WarpKVM/rk628-bridge-boards/rk628-2x22p/images/layer-bottom-copper.png

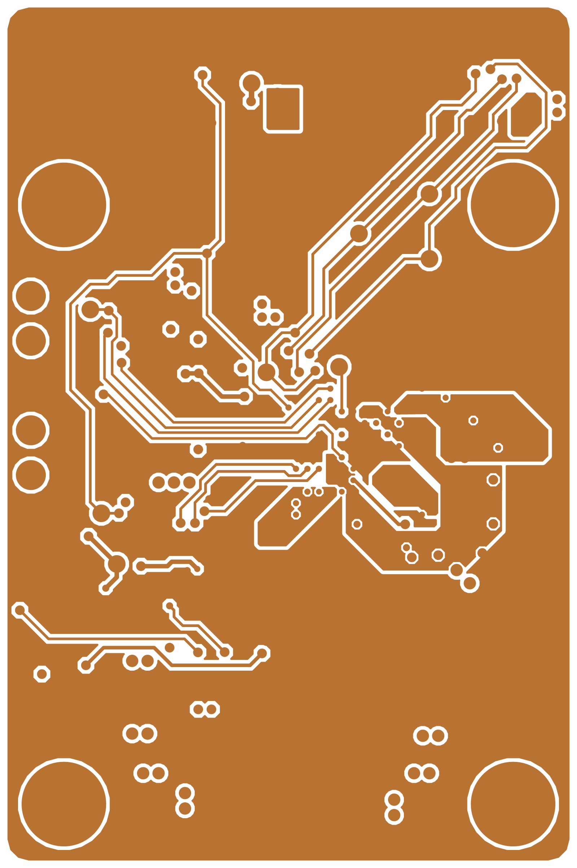
rk628-2x22p/images/layer-bottom-copper.png
