WarpKVM/rk628-bridge-boards/rk628-2x22p/images/layer-bottom-mask.png

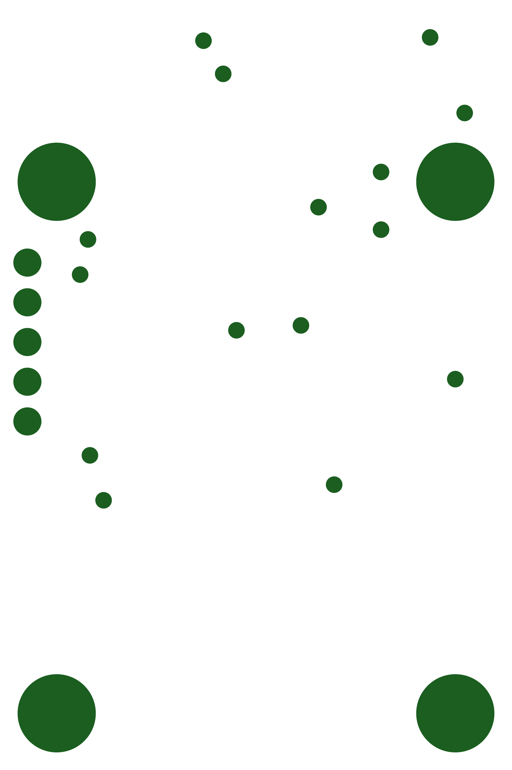
rk628-2x22p/images/layer-bottom-mask.png
