WarpKVM/rk628-bridge-boards/rk628-2x22p/images/layer-bottom-silk.png

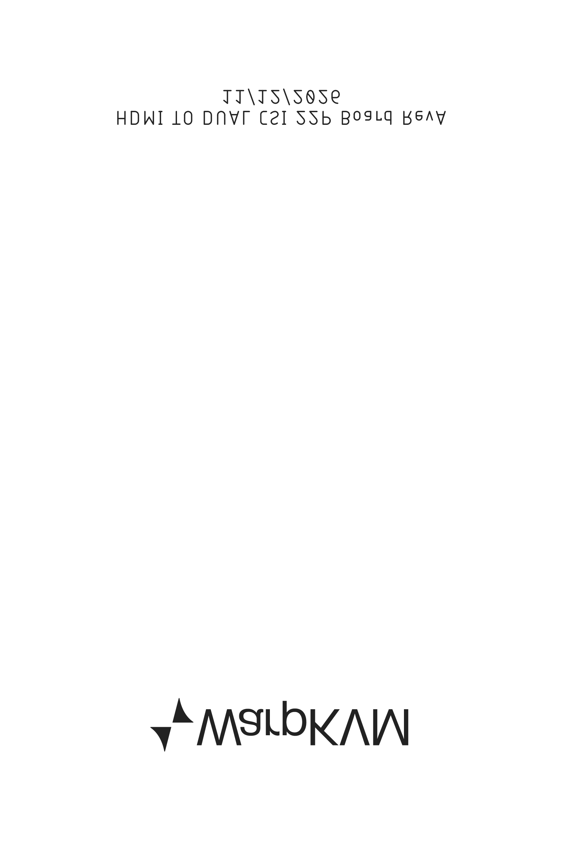
rk628-2x22p/images/layer-bottom-silk.png
