WarpKVM/rk628-bridge-boards/rk628-2x22p/images/layer-l2-inner-copper.png

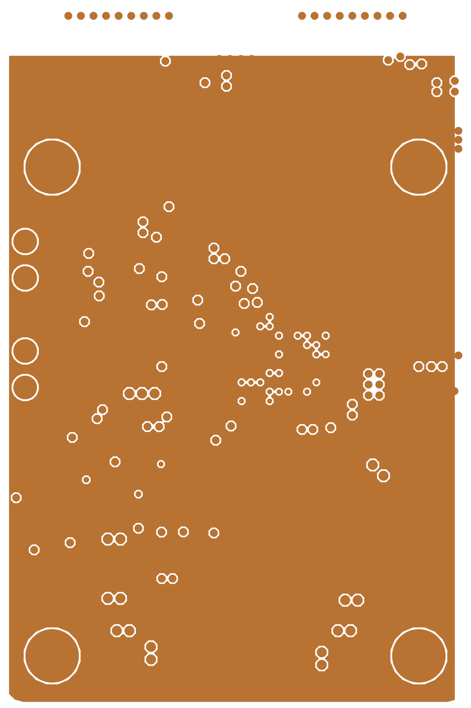
rk628-2x22p/images/layer-l2-inner-copper.png
