WarpKVM/rk628-bridge-boards/rk628-2x22p/images/layer-l3-inner-copper.png

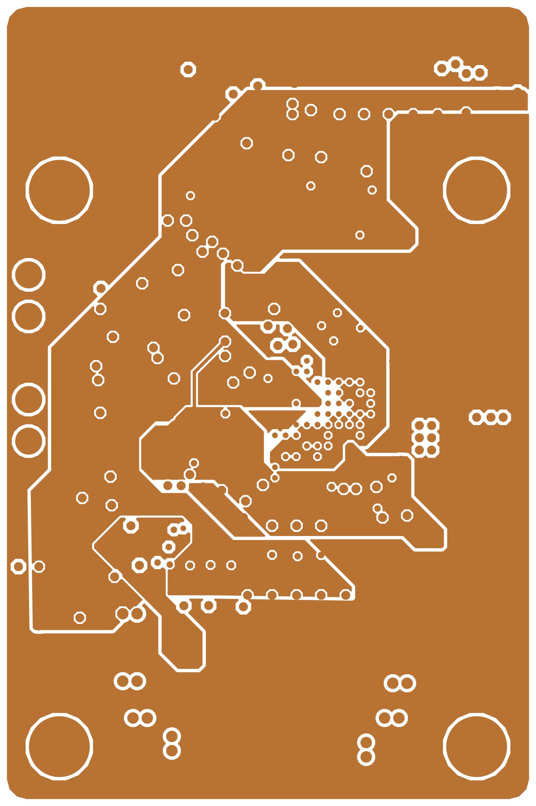
rk628-2x22p/images/layer-l3-inner-copper.png
