WarpKVM/rk628-bridge-boards/rk628-2x22p/images/layer-mechanical-outline.png

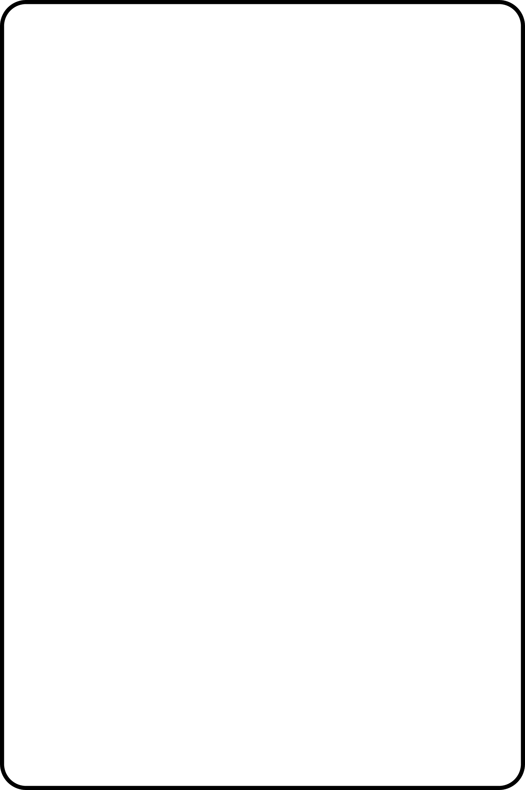
rk628-2x22p/images/layer-mechanical-outline.png
