WarpKVM/rk628-bridge-boards/rk628-2x22p/images/layer-top-copper.png

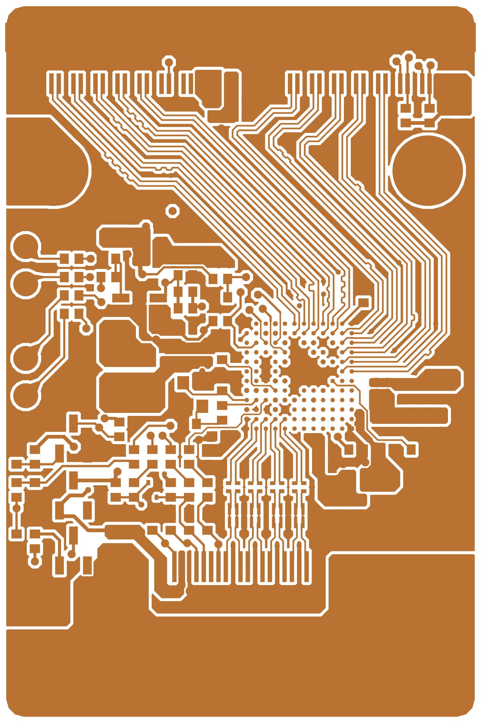
rk628-2x22p/images/layer-top-copper.png
