WarpKVM/rk628-bridge-boards/rk628-2x22p/images/layer-top-mask.png

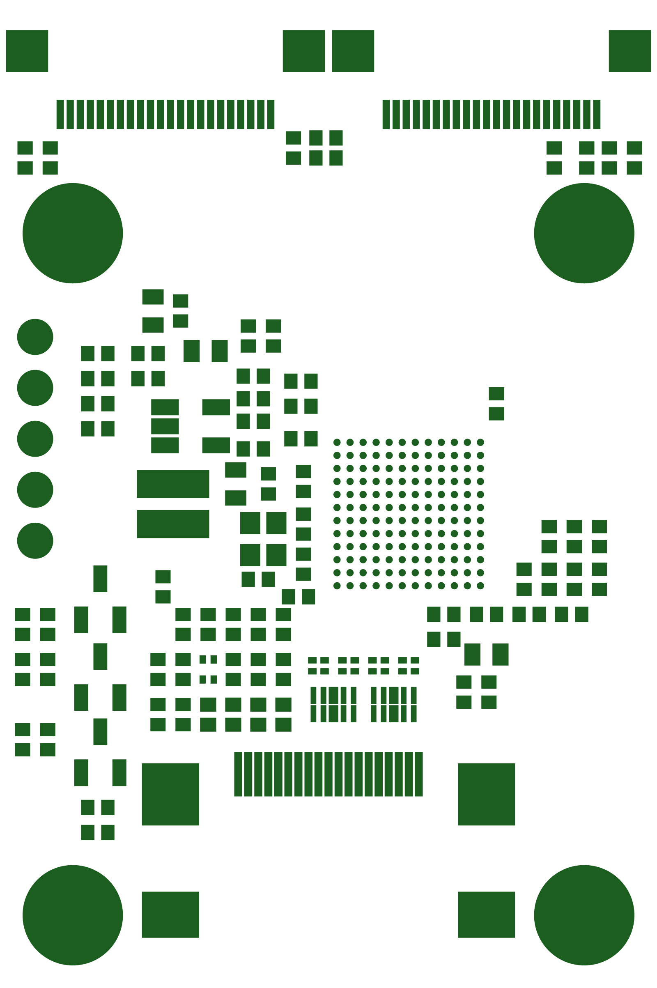
rk628-2x22p/images/layer-top-mask.png
