WarpKVM/rk628-bridge-boards/rk628-2x22p/images/layer-top-paste.png

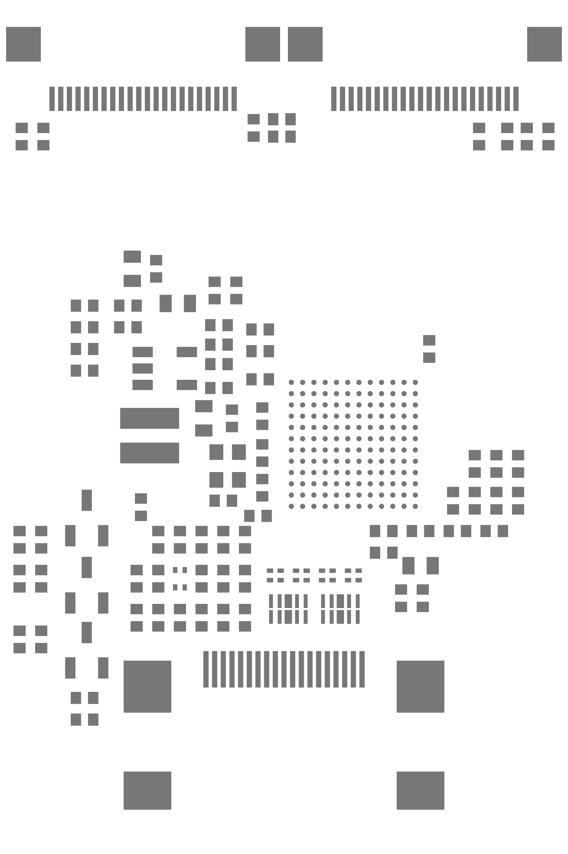
rk628-2x22p/images/layer-top-paste.png
