WarpKVM/rk628-bridge-boards/rk628-2x22p/images/layer-top-silk.png

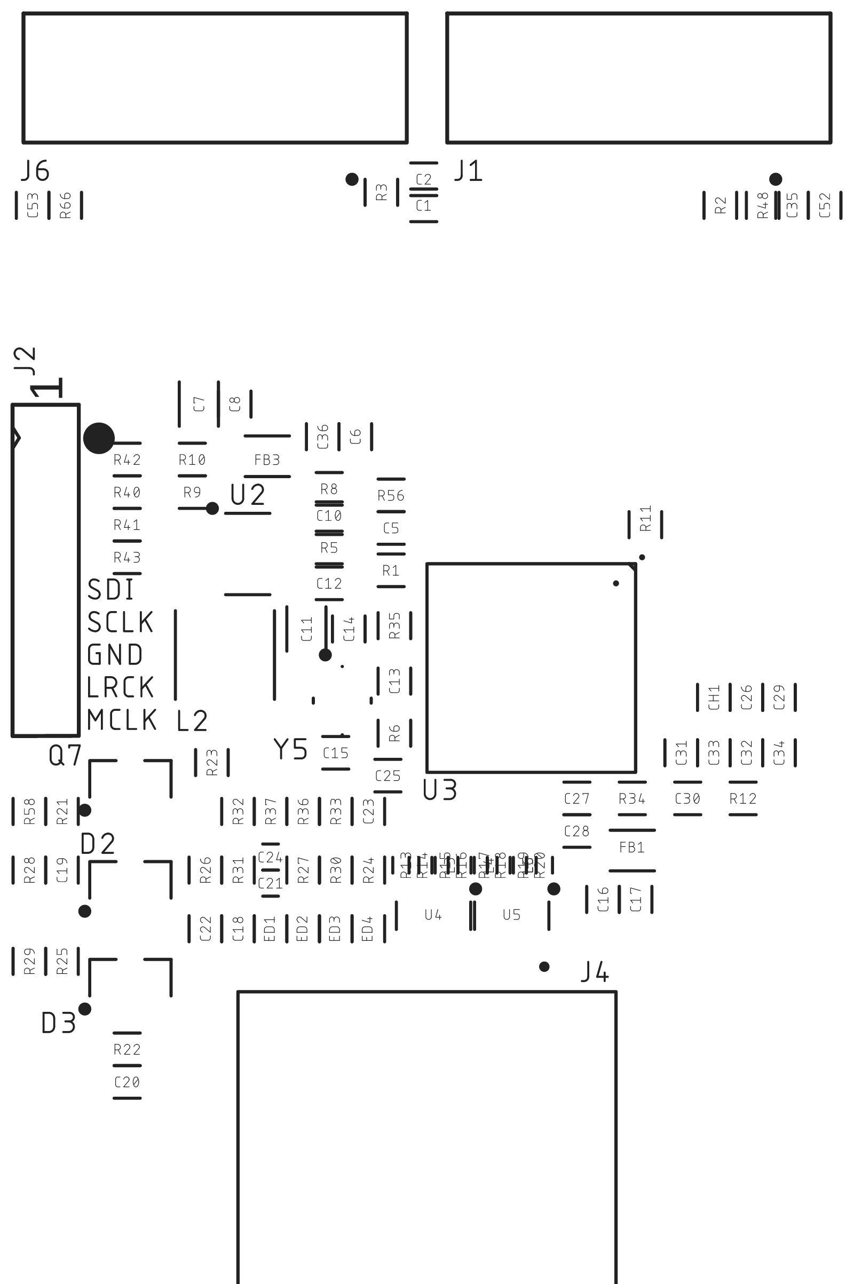
rk628-2x22p/images/layer-top-silk.png
