WarpKVM/rk628-bridge-boards/rk628-2x22p/images/render-bottom-store.png

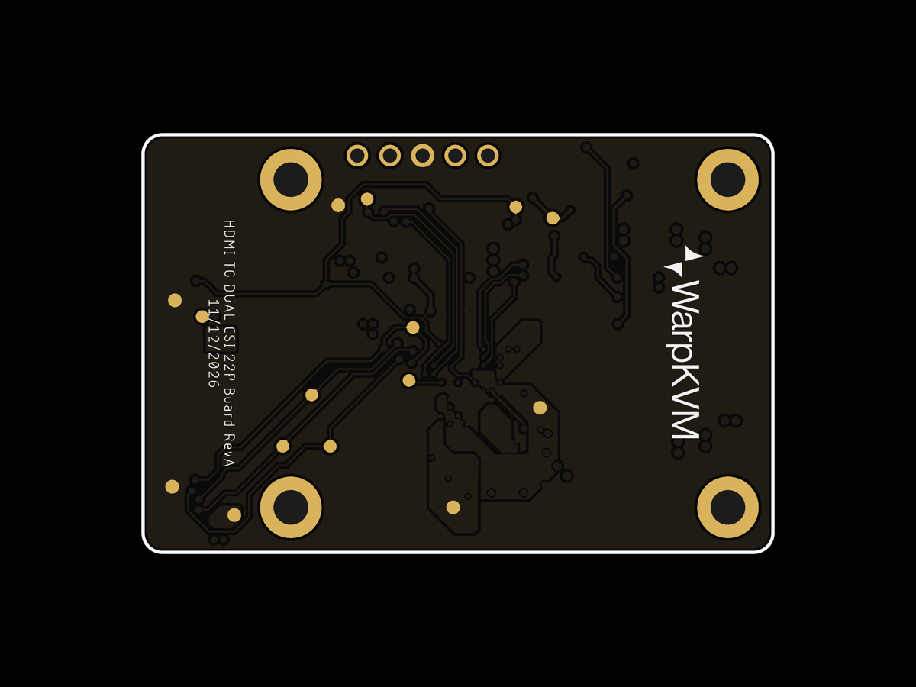
rk628-2x22p/images/render-bottom-store.png
