WarpKVM/rk628-bridge-boards/rk628-2x22p/images/render-bottom.png

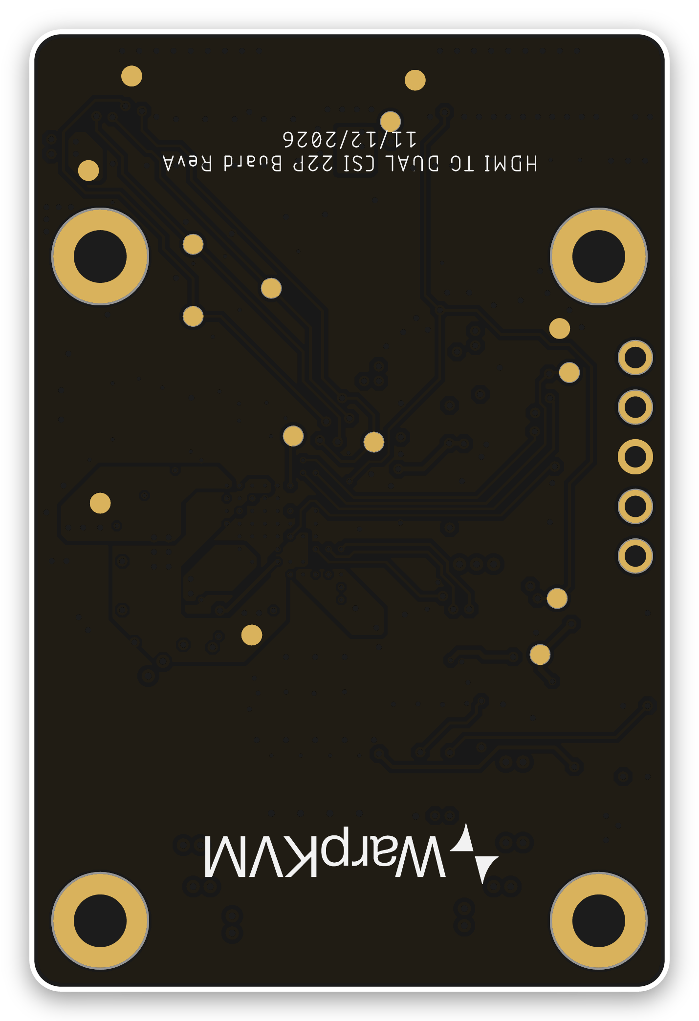
rk628-2x22p/images/render-bottom.png
