WarpKVM/rk628-bridge-boards/rk628-22p/images/layer-bottom-copper.png

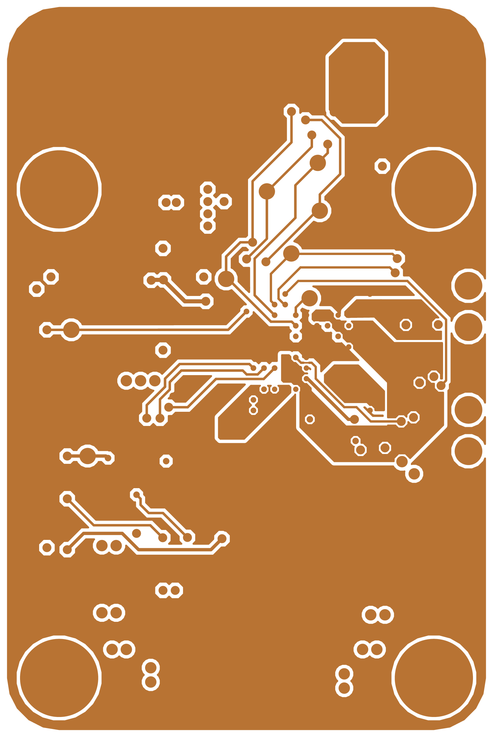
rk628-22p/images/layer-bottom-copper.png
