WarpKVM/rk628-bridge-boards/rk628-22p/images/layer-bottom-mask.png

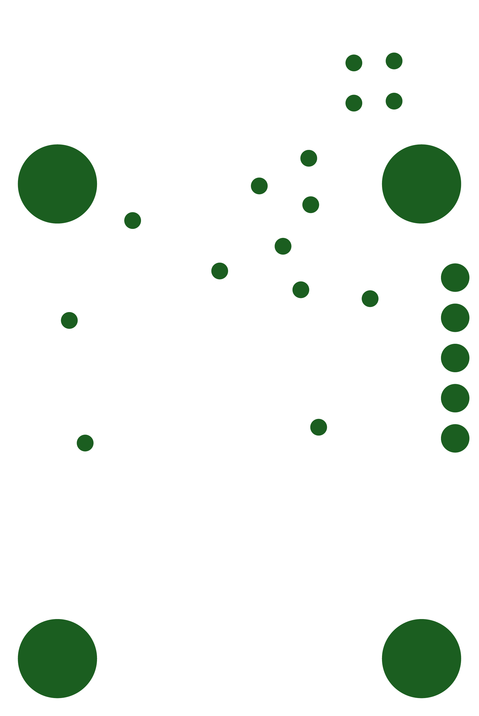
rk628-22p/images/layer-bottom-mask.png
