WarpKVM/rk628-bridge-boards/rk628-22p/images/layer-bottom-silk.png

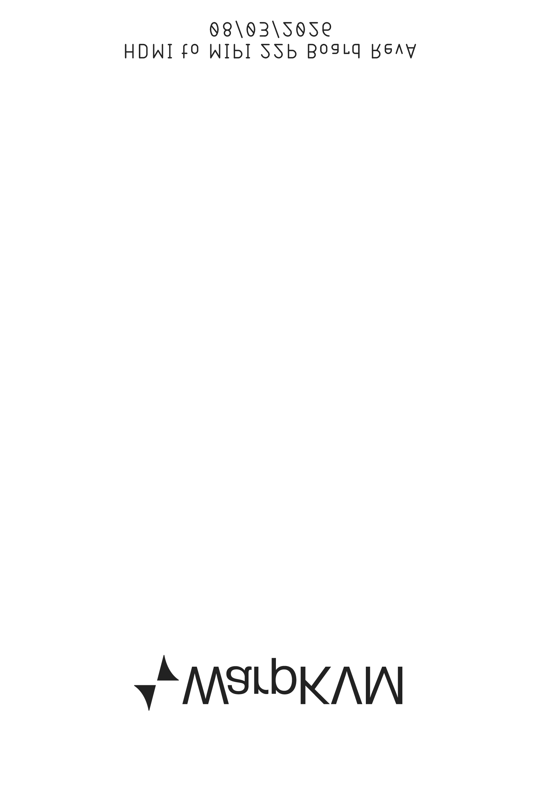
rk628-22p/images/layer-bottom-silk.png
