WarpKVM/rk628-bridge-boards/rk628-22p/images/layer-l2-inner-copper.png

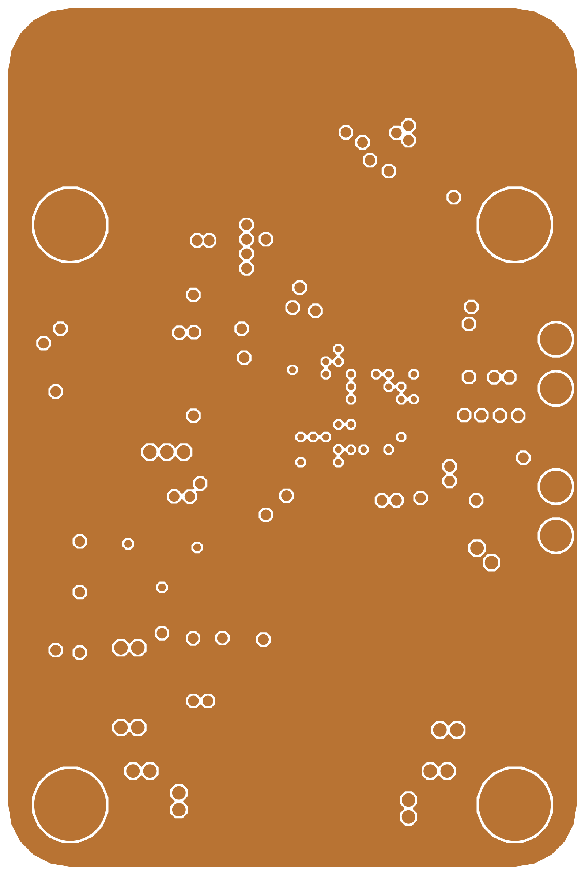
rk628-22p/images/layer-l2-inner-copper.png
