WarpKVM/rk628-bridge-boards/rk628-22p/images/layer-l3-inner-copper.png

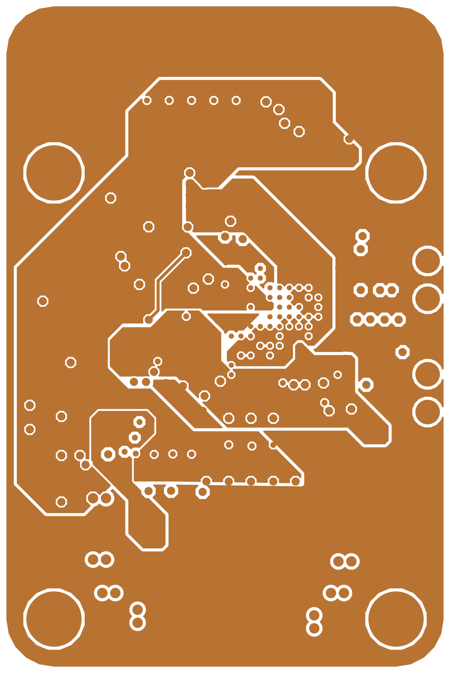
rk628-22p/images/layer-l3-inner-copper.png
