WarpKVM/rk628-bridge-boards/rk628-22p/images/layer-top-copper.png

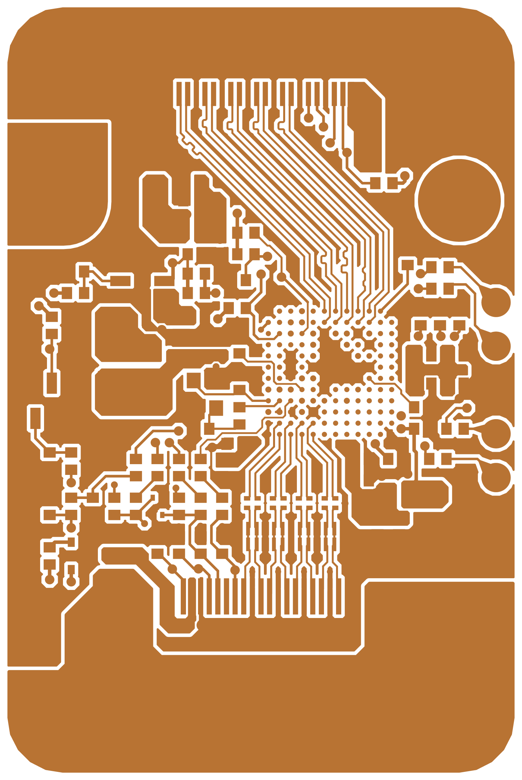
rk628-22p/images/layer-top-copper.png
