WarpKVM/rk628-bridge-boards/rk628-22p/images/layer-top-mask.png

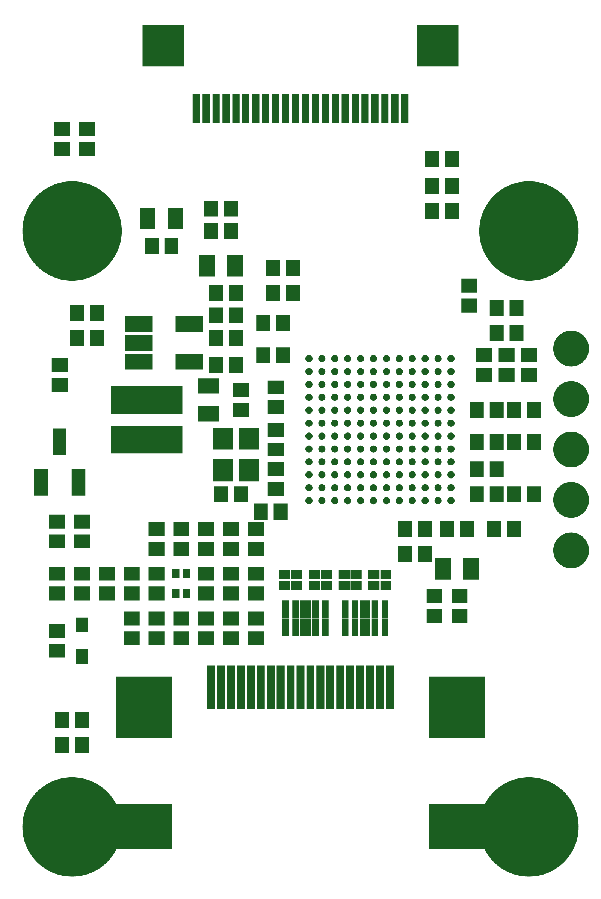
rk628-22p/images/layer-top-mask.png
