WarpKVM/rk628-bridge-boards/rk628-22p/images/layer-top-paste.png

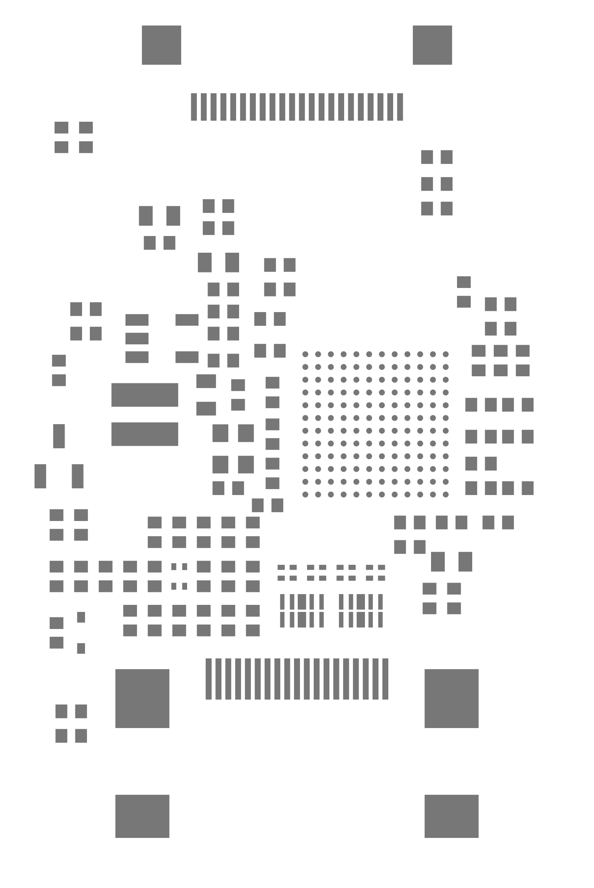
rk628-22p/images/layer-top-paste.png
