WarpKVM/rk628-bridge-boards/rk628-22p/images/layer-top-silk.png

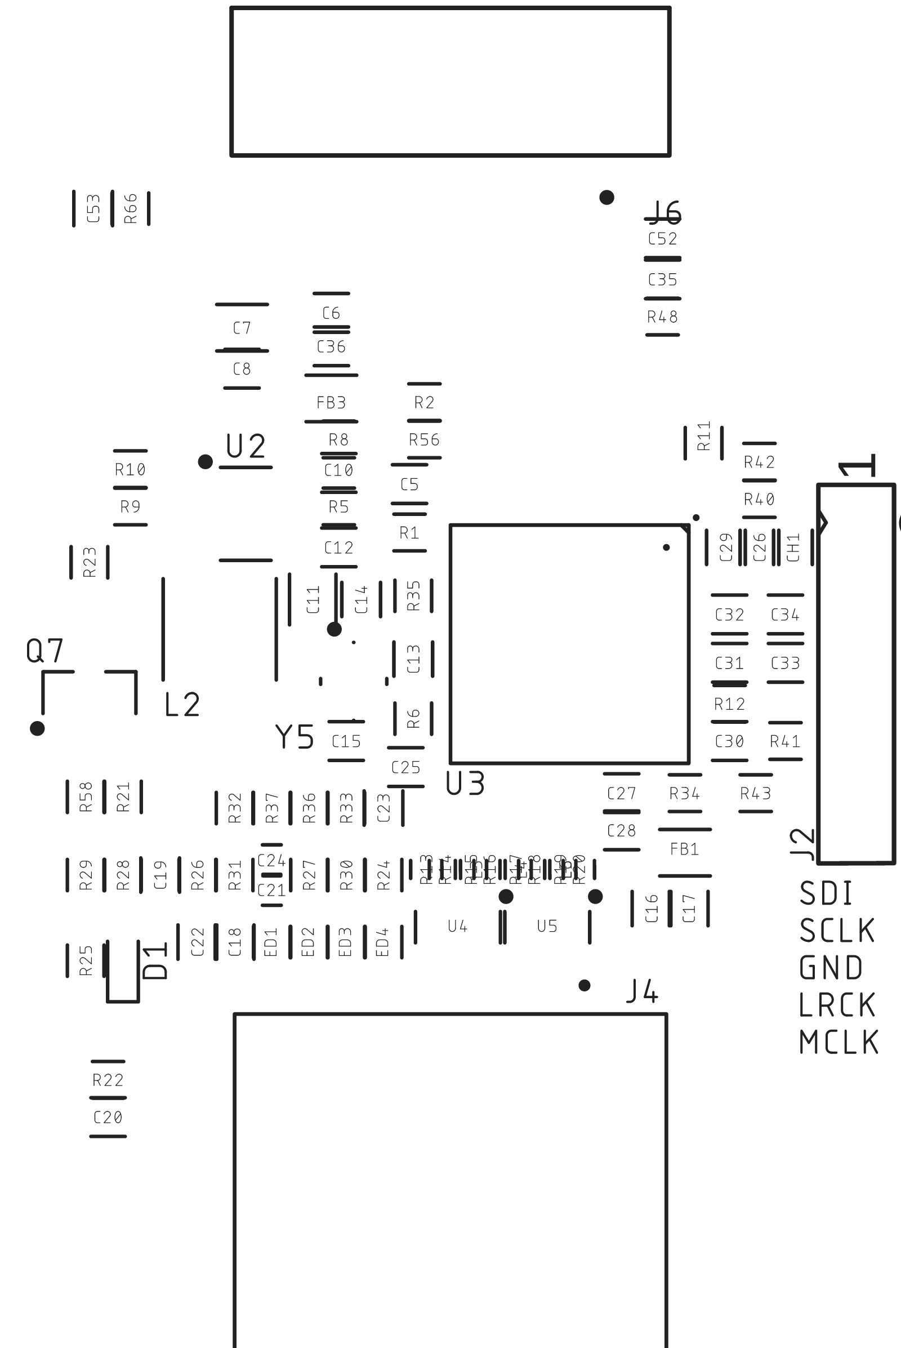
rk628-22p/images/layer-top-silk.png
