WarpKVM/rk628-bridge-boards/rk628-30p/images/layer-bottom-copper.png

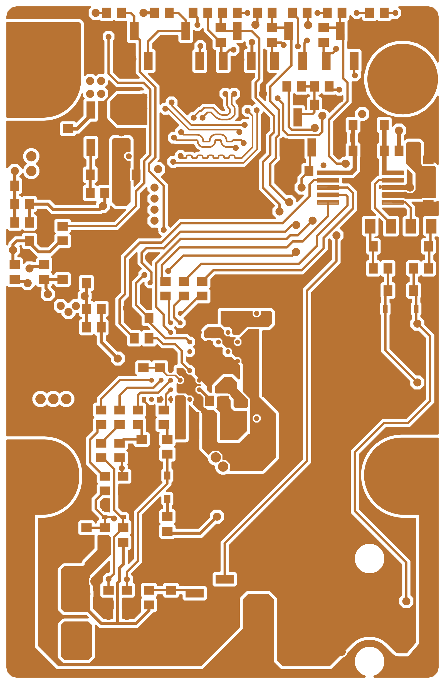
rk628-30p/images/layer-bottom-copper.png
