WarpKVM/rk628-bridge-boards/rk628-30p/images/layer-bottom-mask.png

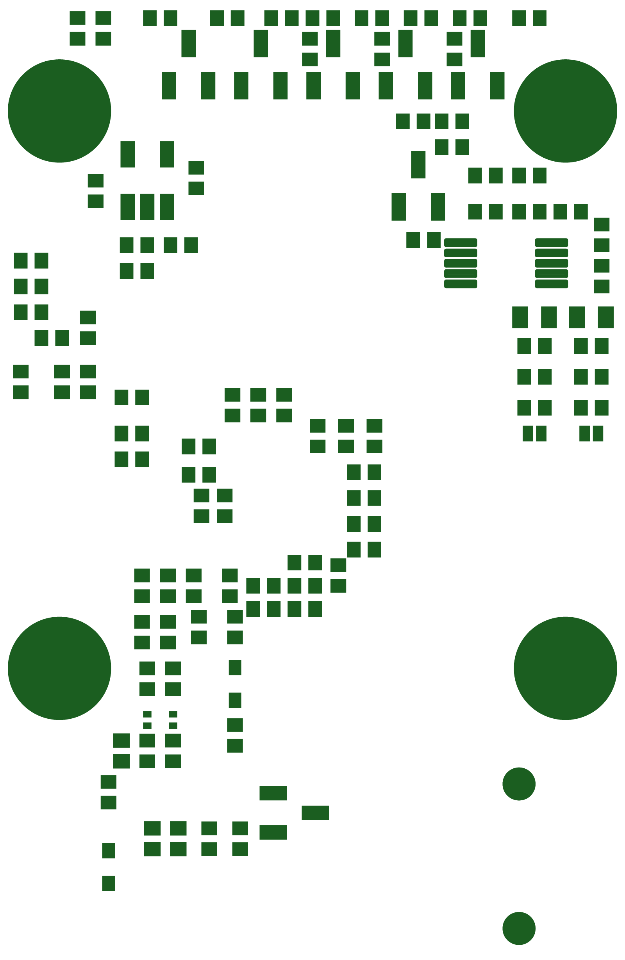
rk628-30p/images/layer-bottom-mask.png
