WarpKVM/rk628-bridge-boards/rk628-30p/images/layer-l2-inner-copper.png

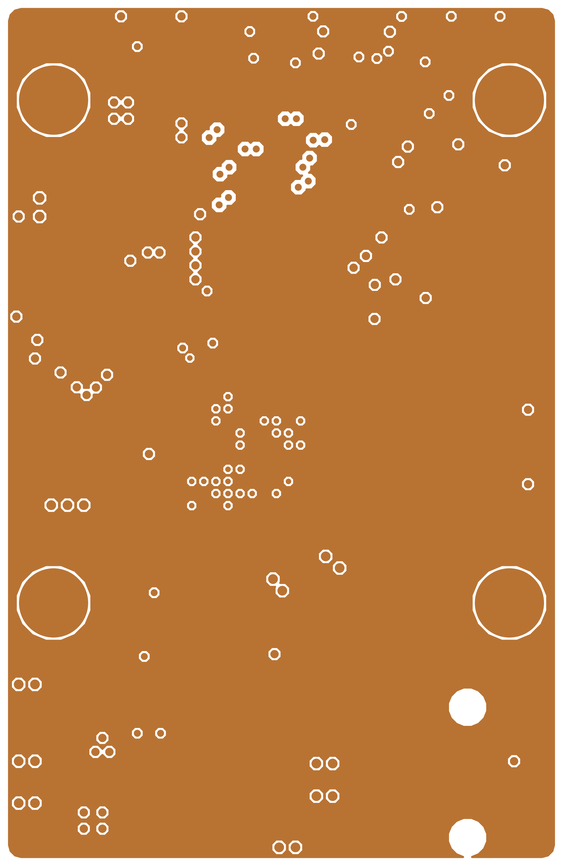
rk628-30p/images/layer-l2-inner-copper.png
