WarpKVM/rk628-bridge-boards/rk628-30p/images/layer-top-paste.png

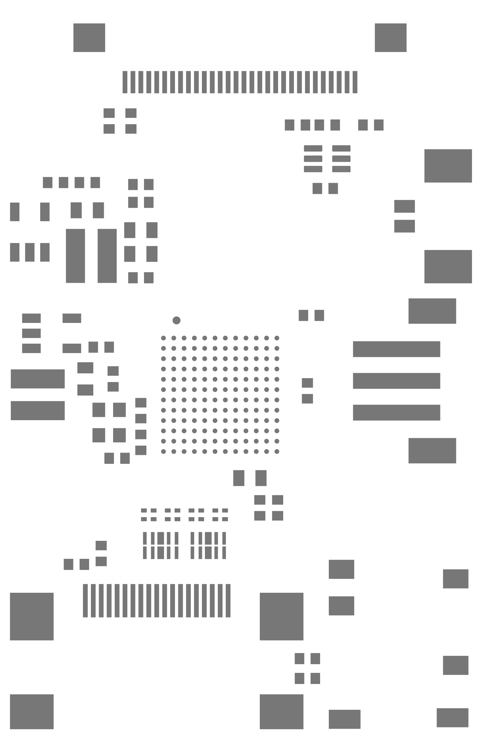
rk628-30p/images/layer-top-paste.png
