WarpKVM/rk628-bridge-boards/rk628-30p/images/layer-top-silk.png

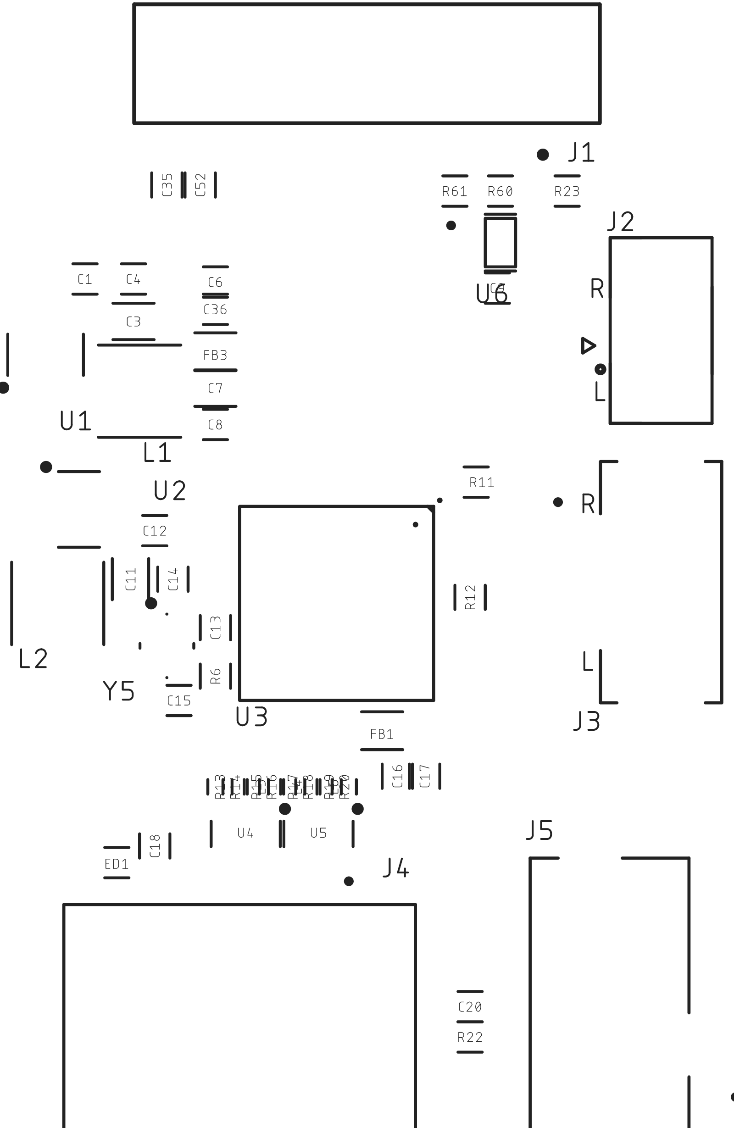
rk628-30p/images/layer-top-silk.png
