WarpKVM/rk628-bridge-boards/rk628-22p/fab/bom-not-fitted.csv

Designator | Value | Footprint | JLCPCB Part # | MF | MP | EQUIV_OK | Reason
C21 | NC/10pF 50V | CAP_0201 |  |  |  |  | NC/ in value
C24 | NC/10pF 50V | CAP_0201 |  |  |  |  | NC/ in value
J2 | NC/1x5 Pin Header | HDR_1X05_2.54MM_TH_ST | C2932699 |  |  |  | NC/ in value
L3 | NC/BCMF062P120T | BCMF062P120T |  |  |  |  | NC/ in value
L4 | NC/BCMF062P120T | BCMF062P120T |  |  |  |  | NC/ in value
L5 | NC/BCMF062P120T | BCMF062P120T |  |  |  |  | NC/ in value
L6 | NC/BCMF062P120T | BCMF062P120T |  |  |  |  | NC/ in value
MNT1 | MOUNTHOLE_M2.5_4.8MM_PAD | MOUNTHOLE_M2.5_4.8MM_PAD |  |  |  |  | MOUNTHOLE in value
MNT2 | MOUNTHOLE_M2.5_4.8MM_PAD | MOUNTHOLE_M2.5_4.8MM_PAD |  |  |  |  | MOUNTHOLE in value
MNT3 | MOUNTHOLE_M2.5_4.8MM_PAD | MOUNTHOLE_M2.5_4.8MM_PAD |  |  |  |  | MOUNTHOLE in value
MNT4 | MOUNTHOLE_M2.5_4.8MM_PAD | MOUNTHOLE_M2.5_4.8MM_PAD |  |  |  |  | MOUNTHOLE in value
R1 | NC/2.2kΩ 1% | RES_0402 | C25879 |  |  |  | NC/ in value
R48 | NC/2.2kΩ 1% | RES_0402 | C25879 |  |  |  | NC/ in value
TP1 | TESTPOINT_1MM | TEST_POINT_1MM |  |  |  |  | TEST_POINT in footprint
TP2 | TESTPOINT_1MM | TEST_POINT_1MM |  |  |  |  | TEST_POINT in footprint
TP3 | TESTPOINT_1MM | TEST_POINT_1MM |  |  |  |  | TEST_POINT in footprint
TP4 | TEST_POINT_1MM_0.5MM | TEST_POINT_1MM |  |  |  |  | TEST_POINT in footprint
TP5 | TESTPOINT_1MM | TEST_POINT_1MM |  |  |  |  | TEST_POINT in footprint
TP6 | TESTPOINT_1MM | TEST_POINT_1MM |  |  |  |  | TEST_POINT in footprint
TP7 | TESTPOINT_1MM | TEST_POINT_1MM |  |  |  |  | TEST_POINT in footprint
TP8 | TESTPOINT_1MM | TEST_POINT_1MM |  |  |  |  | TEST_POINT in footprint
TP9 | TESTPOINT_1MM | TEST_POINT_1MM |  |  |  |  | TEST_POINT in footprint
TP10 | TESTPOINT_1MM | TEST_POINT_1MM |  |  |  |  | TEST_POINT in footprint
TP11 | TESTPOINT_1MM | TEST_POINT_1MM |  |  |  |  | TEST_POINT in footprint
TP12 | TEST_POINT_1MM_0.5MM | TEST_POINT_1MM |  |  |  |  | TEST_POINT in footprint
TP13 | TEST_POINT_1MM_0.5MM | TEST_POINT_1MM |  |  |  |  | TEST_POINT in footprint
TP14 | TEST_POINT_1MM_0.5MM | TEST_POINT_1MM |  |  |  |  | TEST_POINT in footprint
TP15 | TEST_POINT_1MM_0.5MM | TEST_POINT_1MM |  |  |  |  | TEST_POINT in footprint
