WarpKVM/rk628-bridge-boards/rk628-30p/fab/bom-not-fitted.csv

Designator | Value | Footprint | JLCPCB Part # | MF | MP | EQUIV_OK | Reason
C21 | NC/10pF 50V | CAP_0201 |  |  |  |  | NC/ in value
C24 | NC/10pF 50V | CAP_0201 |  |  |  |  | NC/ in value
L3 | NC/BCMF062P120T | BCMF062P120T |  |  |  |  | NC/ in value
L4 | NC/BCMF062P120T | BCMF062P120T |  |  |  |  | NC/ in value
L5 | NC/BCMF062P120T | BCMF062P120T |  |  |  |  | NC/ in value
L6 | NC/BCMF062P120T | BCMF062P120T |  |  |  |  | NC/ in value
MNT1 | MOUNTHOLE_M2.5_4.8MM_PAD | MOUNTHOLE_M2.5_4.8MM_PAD |  |  |  |  | MOUNTHOLE in value
MNT2 | MOUNTHOLE_M2.5_4.8MM_PAD | MOUNTHOLE_M2.5_4.8MM_PAD |  |  |  |  | MOUNTHOLE in value
MNT3 | MOUNTHOLE_M2.5_4.8MM_PAD | MOUNTHOLE_M2.5_4.8MM_PAD |  |  |  |  | MOUNTHOLE in value
MNT4 | MOUNTHOLE_M2.5_4.8MM_PAD | MOUNTHOLE_M2.5_4.8MM_PAD |  |  |  |  | MOUNTHOLE in value
R7 | NC/2.2kΩ 1% | RES_0402 | C25879 |  |  |  | NC/ in value
R49 | NC/0Ω 1% | RES_0402 | C17168 |  |  |  | NC/ in value
R50 | NC/2.2kΩ 1% | RES_0402 | C25879 |  |  |  | NC/ in value
R52 | NC/0Ω 1% | RES_0402 | C17168 |  |  |  | NC/ in value
R53 | NC/2.2kΩ 1% | RES_0402 | C25879 |  |  |  | NC/ in value
R55 | NC/0Ω 1% | RES_0402 | C17168 |  |  |  | NC/ in value
R59 | NC/1kΩ 1% | RES_0402 |  |  |  |  | NC/ in value
R60 | NC/0Ω 1% | RES_0402 | C17168 |  |  |  | NC/ in value
R61 | NC/1MΩ 1% | RES_0402 | C26083 |  |  |  | NC/ in value
R63 | NC/100kΩ 1% | RES_0402 | C25741 |  |  |  | NC/ in value
TP1 | TEST_POINT_1MM | TEST_POINT_0.5MM |  |  |  |  | TEST_POINT in footprint
TP2 | TEST_POINT_1MM | TEST_POINT_0.5MM |  |  |  |  | TEST_POINT in footprint
TP3 | TEST_POINT_1MM | TEST_POINT_0.5MM |  |  |  |  | TEST_POINT in footprint
TP4 | TEST_POINT_1MM_0.5MM | TEST_POINT_0.5MM |  |  |  |  | TEST_POINT in footprint
U9 | NC/ME2808A33XG | SOT-23-3 | C2925762 | MICRONE(Nanjing Micro One Elec) | ME2808A33XG |  | NC/ in value
