WarpKVM/rk628-bridge-boards/rk628-22p/fab/assembly/partlist.txt

Partlist: RK628H 22P Board RevA

Qty Value                    Device                                             Package                                   Parts                                                                                  Description                         JLC-ROTATION JLC-X-OFFSET JLC-Y-OFFSET JLCPCB    JLC_FOOTPRINT JLC_PARTS_TYPE MF                                   MP                   VALUE            

18  0.1uF 16V                CAP_0402_0.1UF_16V_X7R                             CAP_0402                                  C5, C8, C14, C16, C18, C19, C20, C25, C27, C29, C30, C31, C32, C34, C35, C36, C53, CH1                                                                            C1525                   BASIC          Samsung Electro-Mechanics            CL05B104KO5NNNC      0.1uF 16V        

1   0.5K-GX-22PWB-R          CONN_FFC_1X22_SH_0.5MM_SM_RA_0.5K-GX-22PWB-R       CONN_FFC_1X22_0.5MM_SM_RA_0.5K-GX-22PWB-R J6                                                                                                                                                                C53223210                              GUOCONN                              0.5K-GX-22PWB-R      0.5K-GX-22PWB-R  

2   1.8kO 1%                 RES_0402_1K8_1%                                    RES_0402                                  R26, R27                                                                                                                                                          C2909310                               FOJAN                                FRC0402F1801TS       1.8kO 1%         

2   100kO 1%                 RES_0402_100K_1%_1/16W                             RES_0402                                  R10, R29                                                                                                                                                          C25741                  Basic          UNI-ROYAL(Uniroyal Elec)             0402WGF1003TCE       100kO 1%         

1   100pF 50V                CAP_0402_100PF_50V_NP0                             CAP_0402                                  C10                                                                                                                                                               C106200                                YAGEO                                CC0402JRNPO9BN101    100pF 50V        

4   100O 1%                  RES_0402_100R_1%                                   RES_0402                                  R24, R30, R31, R35                                                                                                                                                C25076                  Basic          UNI-ROYAL(Uniroyal Elec)             0402WGF1000TCE       100O 1%          

4   10kO 1%                  RES_0402_10K_1%_1/16W                              RES_0402                                  R9, R12, R21, R56                                                                                                                                                 C2906861                               FOJAN                                FRC0402F1002TS       10kO 1%          

8   10uF 10V                 CAP_0402_10UF_10V_X5R                              CAP_0402                                  C6, C12, C17, C23, C26, C28, C33, C52                                                                                                                             C315248                                Samsung Electro-Mechanics            CL05A106MP5NUNC      10uF 10V         

1   110kO 1%                 RES_0402_110K_1%                                   RES_0402                                  R5                                                                                                                                                                C2909311                               FOJAN                                FRC0402F1103TS       110kO 1%         

1   120kO 1%                 RES_0402_120K_1%                                   RES_0402                                  R8                                                                                                                                                                C2909314                               FOJAN                                FRC0402F1203TS       120kO 1%         

2   120O 2A                  FERRITE_0603_120R_2A                               IND_0603                                  FB1, FB3                                                                                                                                                          C14709    TRUE          Basic          Murata Electronics                   BLM18PG121SN1D       120O 2A          

2   1MO 1%                   RES_0402_1M_1%                                     RES_0402                                  R22, R66                                                                                                                                                          C26083                  Basic          UNI-ROYAL(Uniroyal Elec)             0402WGF1004TCE       1MO 1%           

1   1kO 1%                   RES_0402_1K_1%                                     RES_0402                                  R28                                                                                                                                                               C106235                                YAGEO                                RC0402FR-071KL       1kO 1%           

1   1uF 25V                  CAP_0402_1UF_25V_X5R                               CAP_0402                                  C22                                                                                                                                                               C52923                  Basic          Samsung Electro-Mechanics            CL05A105KA5NQNC      1uF 25V          

1   2.2kO 1%                 RES_0402_2K2_1%                                    RES_0402                                  R2                                                                                                                                                                C25879                  Basic          UNI-ROYAL(Uniroyal Elec)             0402WGF2201TCE       2.2kO 1%         

1   2.2uH 2.84A              IND_3MM_SQ_2.2UH_2.84A_1.2MM_HEIGHT                IND_3MM_SQ_1.2MM_HEIGHT                   L2                                                                                                                                                                C404494                                TDK                                  VLS3012HBX-2R2M      2.2uH 2.84A      

8   2.2O 5%                  RES_0201_2R2_5%                                    RES_0201                                  R13, R14, R15, R16, R17, R18, R19, R20                                                                                                                            C102714                                UNI-ROYAL(Uniroyal Elec)             0201WMJ022JTEE       2.2O 5%          

2   22uF 10V                 CAP_0603_22UF_10V_X5R                              CAP_0603                                  C7, C11                                                                                                                                                           C7432770                               Chinocera                            HGC0603R5226M100NTHJ 22uF 10V         

5   22O 1%                   RES_0402_22R_1%                                    RES_0402                                  R6, R32, R33, R36, R37                                                                                                                                            C25092                  Basic          UNI-ROYAL(Uniroyal Elec)             0402WGF220JTCE       22O 1%           

1   24MHz 20pF               CRYSTAL_SMD2016-4P_24MHZ_20PF_10PPM_T201624MLBDE2X CRYSTAL_SMD2016-4P                        Y5                                                                                                                                                                C20885025                              Yajingxin                            T201624MLBDE2X       24MHz 20pF       

1   27kO 1%                  RES_0402_27K_1%                                    RES_0402                                  R25                                                                                                                                                               C138022                                YAGEO                                RC0402FR-0727KL      27kO 1%          

1   2kO 1%                   RES_0402_2K_1%_1/16W                               RES_0402                                  R34                                                                                                                                                               C4109                   Basic          UNI-ROYAL(Uniroyal Elec)             0402WGF2001TCE       2kO 1%           

2   33pF 50V                 CAP_0402_33PF_50V                                  CAP_0402                                  C13, C15                                                                                                                                                          C1562                                  FH (Guangdong Fenghua Advanced Tech) 0402CG330J500NT      33pF 50V         

4   33O 1%                   RES_0402_33R_1%                                    RES_0402                                  R40, R41, R42, R43                                                                                                                                                C25105                  Basic          UNI-ROYAL(Uniroyal Elec)             0402WGF330JTCE       33O 1%           

1   4.02kO 1%                RES_0402_4K02_1%                                   RES_0402                                  R11                                                                                                                                                               C324800                                FH (Guangdong Fenghua Advanced Tech) RC-02K4021FT         4.02kO 1%        

1   4.7kO 1%                 RES_0402_4K7_1%                                    RES_0402                                  R23                                                                                                                                                               C105871                                YAGEO                                RC0402FR-074K7L      4.7kO 1%         

1   51kO 1%                  RES_0402_51K_1%                                    RES_0402                                  R58                                                                                                                                                               C25794                  Basic          UNI-ROYAL(Uniroyal Elec)             0402WGF5102TCE       51kO 1%          

2   BTRD10A03                TVS_ESD_4CH_10P_PASS_THRU_BTRD10A03                DFN2510-10                                U4, U5                                                                                 ESD and Surge protection diodes TVS                                        C42375217 TRUE                         KUU                                  BTRD10A03            BTRD10A03        

1   HC-HDMI0019T-4           CONN_HDMI_A_HC-HDMI0019T-4                         CONN_HDMI_A_SMT_RA_HC-HDMI0019T-4         J4                                                                                                                                                   2.75         C7501811                               Hong Cheng                           HC-HDMI0019T-4       HC-HDMI0019T-4   

4   KLXES15AAA1              TVS_ESD_1CH_BI_KLXES15AAA1                         TVS_0402                                  ED1, ED2, ED3, ED4                                                                                                                                                C2892490                               KUU                                  KLXES15AAA1          KLXES15AAA1      

4   MOUNTHOLE_M2.5_4.8MM_PAD MOUNTHOLE_M2.5_4.8MM_PAD                           MOUNTHOLE_M2.5_4.8MM_PAD                  MNT1, MNT2, MNT3, MNT4                                                                                                                                                                                                                                                              

2   NC/10pF 50V              CAP_0201_DNP_10PF_50V                              CAP_0201                                  C21, C24                                                                                                                                                                                                                                                           NC/10pF 50V      

1   NC/1x5 Pin Header        HDR_1X05_DNP_2.54MM_TH_ST                          HDR_1X05_2.54MM_TH_ST                     J2                                                                                                                         0            5.08         0            C2932699                                                                                         NC/1x5 Pin Header

2   NC/2.2kO 1%              RES_0402_DNP_2K2_1%                                RES_0402                                  R1, R48                                                                                                                                                           C25879                  Basic                                                                    NC/2.2kO 1%      

4   NC/BCMF062P120T          BCMF062P120T_BCMF062P120T_NC                       BCMF062P120T                              L3, L4, L5, L6                                                                                                                                                                                                                                                     NC/BCMF062P120T  

1   RK628H                   IF_VIDEO_BRIDGE_RK628F/H_RK628H                    WBBGA144_8X8MM                            U3                                                                                                                                                                C45369093                              Rockchip                             RK628H               RK628H           

1   S8050                    NPN_S8050                                          SOT-23-3                                  Q7                                                                                                                                                                C2146                                                                                            S8050            

1   SD103AX                  SD103AX                                            SD103AX                                   D1                                                                                                                                                                C20416650                              BORN                                 SD103AX              SD103AX          

1   SY8089A1AAC              SY8089A1AAC_SY8089A1AAC                            SOT95P285X110-5N                          U2                                                                                                                         180          0            0            C479074                                Silergy Corp                         SY8089A1AAC          SY8089A1AAC      

10  TESTPOINT_1MM            TESTPOINT_1MM                                      TEST_POINT_1MM                            TP1, TP2, TP3, TP5, TP6, TP7, TP8, TP9, TP10, TP11                                                                                                                                                                                                                                  

5   TEST_POINT_1MM_0.5MM     TESTPOINT_1MM                                      TEST_POINT_1MM                            TP4, TP12, TP13, TP14, TP15
