WarpKVM/rk628-bridge-boards/rk628-22p/fab/bom-jlcpcb.csv

QTY | Comment | Designator | Footprint | JLCPCB Part #(optional) | MF | MP | EQUIV_OK
18 | 0.1uF 16V | C5, C8, C14, C16, C18, C19, C20, C25, C27, C29, C30, C31, C32, C34, C35, C36, C53, CH1 | CAP_0402 | C1525 | Samsung Electro-Mechanics | CL05B104KO5NNNC
8 | 10uF 10V | C6, C12, C17, C23, C26, C28, C33, C52 | CAP_0402 | C315248 | Samsung Electro-Mechanics | CL05A106MP5NUNC
2 | 22uF 10V | C7, C11 | CAP_0603 | C7432770 | Chinocera | HGC0603R5226M100NTHJ
1 | 100pF 50V | C10 | CAP_0402 | C106200 | YAGEO | CC0402JRNPO9BN101
2 | 33pF 50V | C13, C15 | CAP_0402 | C1562 | FH (Guangdong Fenghua Advanced Tech) | 0402CG330J500NT
1 | 1uF 25V | C22 | CAP_0402 | C52923 | Samsung Electro-Mechanics | CL05A105KA5NQNC
1 | SD103AX | D1 | SD103AX | C20416650 | BORN | SD103AX
4 | KLXES15AAA1 | ED1, ED2, ED3, ED4 | TVS_0402 | C2892490 | KUU | KLXES15AAA1
2 | 120Ω 2A | FB1, FB3 | IND_0603 | C14709 | Murata Electronics | BLM18PG121SN1D
1 | HC-HDMI0019T-4 | J4 | CONN_HDMI_A_SMT_RA_HC-HDMI0019T-4 | C7501811 | Hong Cheng | HC-HDMI0019T-4
1 | 0.5K-GX-22PWB-R | J6 | CONN_FFC_1X22_0.5MM_SM_RA_0.5K-GX-22PWB-R | C53223210 | GUOCONN | 0.5K-GX-22PWB-R
1 | 2.2uH 2.84A | L2 | IND_3MM_SQ_1.2MM_HEIGHT | C404494 | TDK | VLS3012HBX-2R2M
1 | S8050 | Q7 | SOT-23-3 | C2146
1 | 2.2kΩ 1% | R2 | RES_0402 | C25879 | UNI-ROYAL(Uniroyal Elec) | 0402WGF2201TCE
1 | 110kΩ 1% | R5 | RES_0402 | C2909311 | FOJAN | FRC0402F1103TS
5 | 22Ω 1% | R6, R32, R33, R36, R37 | RES_0402 | C25092 | UNI-ROYAL(Uniroyal Elec) | 0402WGF220JTCE
1 | 120kΩ 1% | R8 | RES_0402 | C2909314 | FOJAN | FRC0402F1203TS
4 | 10kΩ 1% | R9, R12, R21, R56 | RES_0402 | C2906861 | FOJAN | FRC0402F1002TS
2 | 100kΩ 1% | R10, R29 | RES_0402 | C25741 | UNI-ROYAL(Uniroyal Elec) | 0402WGF1003TCE
1 | 4.02kΩ 1% | R11 | RES_0402 | C324800 | FH (Guangdong Fenghua Advanced Tech) | RC-02K4021FT
8 | 2.2Ω 5% | R13, R14, R15, R16, R17, R18, R19, R20 | RES_0201 | C102714 | UNI-ROYAL(Uniroyal Elec) | 0201WMJ022JTEE
2 | 1MΩ 1% | R22, R66 | RES_0402 | C26083 | UNI-ROYAL(Uniroyal Elec) | 0402WGF1004TCE
1 | 4.7kΩ 1% | R23 | RES_0402 | C105871 | YAGEO | RC0402FR-074K7L
4 | 100Ω 1% | R24, R30, R31, R35 | RES_0402 | C25076 | UNI-ROYAL(Uniroyal Elec) | 0402WGF1000TCE
1 | 27kΩ 1% | R25 | RES_0402 | C138022 | YAGEO | RC0402FR-0727KL
2 | 1.8kΩ 1% | R26, R27 | RES_0402 | C2909310 | FOJAN | FRC0402F1801TS
1 | 1kΩ 1% | R28 | RES_0402 | C106235 | YAGEO | RC0402FR-071KL
1 | 2kΩ 1% | R34 | RES_0402 | C4109 | UNI-ROYAL(Uniroyal Elec) | 0402WGF2001TCE
4 | 33Ω 1% | R40, R41, R42, R43 | RES_0402 | C25105 | UNI-ROYAL(Uniroyal Elec) | 0402WGF330JTCE
1 | 51kΩ 1% | R58 | RES_0402 | C25794 | UNI-ROYAL(Uniroyal Elec) | 0402WGF5102TCE
1 | SY8089A1AAC | U2 | SOT95P285X110-5N | C479074 | Silergy Corp | SY8089A1AAC
1 | RK628H | U3 | WBBGA144_8X8MM | C45369093 | Rockchip | RK628H
2 | BTRD10A03 | U4, U5 | DFN2510-10 | C42375217 | KUU | BTRD10A03
1 | 24MHz 20pF | Y5 | CRYSTAL_SMD2016-4P | C20885025 | Yajingxin | T201624MLBDE2X
