WarpKVM/rk628-bridge-boards/rk628-30p/fab/bom-jlcpcb.csv

QTY | Comment | Designator | Footprint | JLCPCB Part #(optional) | MF | MP | EQUIV_OK
12 | 10uF 10V | C1, C6, C12, C17, C23, C26, C28, C33, C42, C43, C45, C52 | CAP_0402 | C315248 | Samsung Electro-Mechanics | CL05A106MP5NUNC
2 | 100pF 50V | C2, C10 | CAP_0402 | C106200 | YAGEO | CC0402JRNPO9BN101
3 | 22uF 10V | C3, C7, C11 | CAP_0603 | C7432770 | Chinocera | HGC0603R5226M100NTHJ
26 | 0.1uF 16V | C4, C5, C8, C9, C14, C16, C18, C19, C20, C25, C27, C29, C30, C31, C32, C34, C35, C36, C41, C44, C46, C47, C49, C51, C53, CH1 | CAP_0402 | C1525 | Samsung Electro-Mechanics | CL05B104KO5NNNC
2 | 33pF 50V | C13, C15 | CAP_0402 | C1562 | FH (Guangdong Fenghua Advanced Tech) | 0402CG330J500NT
1 | 1uF 25V | C22 | CAP_0402 | C52923 | Samsung Electro-Mechanics | CL05A105KA5NQNC
2 | 4.3nF 10V | C37, C40 | CAP_0402 | C710861
2 | 3.3uF 10V | C38, C39 | CAP_0603 | C51412
2 | 4.7uF 10V | C48, C50 | CAP_0402 | C23733 | Samsung Electro-Mechanics | CL05A475MP5NRNC
2 | SD103AX | D1, D2 | SD103AX | C20416650 | BORN | SD103AX
2 | ESD5451N | D3, D4 | DFN100X60X60-2N | C2934885 | KUU | ESD5451N
4 | KLXES15AAA1 | ED1, ED2, ED3, ED4 | TVS_0402 | C2892490 | KUU | KLXES15AAA1
2 | 120Ω 2A | FB1, FB3 | IND_0603 | C14709 | Murata Electronics | BLM18PG121SN1D
1 | FPC30-T1T1-2021-A | J1 | CONN_FFC_1X30_0.5MM_SM_RA_FPC30-T1T1-2021-A | C52740867 | SHETIME | FPC30-T1T1-2021-A
1 | 53398-0271 | J2 | CONN_1X02_1.25MM_SM_ST_MX_53398-0271 | C122410 | Molex | 53398-0271
1 | B3B-PH-SM4-TB | J3 | CONN_1X03_2.0MM_SM_ST_JST_B3B-PH-SM4-TB(LF)(SN) | C160353
1 | HC-HDMI0019T-4 | J4 | CONN_HDMI_A_SMT_RA_HC-HDMI0019T-4 | C7501811 | Hong Cheng | HC-HDMI0019T-4
1 | PJ-332-6A | J5 | CONN_JACK_STEREO_SW_3.5MM_SM_RA_PJ-332-6A | C962626 | Korean Hroparts Elec | PJ-332-6A
2 | 2.2uH 2.84A | L1, L2 | IND_3MM_SQ_1.2MM_HEIGHT | C404494 | TDK | VLS3012HBX-2R2M
5 | 2SK3018 | Q2, Q3, Q4, Q5, Q6 | SOT-23-3 | C2681369 | Slkor(SLKORMICRO Elec.) | 2SK3018
1 | S8050 | Q7 | SOT-23-3 | C2146 | Jiangsu Changjing Electronics Technology Co., Ltd. | S8050 J3Y(RANGE:200-350)
2 | 51kΩ 1% | R1, R58 | RES_0402 | C25794 | UNI-ROYAL(Uniroyal Elec) | 0402WGF5102TCE
1 | 232kΩ 1% | R2 | RES_0402 | C3013159 | FOJAN | FRC0402F2323TS
2 | 47kΩ 1% | R3, R4 | RES_0402 | C25792 | UNI-ROYAL(Uniroyal Elec) | 0402WGF4702TCE
1 | 110kΩ 1% | R5 | RES_0402 | C2909311 | FOJAN | FRC0402F1103TS
5 | 22Ω 1% | R6, R32, R33, R36, R37 | RES_0402 | C25092 | UNI-ROYAL(Uniroyal Elec) | 0402WGF220JTCE
1 | 120kΩ 1% | R8 | RES_0402 | C2909314 | FOJAN | FRC0402F1203TS
9 | 10kΩ 1% | R9, R12, R21, R38, R45, R47, R56, R57, R64 | RES_0402 | C2906861 | FOJAN | FRC0402F1002TS
2 | 100kΩ 1% | R10, R29 | RES_0402 | C25741 | UNI-ROYAL(Uniroyal Elec) | 0402WGF1003TCE
1 | 4.02kΩ 1% | R11 | RES_0402 | C324800 | FH (Guangdong Fenghua Advanced Tech) | RC-02K4021FT
8 | 2.2Ω 5% | R13, R14, R15, R16, R17, R18, R19, R20 | RES_0201 | C270323 | UNI-ROYAL(Uniroyal Elec) | 0201WMJ022JTEE
2 | 1MΩ 1% | R22, R66 | RES_0402 | C26083 | UNI-ROYAL(Uniroyal Elec) | 0402WGF1004TCE
1 | 4.7kΩ 1% | R23 | RES_0402 | C105871 | YAGEO | RC0402FR-074K7L
4 | 100Ω 1% | R24, R30, R31, R35 | RES_0402 | C25076 | UNI-ROYAL(Uniroyal Elec) | 0402WGF1000TCE
1 | 27kΩ 1% | R25 | RES_0402 | C138022 | YAGEO | RC0402FR-0727KL
2 | 1.8kΩ 1% | R26, R27 | RES_0402 | C2909310 | FOJAN | FRC0402F1801TS
1 | 1kΩ 1% | R28 | RES_0402 | C106235 | YAGEO | RC0402FR-071KL
1 | 2kΩ 1% | R34 | RES_0402 | C4109 | UNI-ROYAL(Uniroyal Elec) | 0402WGF2001TCE
2 | 470Ω 1% | R39, R44 | RES_0402 | C25117
4 | 33Ω 1% | R40, R41, R42, R43 | RES_0402 | C25105 | UNI-ROYAL(Uniroyal Elec) | 0402WGF330JTCE
1 | 10Ω 1% | R46 | RES_0402 | C25077
3 | 2.2kΩ 1% | R48, R51, R54 | RES_0402 | C25879 | UNI-ROYAL(Uniroyal Elec) | 0402WGF2201TCE
1 | 0Ω 1% | R62 | RES_0402 | C17168 | UNI-ROYAL(Uniroyal Elec) | 0402WGF0000TCE
1 | 30kΩ 1% | R65 | RES_0402 | C2909347 |  | FRC0402F3002TS
2 | SY8089A1AAC | U1, U2 | SOT95P285X110-5N | C479074 | Silergy Corp | SY8089A1AAC
1 | RK628H | U3 | WBBGA144_8X8MM | C45369093 | Rockchip | RK628H
2 | BTRD10A03 | U4, U5 | DFN2510-10 | C42375217 | KUU | BTRD10A03
1 | SGM3157YC6 | U6 | SOT65P210X110-6N | C46744 | SGMICRO | SGM3157YC6/TR
1 | GC4344 | U7 | SOP50P490X110-10N | C16197182 | SX-globalchip | GC4344
1 | RT9193-33GB | U8 | SOT95P285X110-5N_ROTATED90 | C15651 | Richtek Tech | RT9193-33GB
1 | 24MHz 20pF | Y5 | CRYSTAL_SMD2016-4P | C20885025 | Yajingxin | T201624MLBDE2X
