WarpKVM/rk628-bridge-boards/(list of files, cad)

Other CAD files:
rk628-22p/cad/RK628H-22P-RevA.f3z
rk628-2x22p/cad/RK628H-2x22P-RevA.f3z
rk628-30p/cad/RK628H-30P-RevA.f3z
