WarpKVM/rk628-bridge-boards/rk628-22p/schematic/RK628H-22P-RevA-schematic.pdf

# HDMI to MIPI CSI (RK628H) Board

11/12/2026 9:34 AM

# RK628H 22P Board RevA.1

groundplane | G

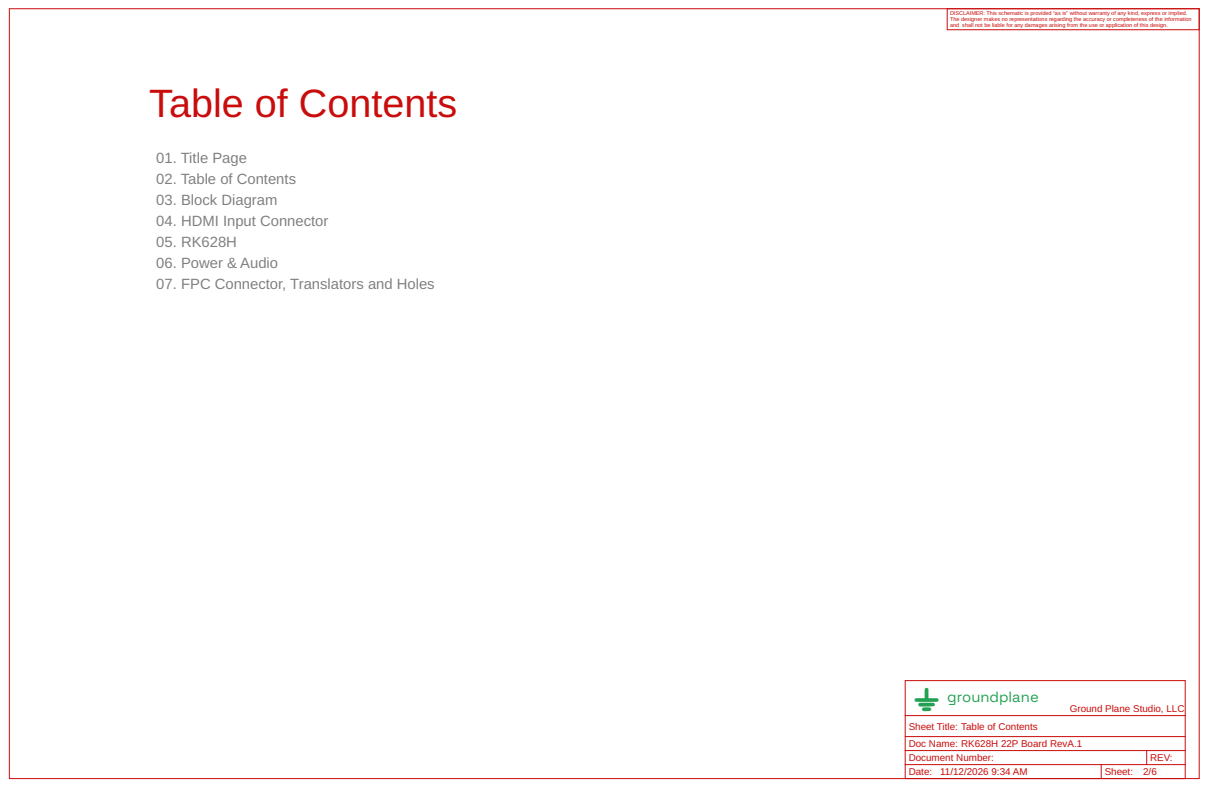
[picture p42: page 2]

DISCLAIMER: This schematic is provided “as is” without warranty of any kind, express or implied. The designer makes no representations regarding the accuracy or completeness of the information

and shall not be liable for any damages arising from the use or application of this design.

01. Title Page
02. Table of Contents
03. Block Diagram
04. HDMI Input Connector
06. Power & Audio
07. FPC Connector, Translators and Holes

Ground Plane Studio, LLC

Document Number: | REV:
Date: 11/12/2026 9:34 AM | Sheet: 2/6

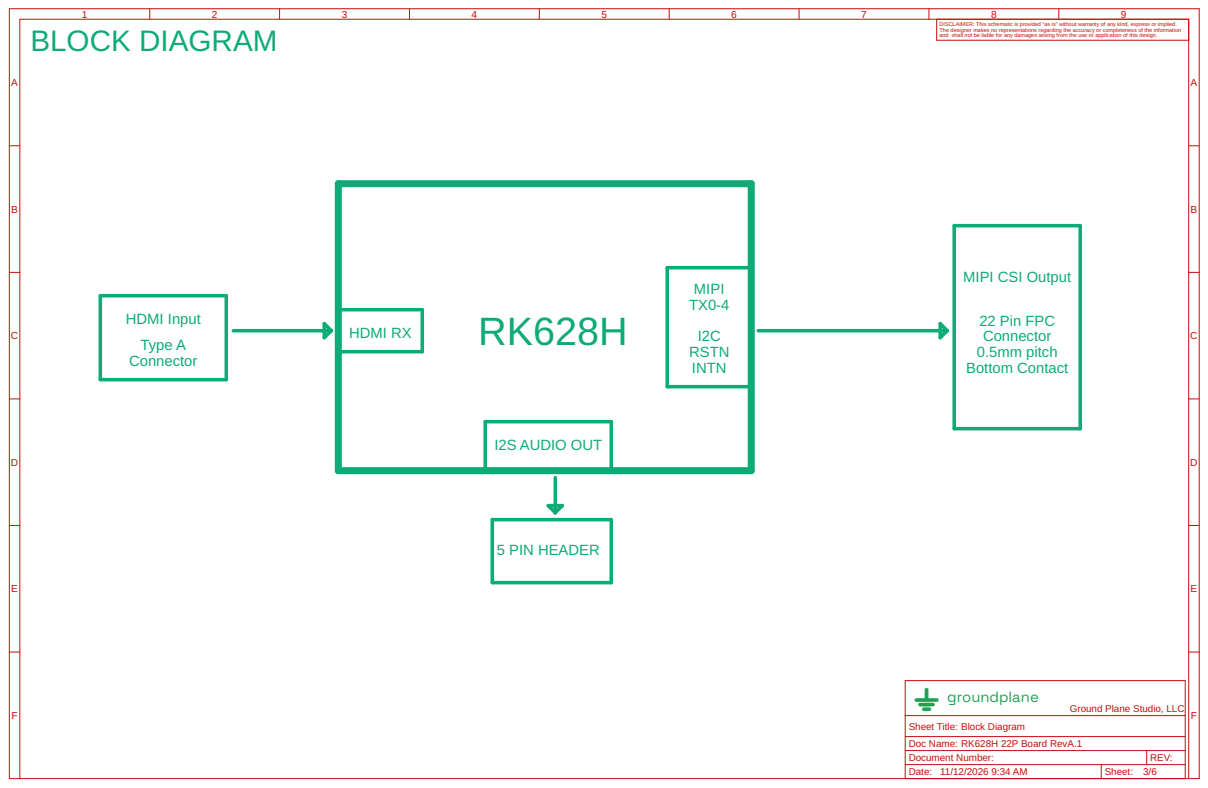
[picture p43: page 3]

and shall not be liable for any damages arising from the use or application of this design. A

Ground Plane Studio, LLC

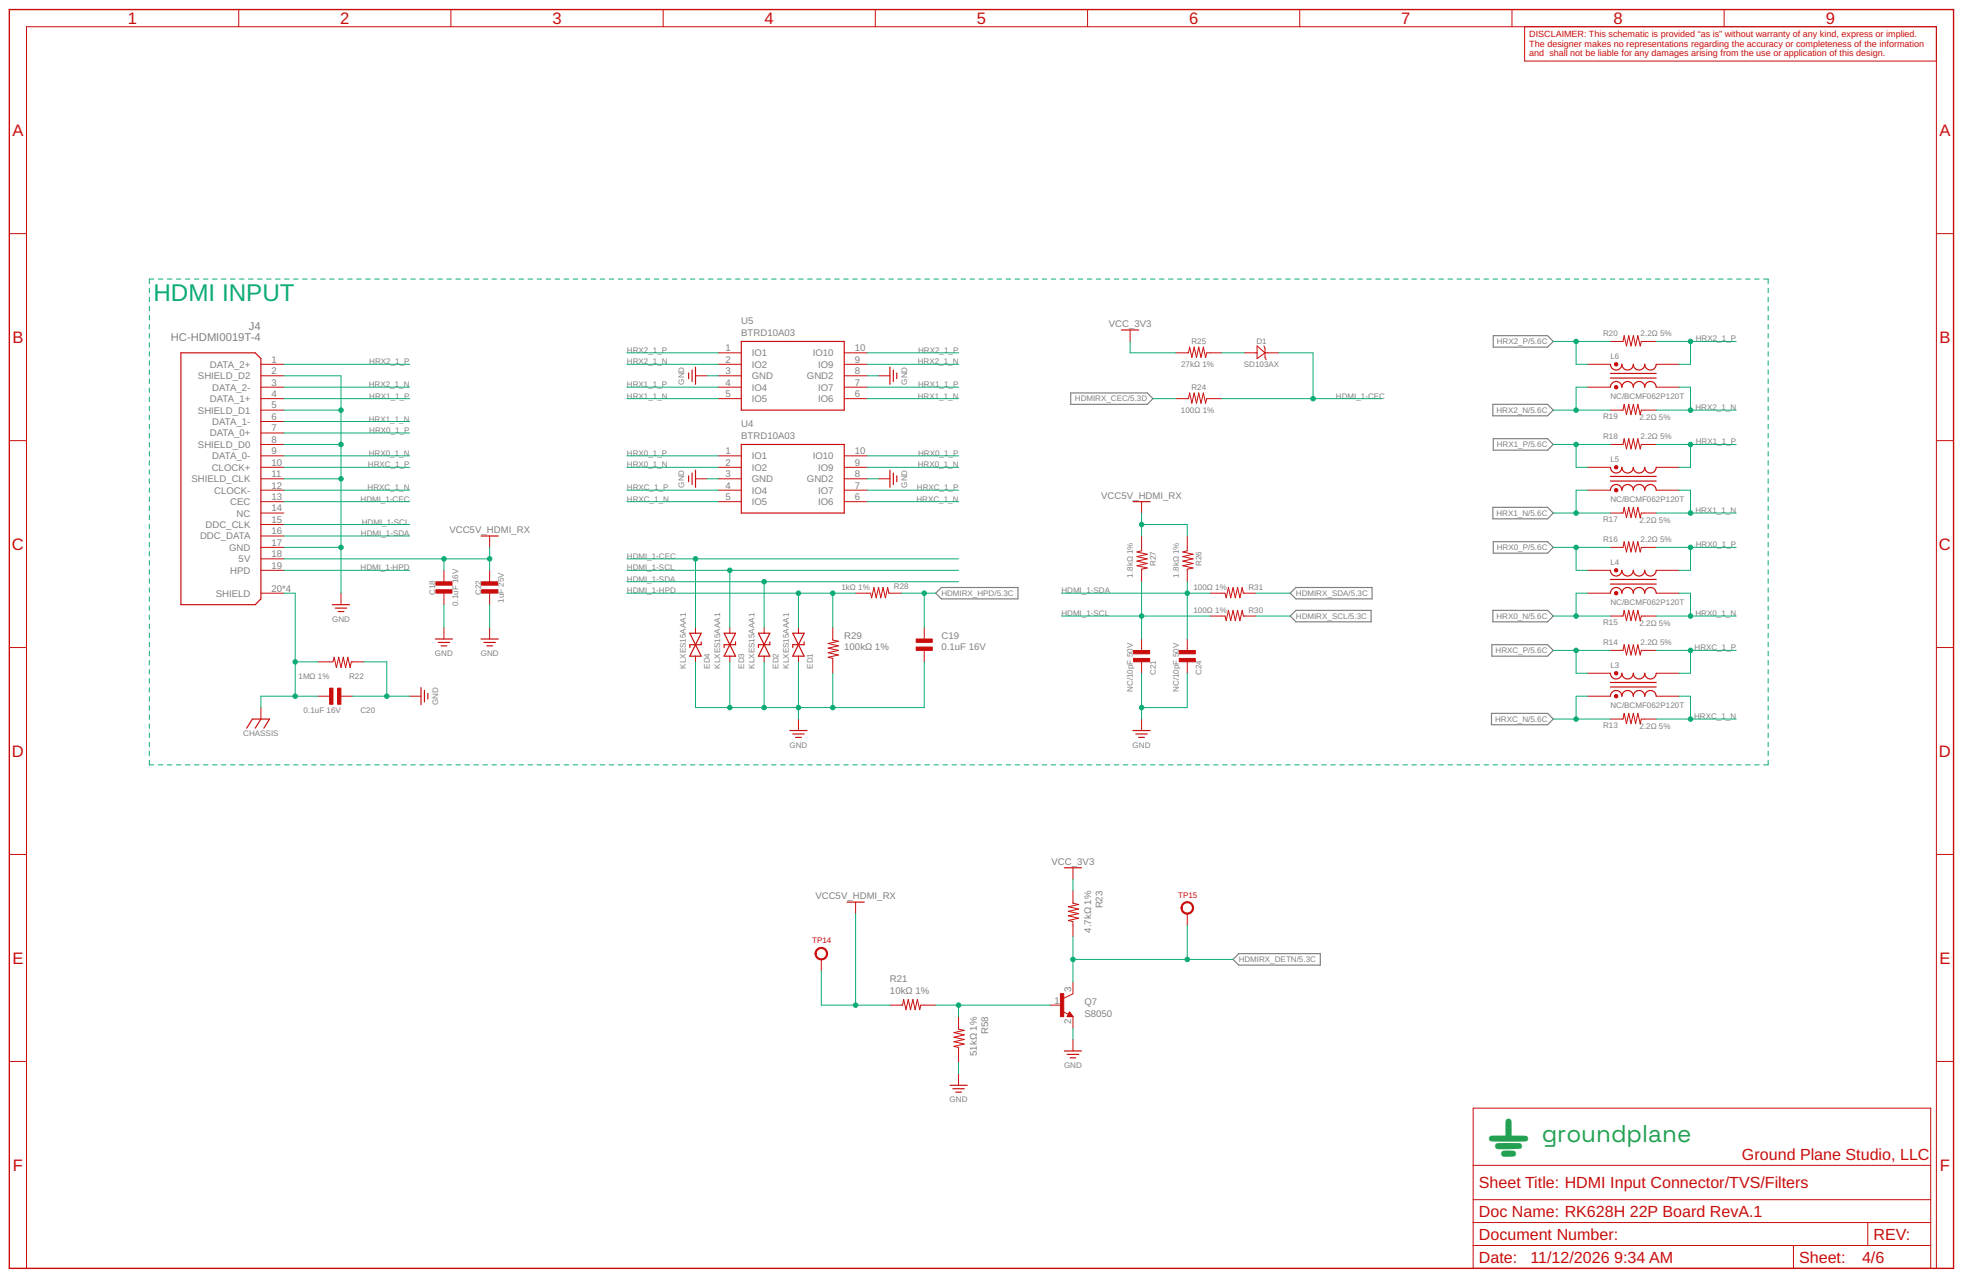
[picture p44: page 4]
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

Ground Plane Studio, LLC

HDMI Input Connector/TVS/Filters

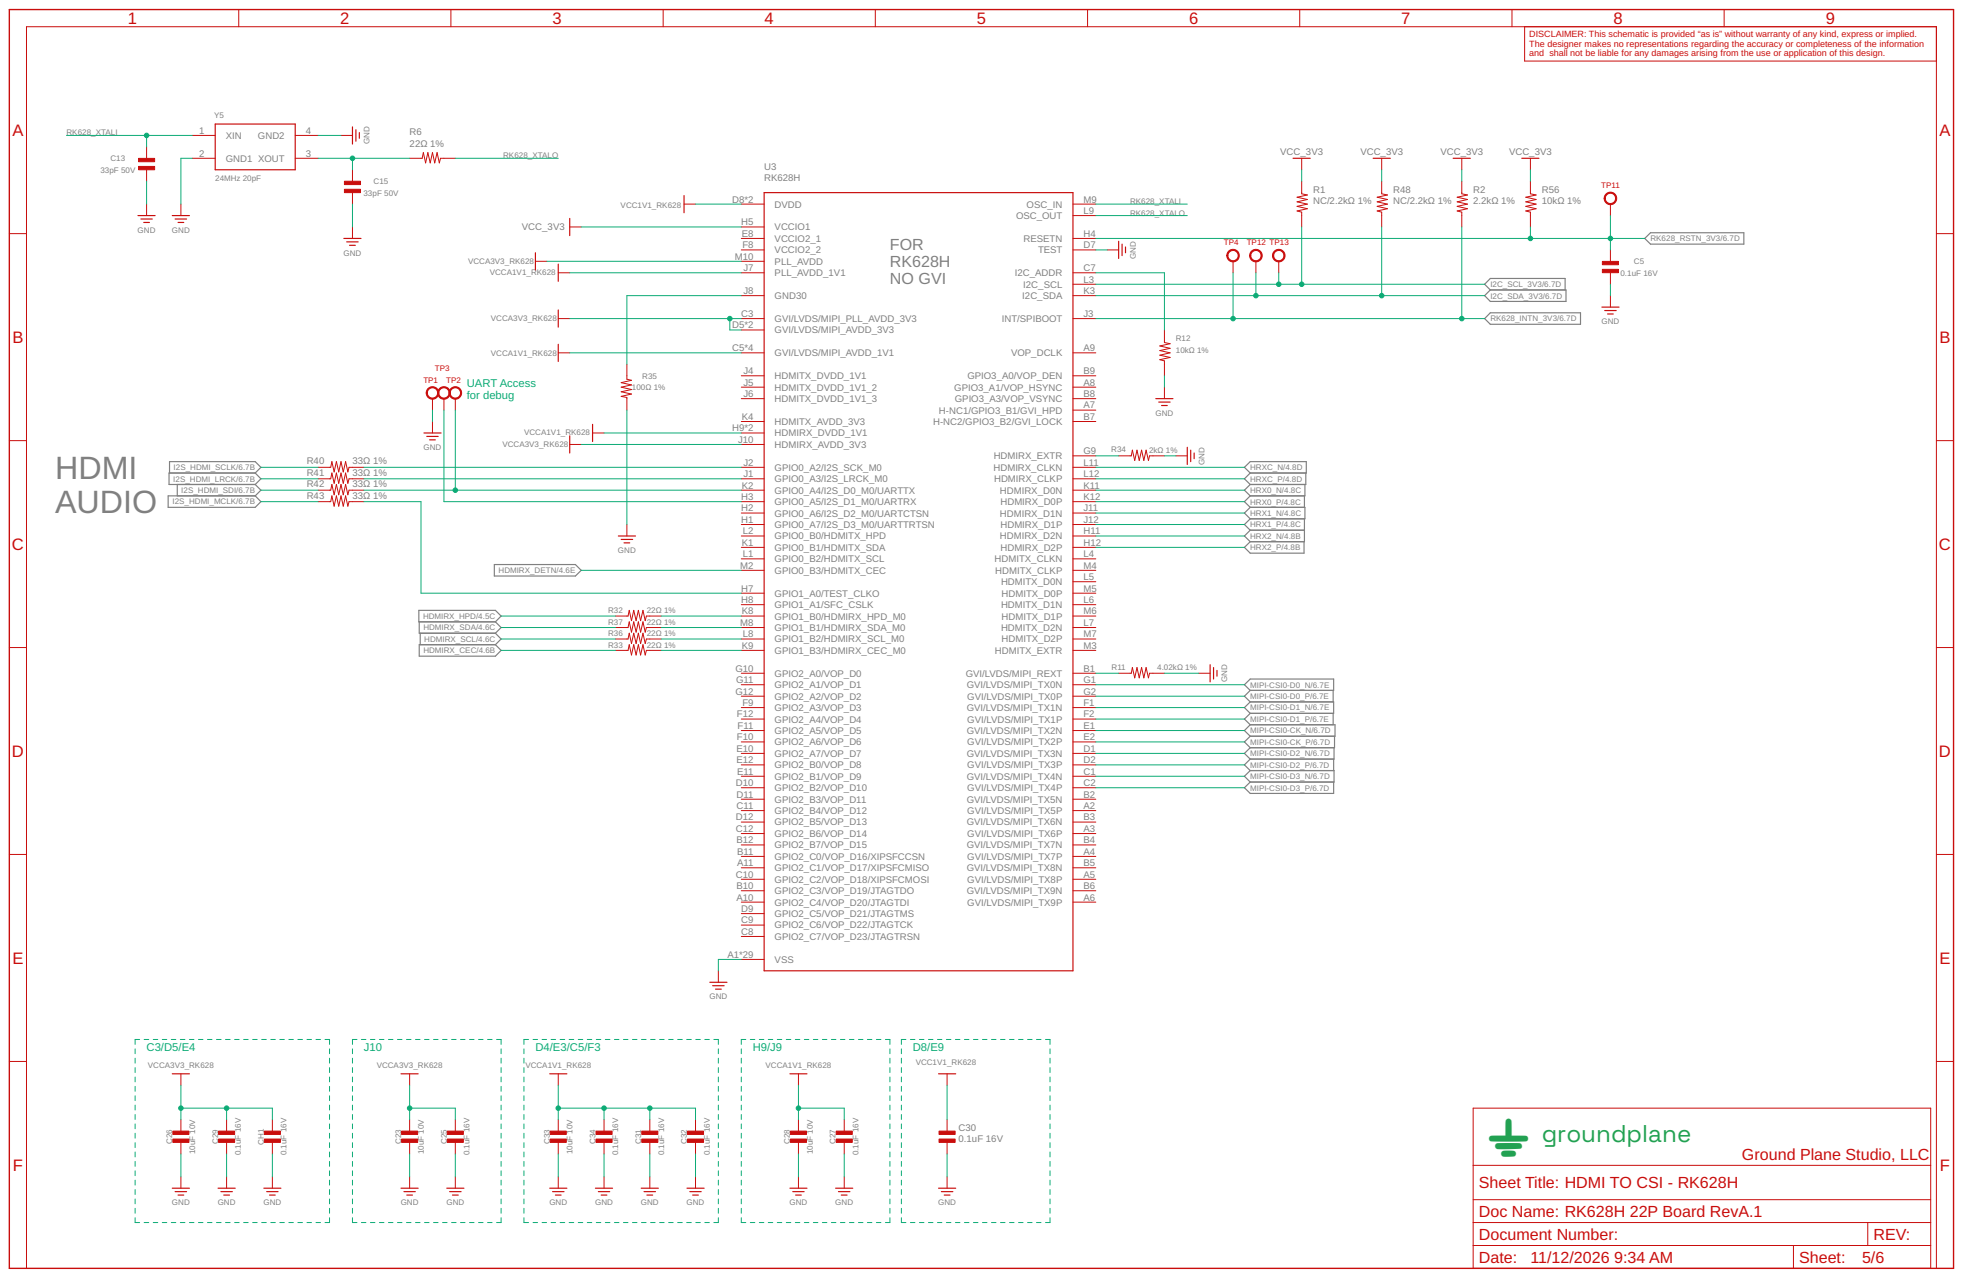
[picture p45: page 5]
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

GND GND

MIPI-CSI0-D3_N/6.7D MIPI-CSI0-D3_P/6.7D MIPI-CSI0-D2_N/6.7D MIPI-CSI0-D2_P/6.7D MIPI-CSI0-CK_N/6.7D MIPI-CSI0-CK_P/6.7D MIPI-CSI0-D1_N/6.7E MIPI-CSI0-D1_P/6.7E

Ground Plane Studio, LLC

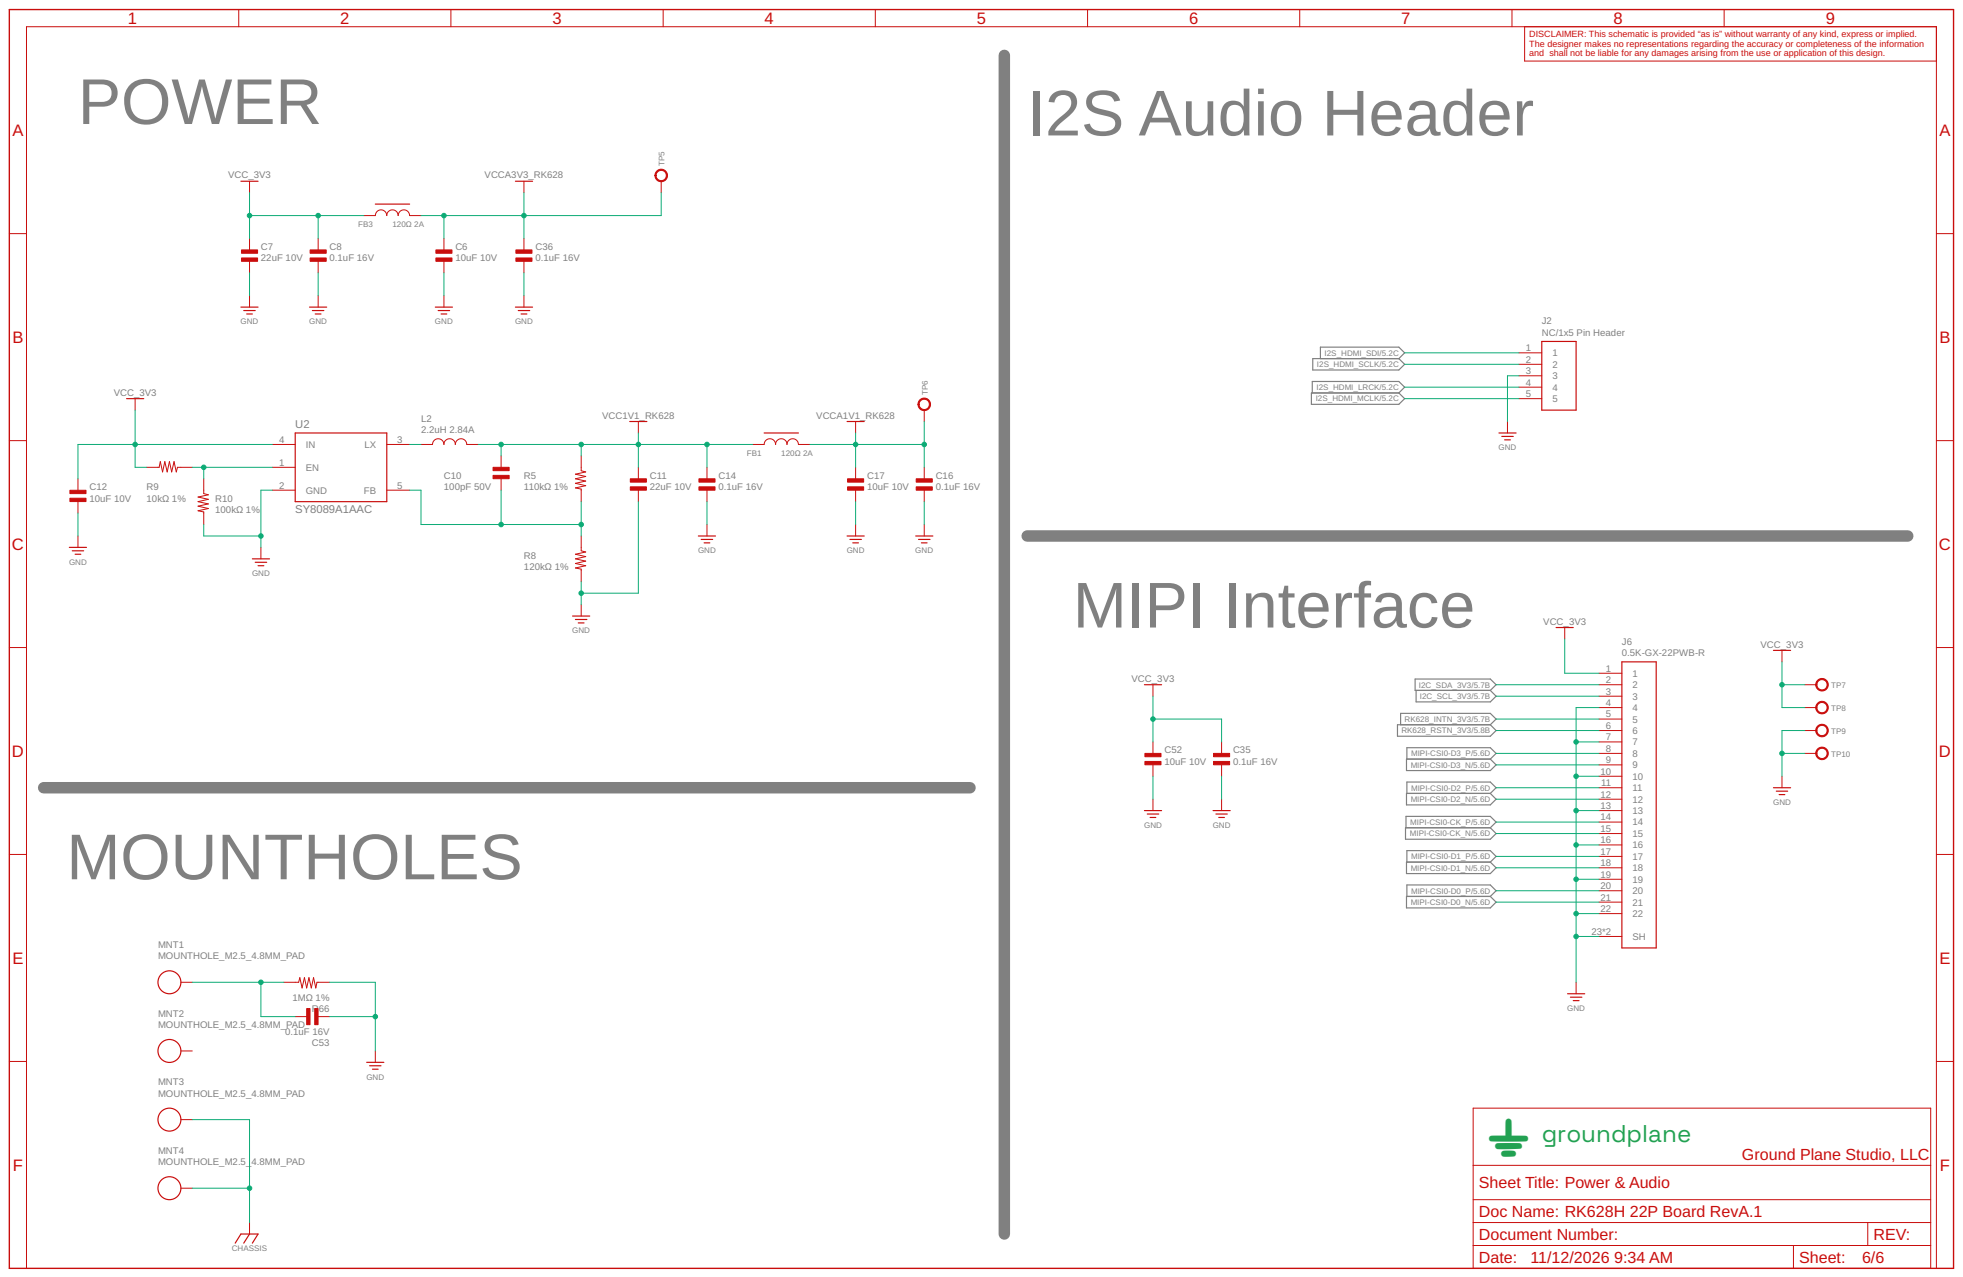
[picture p46: page 6]
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

MIPI-CSI0-D3_N/5.6D MIPI-CSI0-D3_P/5.6D MIPI-CSI0-D2_N/5.6D MIPI-CSI0-D2_P/5.6D MIPI-CSI0-CK_N/5.6D MIPI-CSI0-CK_P/5.6D MIPI-CSI0-D1_N/5.6D MIPI-CSI0-D1_P/5.6D

Ground Plane Studio, LLC
