WarpKVM/rk628-bridge-boards/rk628-2x22p/schematic/RK628H-2x22P-RevA-schematic.pdf

# HDMI to Dual CSI RK628H Board

11/12/2026 8:33 AM

# RK628H Dual 22P Board RevA

groundplane | G

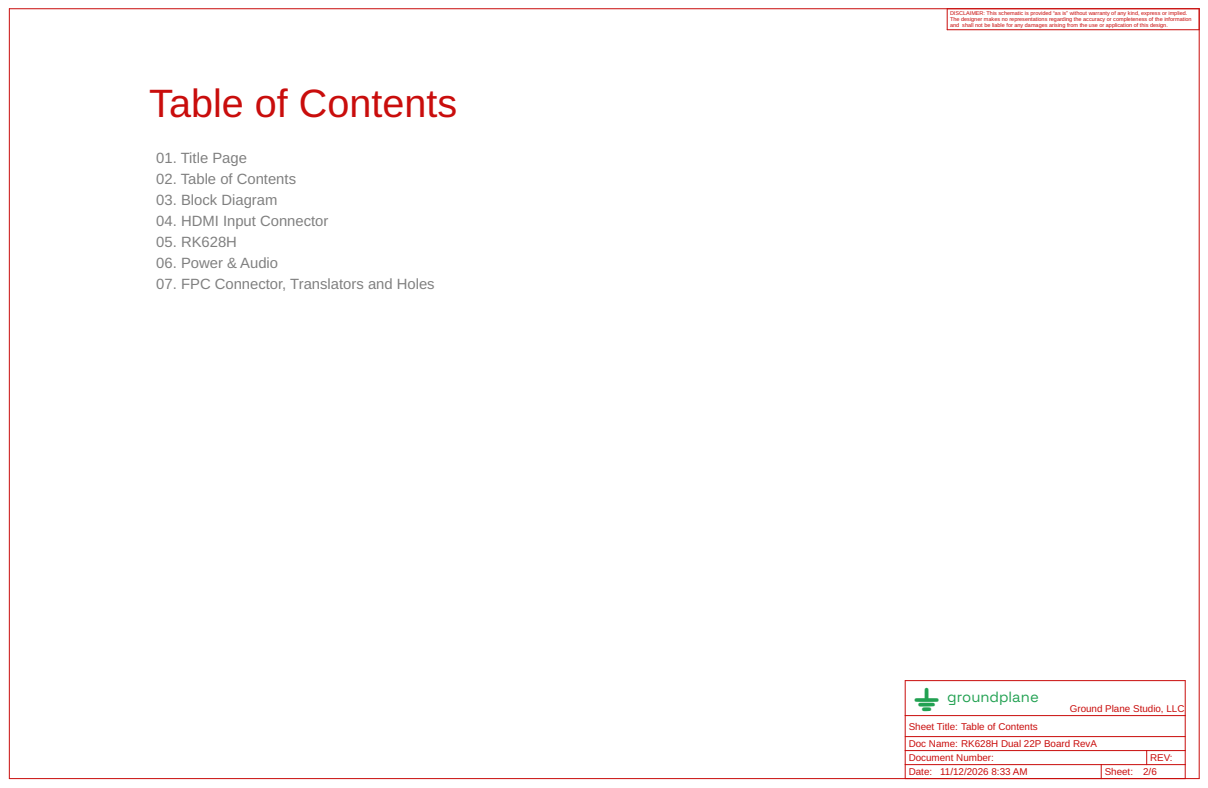
[picture p47: page 2]

DISCLAIMER: This schematic is provided “as is” without warranty of any kind, express or implied. The designer makes no representations regarding the accuracy or completeness of the information

and shall not be liable for any damages arising from the use or application of this design.

01. Title Page
02. Table of Contents
03. Block Diagram
04. HDMI Input Connector
06. Power & Audio
07. FPC Connector, Translators and Holes

Ground Plane Studio, LLC

Document Number: | REV:
Date: 11/12/2026 8:33 AM | Sheet: 2/6

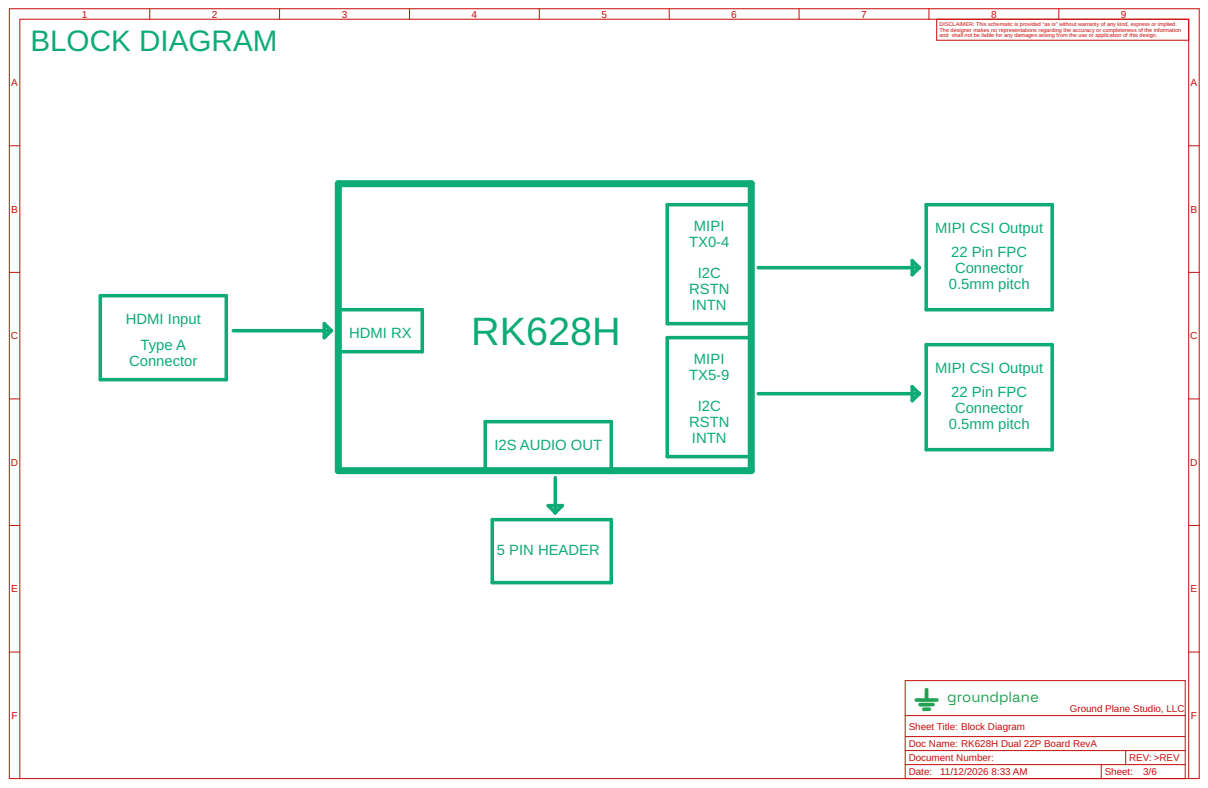
[picture p48: page 3]

and shall not be liable for any damages arising from the use or application of this design. A

Ground Plane Studio, LLC

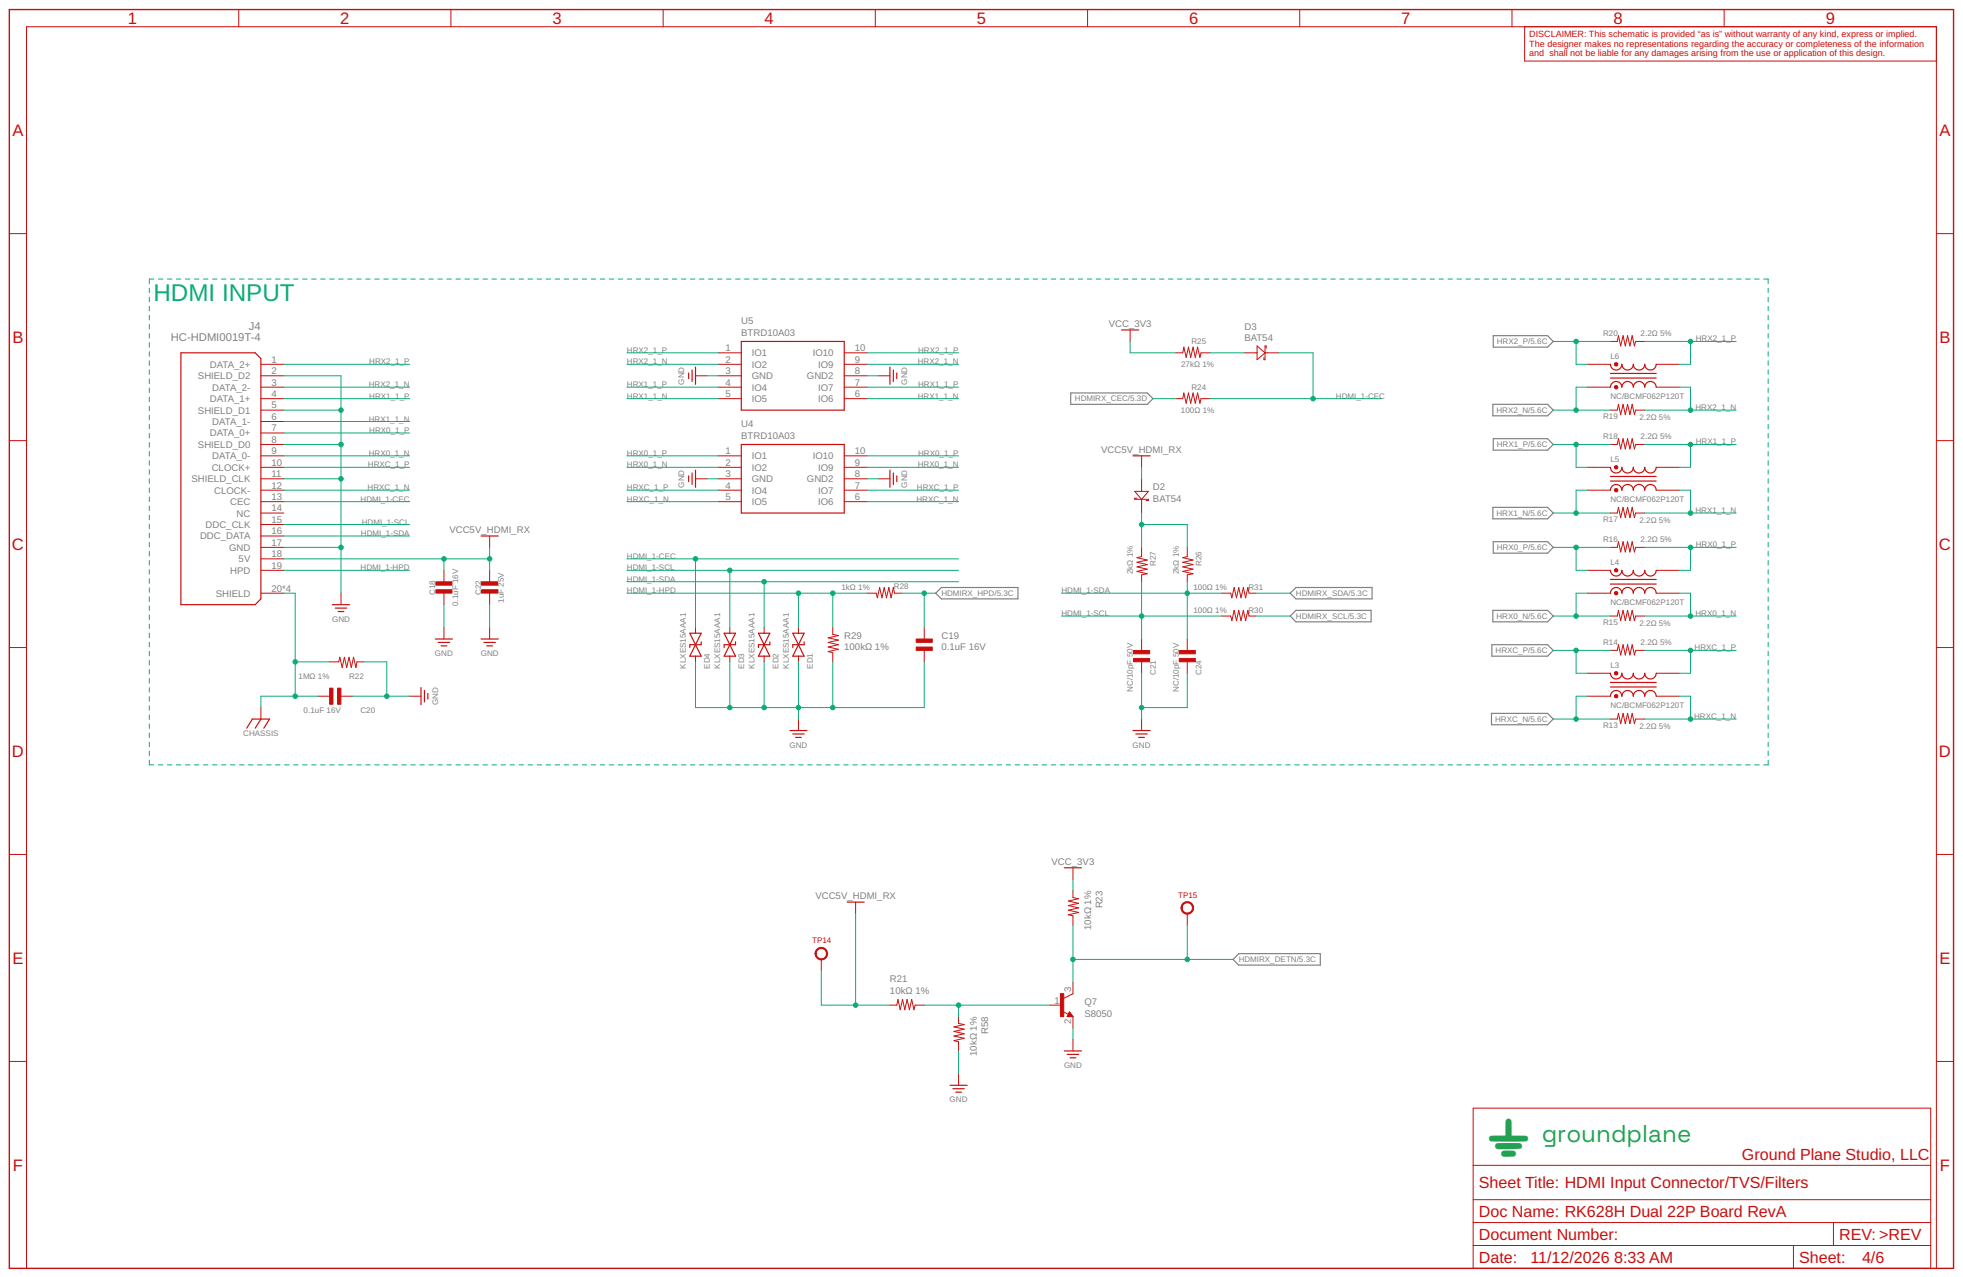
[picture p49: page 4]
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

Ground Plane Studio, LLC

HDMI Input Connector/TVS/Filters

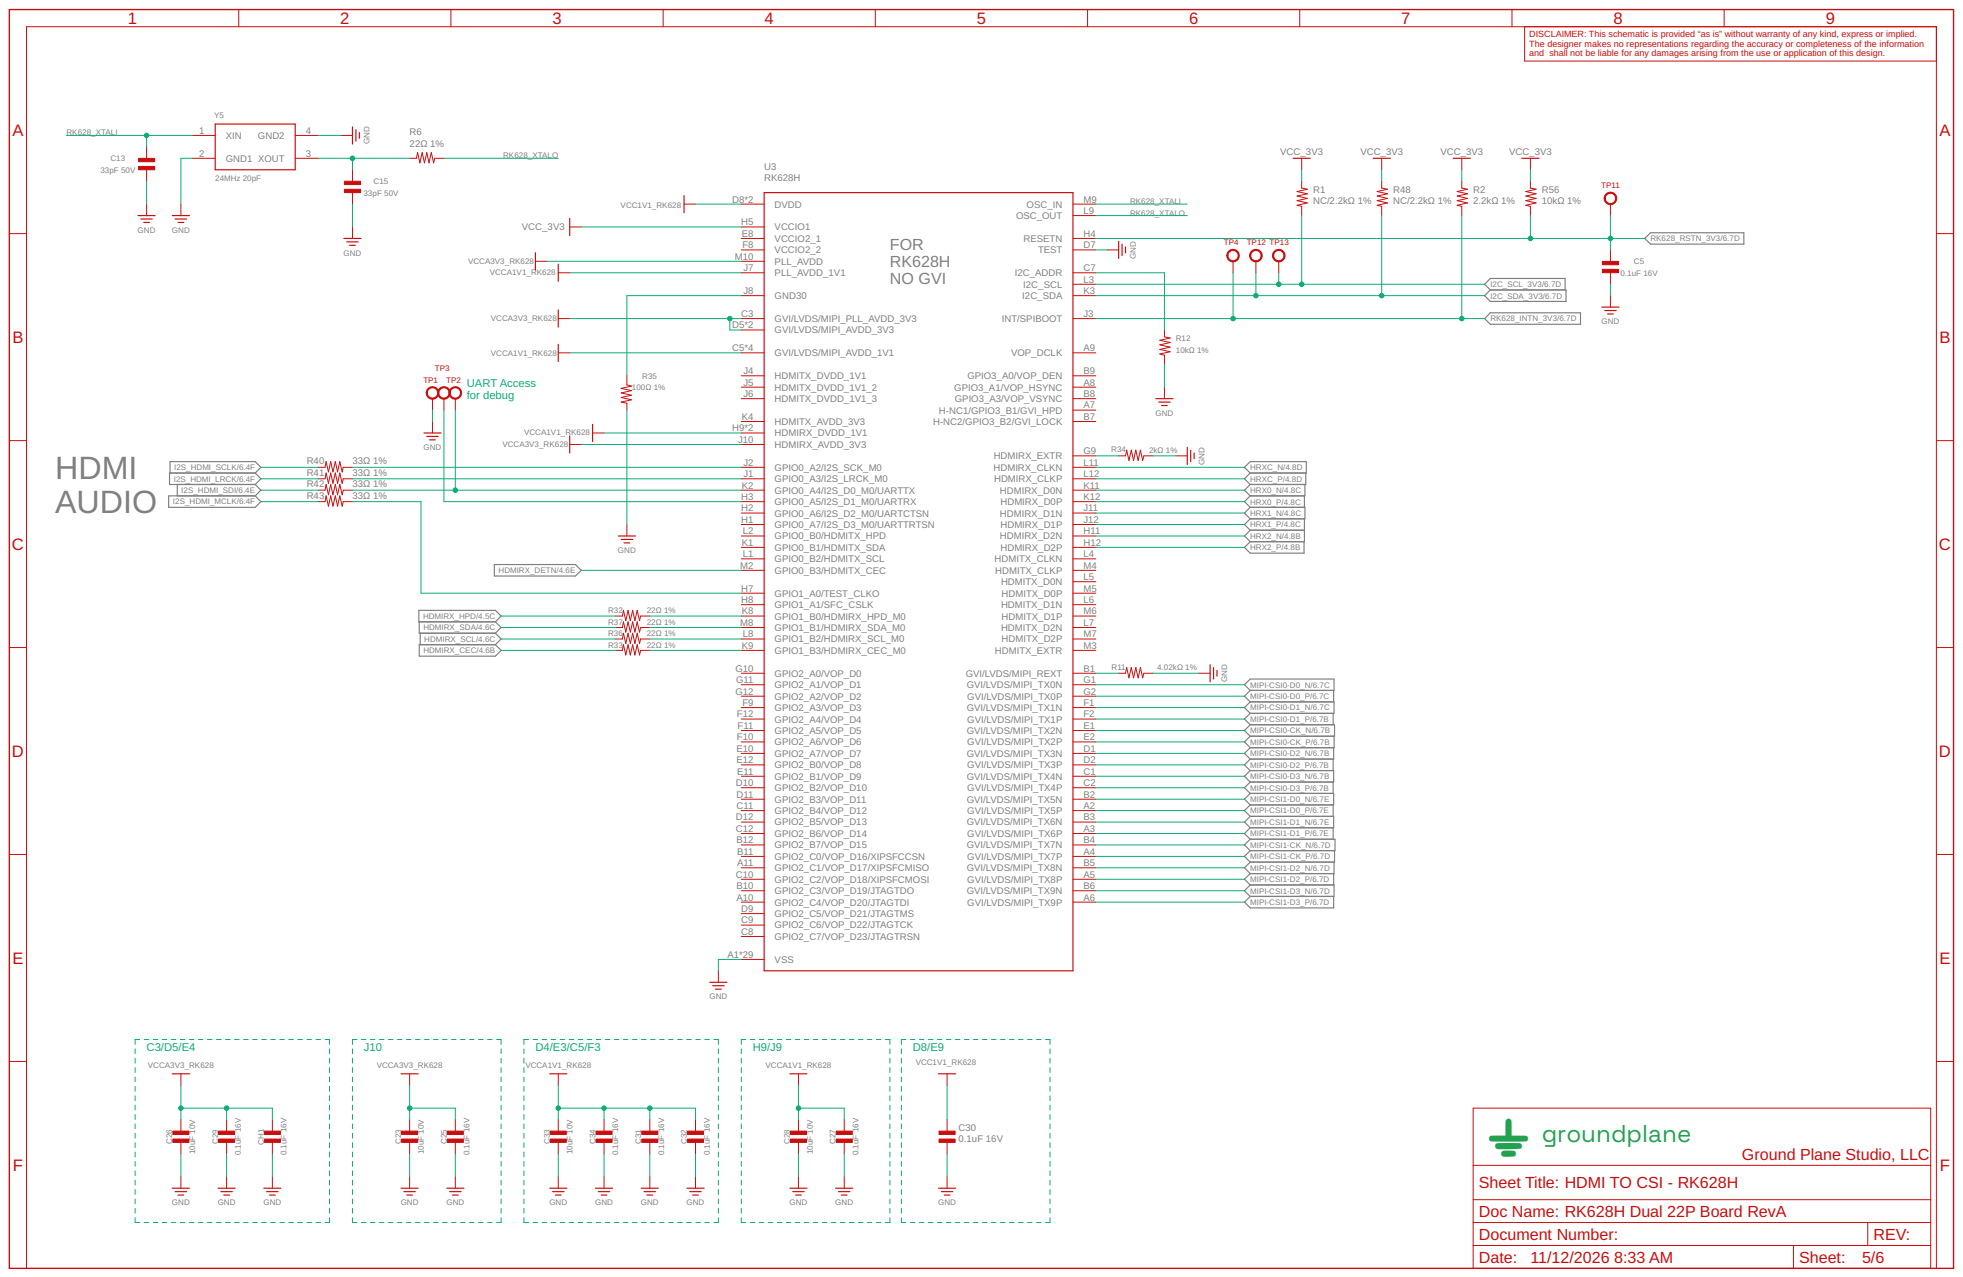
[picture p50: page 5]
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

GND GND

MIPI-CSI0-D3_N/6.7B MIPI-CSI0-D3_P/6.7B MIPI-CSI0-D2_N/6.7B MIPI-CSI0-D2_P/6.7B MIPI-CSI0-CK_N/6.7B MIPI-CSI0-CK_P/6.7B MIPI-CSI0-D1_N/6.7C MIPI-CSI0-D1_P/6.7B

MIPI-CSI1-D3_P/6.7D MIPI-CSI1-D3_N/6.7D MIPI-CSI1-D2_P/6.7D MIPI-CSI1-D2_N/6.7D MIPI-CSI1-CK_P/6.7D MIPI-CSI1-CK_N/6.7D MIPI-CSI1-D1_P/6.7E MIPI-CSI1-D1_N/6.7E MIPI-CSI1-D0_P/6.7E MIPI-CSI1-D0_N/6.7E

Ground Plane Studio, LLC

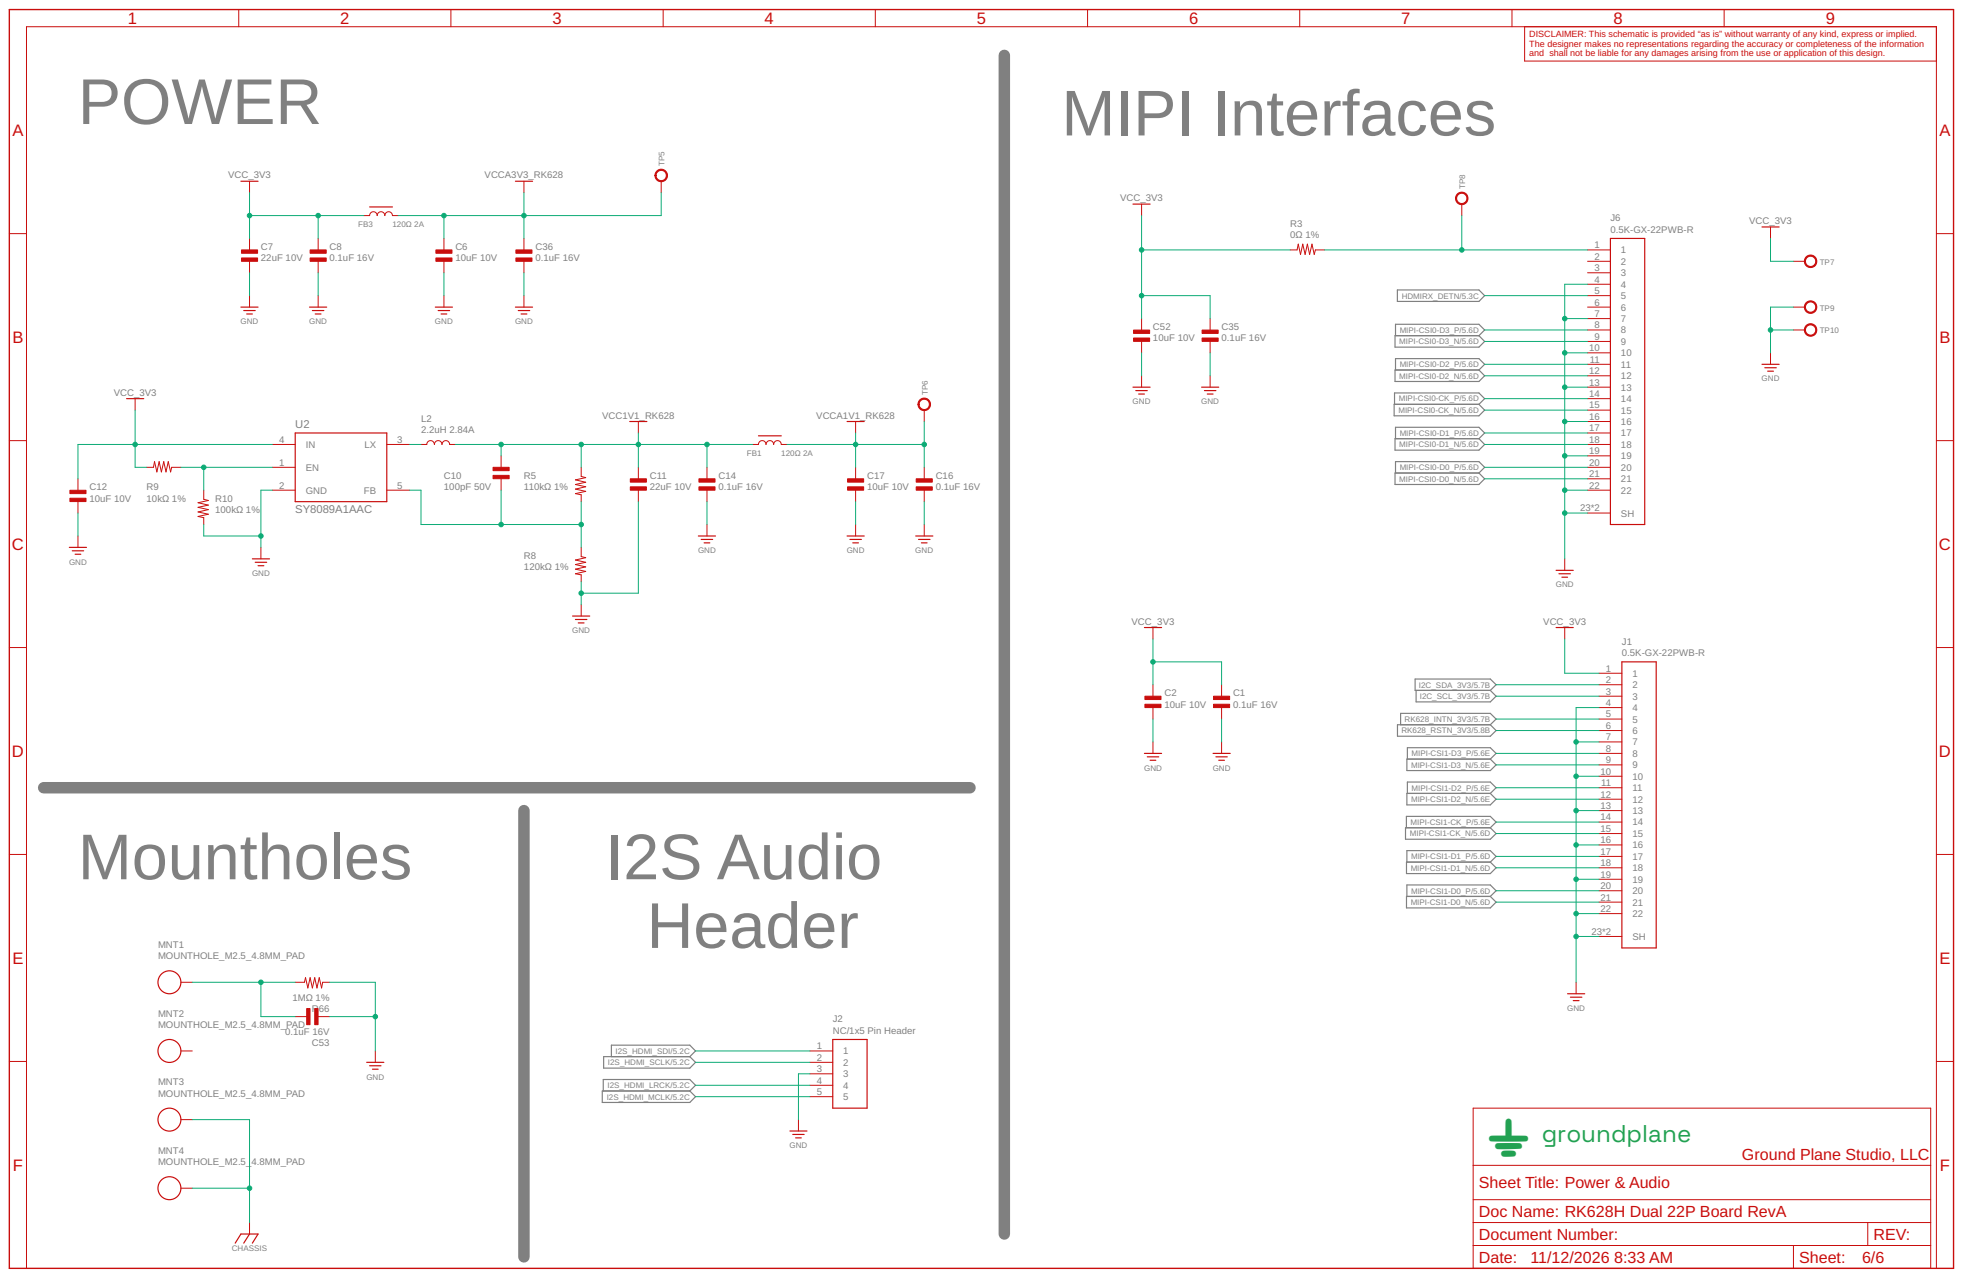
[picture p51: page 6]
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

MIPI-CSI0-D3_N/5.6D MIPI-CSI0-D3_P/5.6D MIPI-CSI0-D2_N/5.6D MIPI-CSI0-D2_P/5.6D MIPI-CSI0-CK_N/5.6D MIPI-CSI0-CK_P/5.6D MIPI-CSI0-D1_N/5.6D MIPI-CSI0-D1_P/5.6D

GND
I2C_SCL_3V3/5.7B RK628_INTN_3V3/5.7B RK628_RSTN_3V3/5.8B MIPI-CSI1-D3_P/5.6E MIPI-CSI1-D3_N/5.6E MIPI-CSI1-D2_P/5.6E MIPI-CSI1-D2_N/5.6E MIPI-CSI1-CK_P/5.6E MIPI-CSI1-CK_N/5.6D MIPI-CSI1-D1_P/5.6D MIPI-CSI1-D1_N/5.6D MIPI-CSI1-D0_P/5.6D MIPI-CSI1-D0_N/5.6D

Ground Plane Studio, LLC
