WarpKVM/rk628-bridge-boards/rk628-30p/schematic/RK628H-30P-RevA-schematic.pdf

# HDMI to CSI (RK628H) 30P Board

11/12/2026 10:55 AM

# RK628H 30P Board RevA

groundplane | G

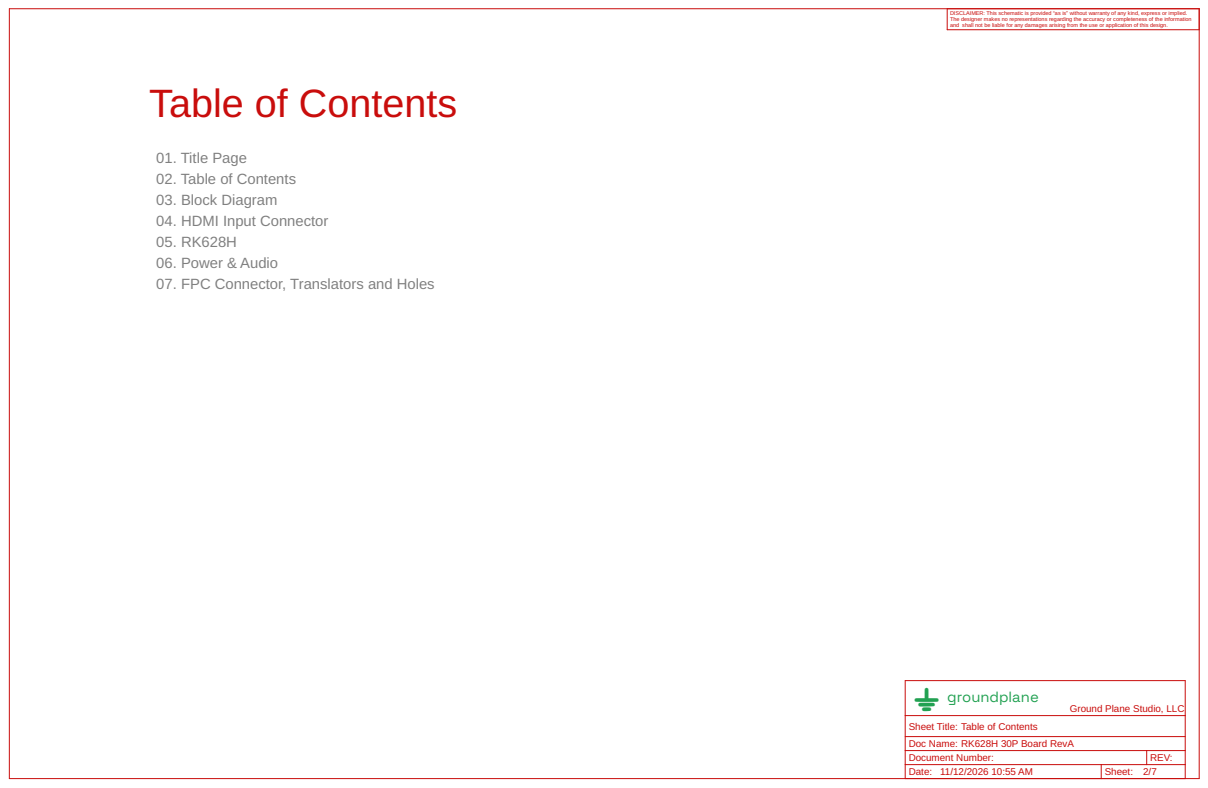
[picture p52: page 2]

DISCLAIMER: This schematic is provided “as is” without warranty of any kind, express or implied. The designer makes no representations regarding the accuracy or completeness of the information

and shall not be liable for any damages arising from the use or application of this design.

01. Title Page
02. Table of Contents
03. Block Diagram
04. HDMI Input Connector
06. Power & Audio
07. FPC Connector, Translators and Holes

Ground Plane Studio, LLC

Document Number: | REV:
Date: 11/12/2026 10:55 AM | Sheet: 2/7

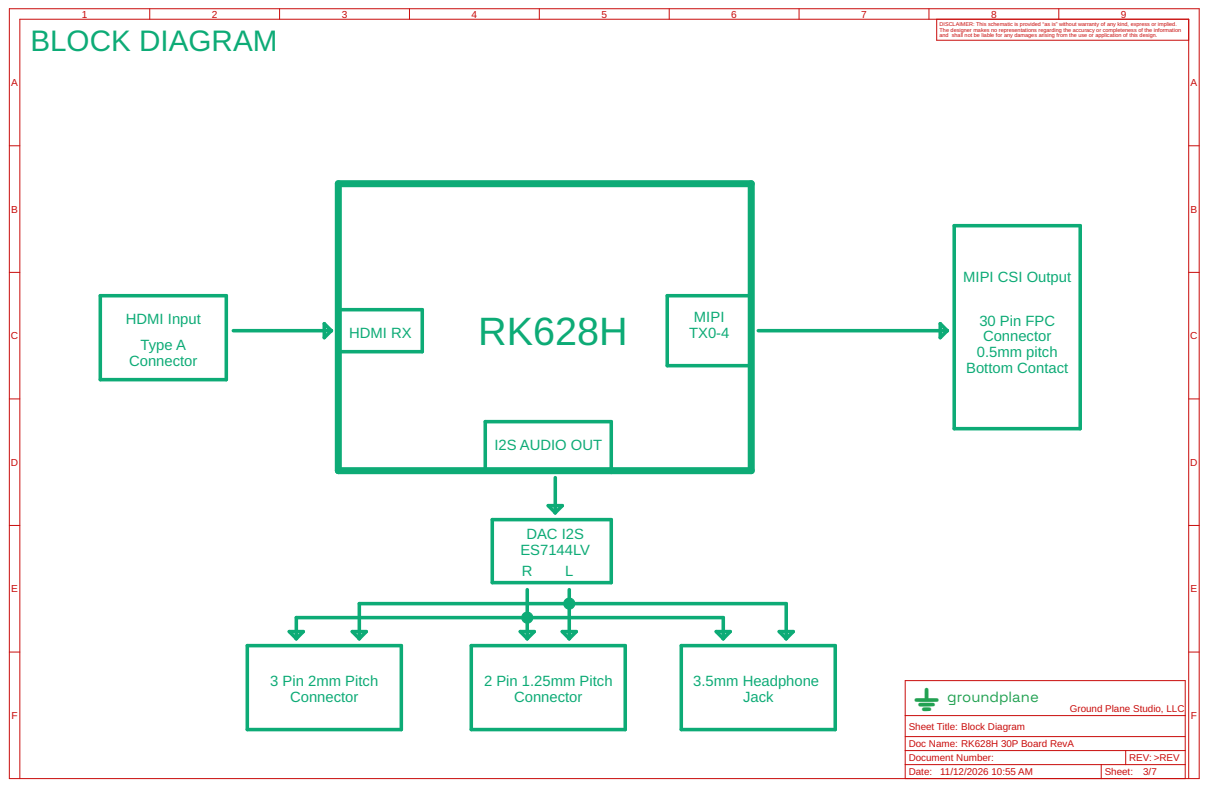
[picture p53: page 3]

and shall not be liable for any damages arising from the use or application of this design. A

Ground Plane Studio, LLC

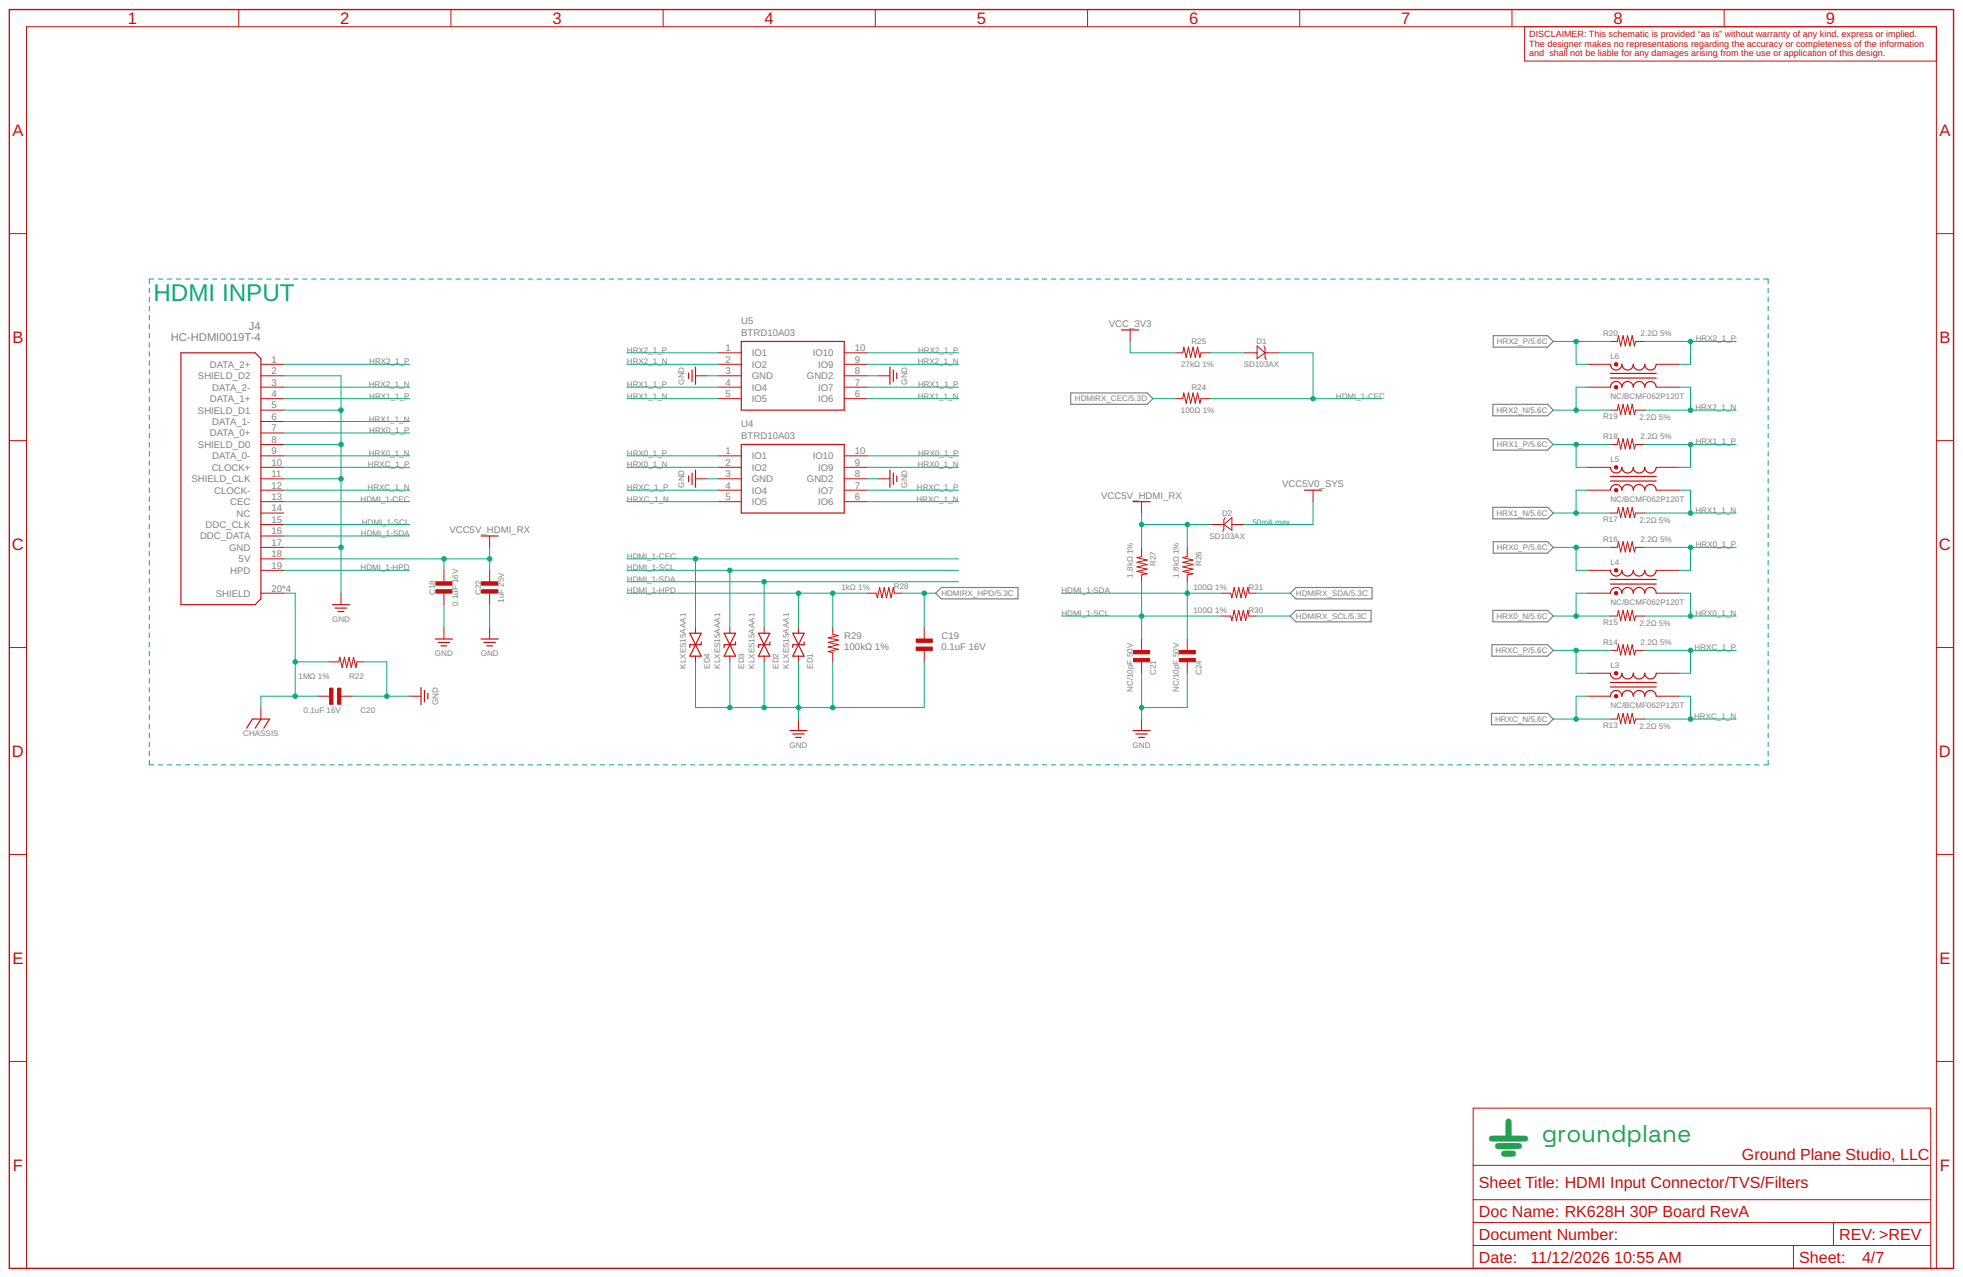
[picture p54: page 4]
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

Ground Plane Studio, LLC

HDMI Input Connector/TVS/Filters

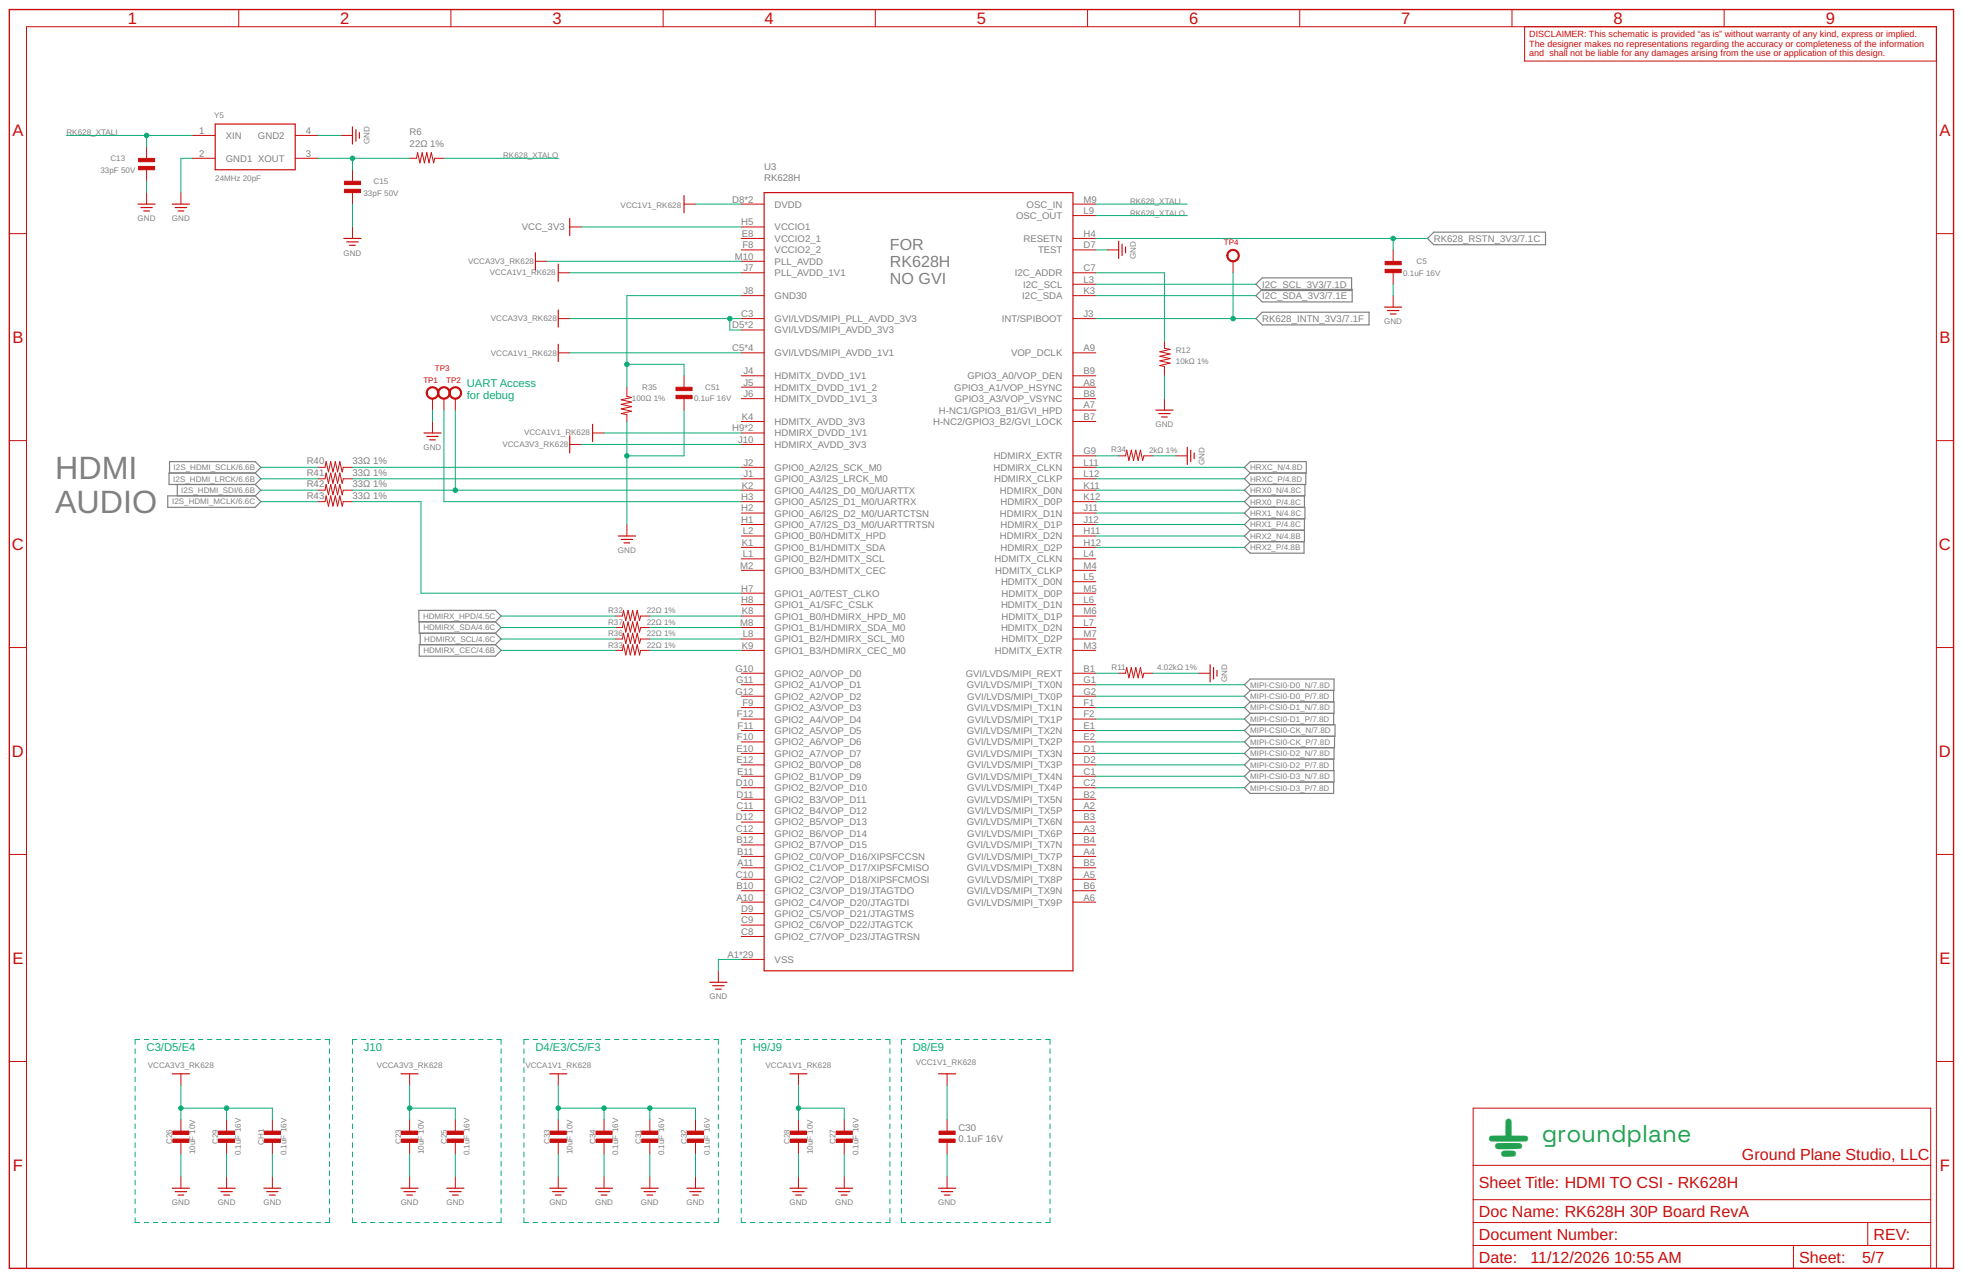
[picture p55: page 5]
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

GND GND

MIPI-CSI0-D3_N/7.8D MIPI-CSI0-D3_P/7.8D MIPI-CSI0-D2_N/7.8D MIPI-CSI0-D2_P/7.8D MIPI-CSI0-CK_N/7.8D MIPI-CSI0-CK_P/7.8D MIPI-CSI0-D1_N/7.8D MIPI-CSI0-D1_P/7.8D

Ground Plane Studio, LLC

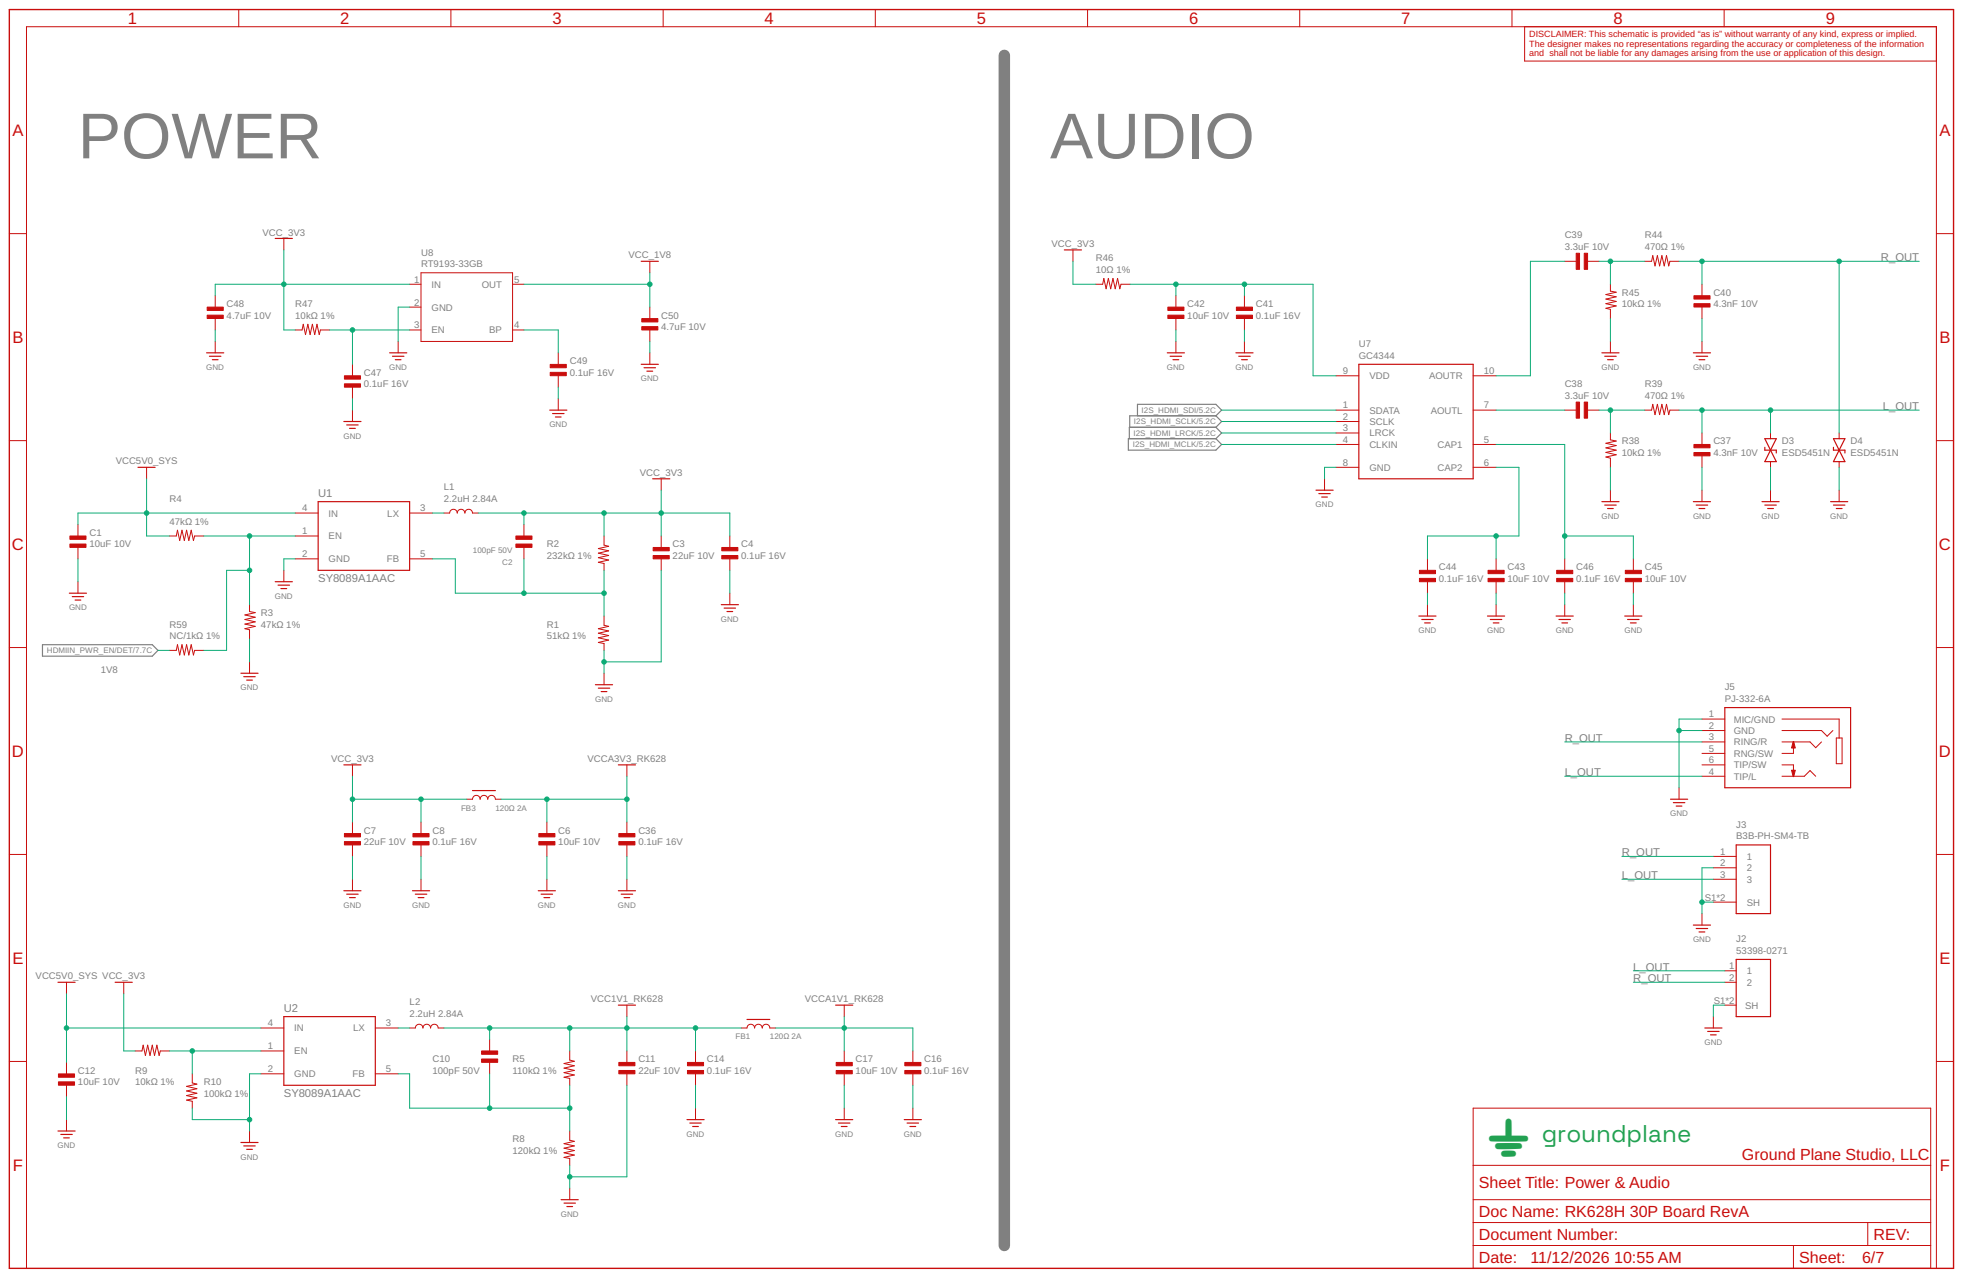
[picture p56: page 6]
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

Ground Plane Studio, LLC

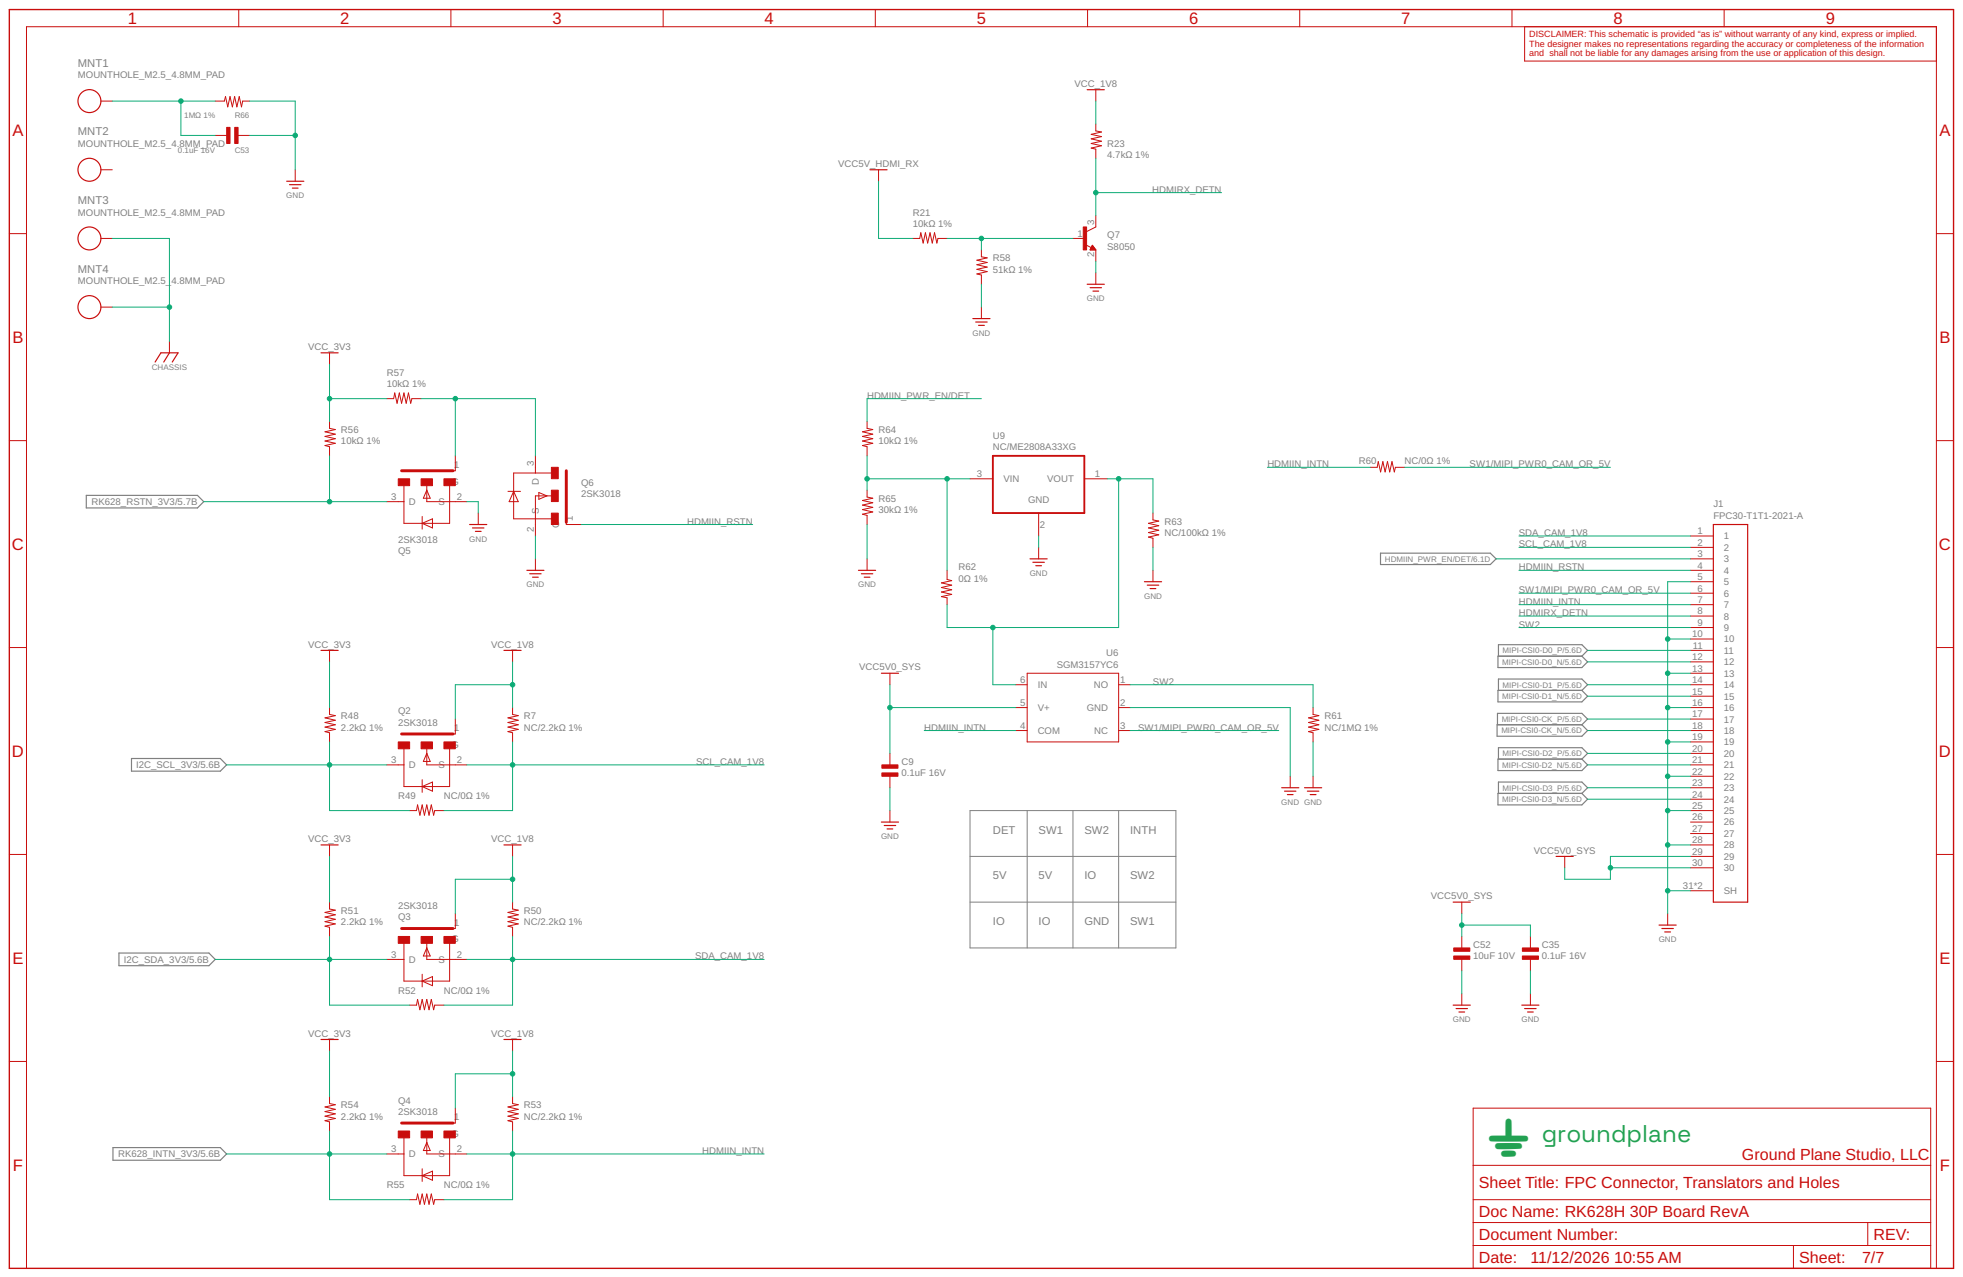
[picture p57: page 7]
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

MIPI-CSI0-D3_N/5.6D MIPI-CSI0-D3_P/5.6D MIPI-CSI0-D2_N/5.6D MIPI-CSI0-D2_P/5.6D MIPI-CSI0-CK_N/5.6D MIPI-CSI0-CK_P/5.6D MIPI-CSI0-D1_N/5.6D MIPI-CSI0-D1_P/5.6D SCL_CAM_1V8

Ground Plane Studio, LLC

FPC Connector, Translators and Holes
