WarpKVM/rk628-bridge-boards/rk628-2x22p/cad/RK628H-2x22P-RevA.brd

## EAGLE design rk628-2x22p/cad/RK628H-2x22P-RevA.brd (2026-11-12)

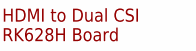
[picture p58: schematic RK628H-2x22P-RevA.sch, sheet 1, Title Page]

Notes on the sheet:
HDMI to Dual CSI RK628H Board

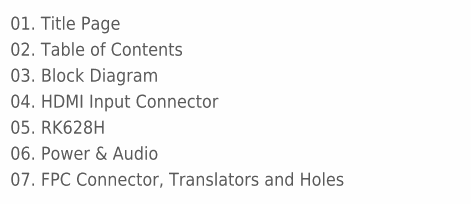
[picture p59: schematic RK628H-2x22P-RevA.sch, sheet 2, Table of Contents]

Notes on the sheet:
01. Title Page
02. Table of Contents
03. Block Diagram
04. HDMI Input Connector
06. Power & Audio
07. FPC Connector, Translators and Holes
05. RK628H

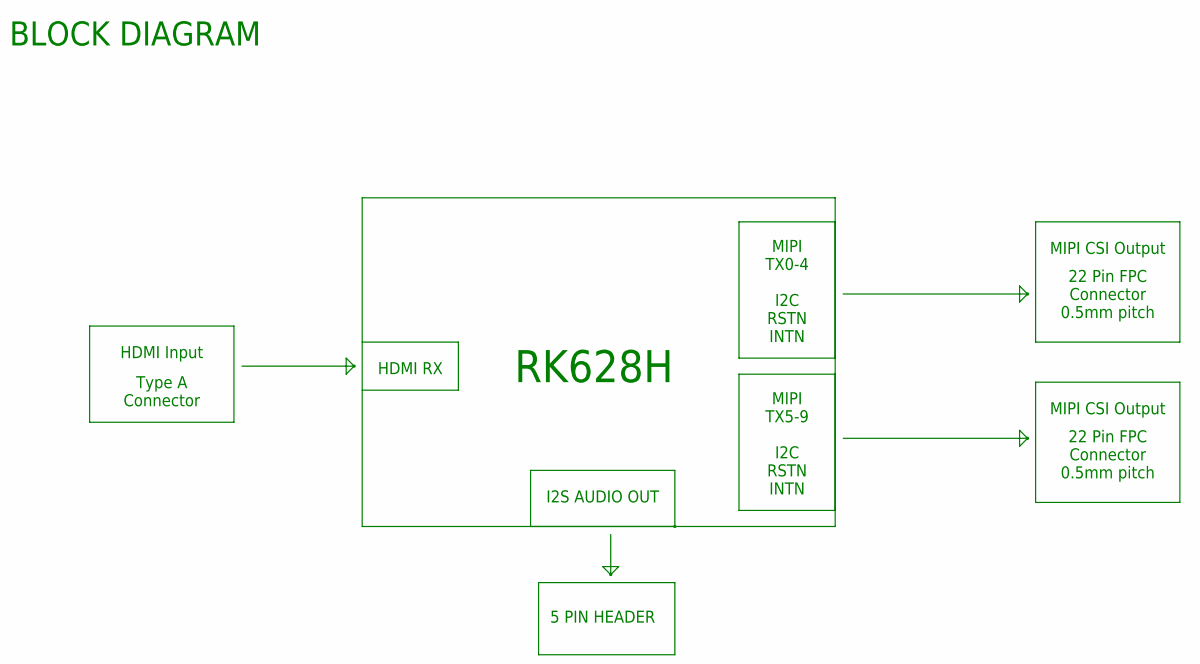
[picture p60: schematic RK628H-2x22P-RevA.sch, sheet 3, Block Diagram]

Notes on the sheet:
BLOCK DIAGRAM
HDMI Input
RK628H
Type A Connector
HDMI RX
I2S AUDIO OUT
5 PIN HEADER
MIPI CSI Output
22 Pin FPC Connector 0.5mm pitch
MIPI TX0-4
I2C RSTN INTN
MIPI TX5-9

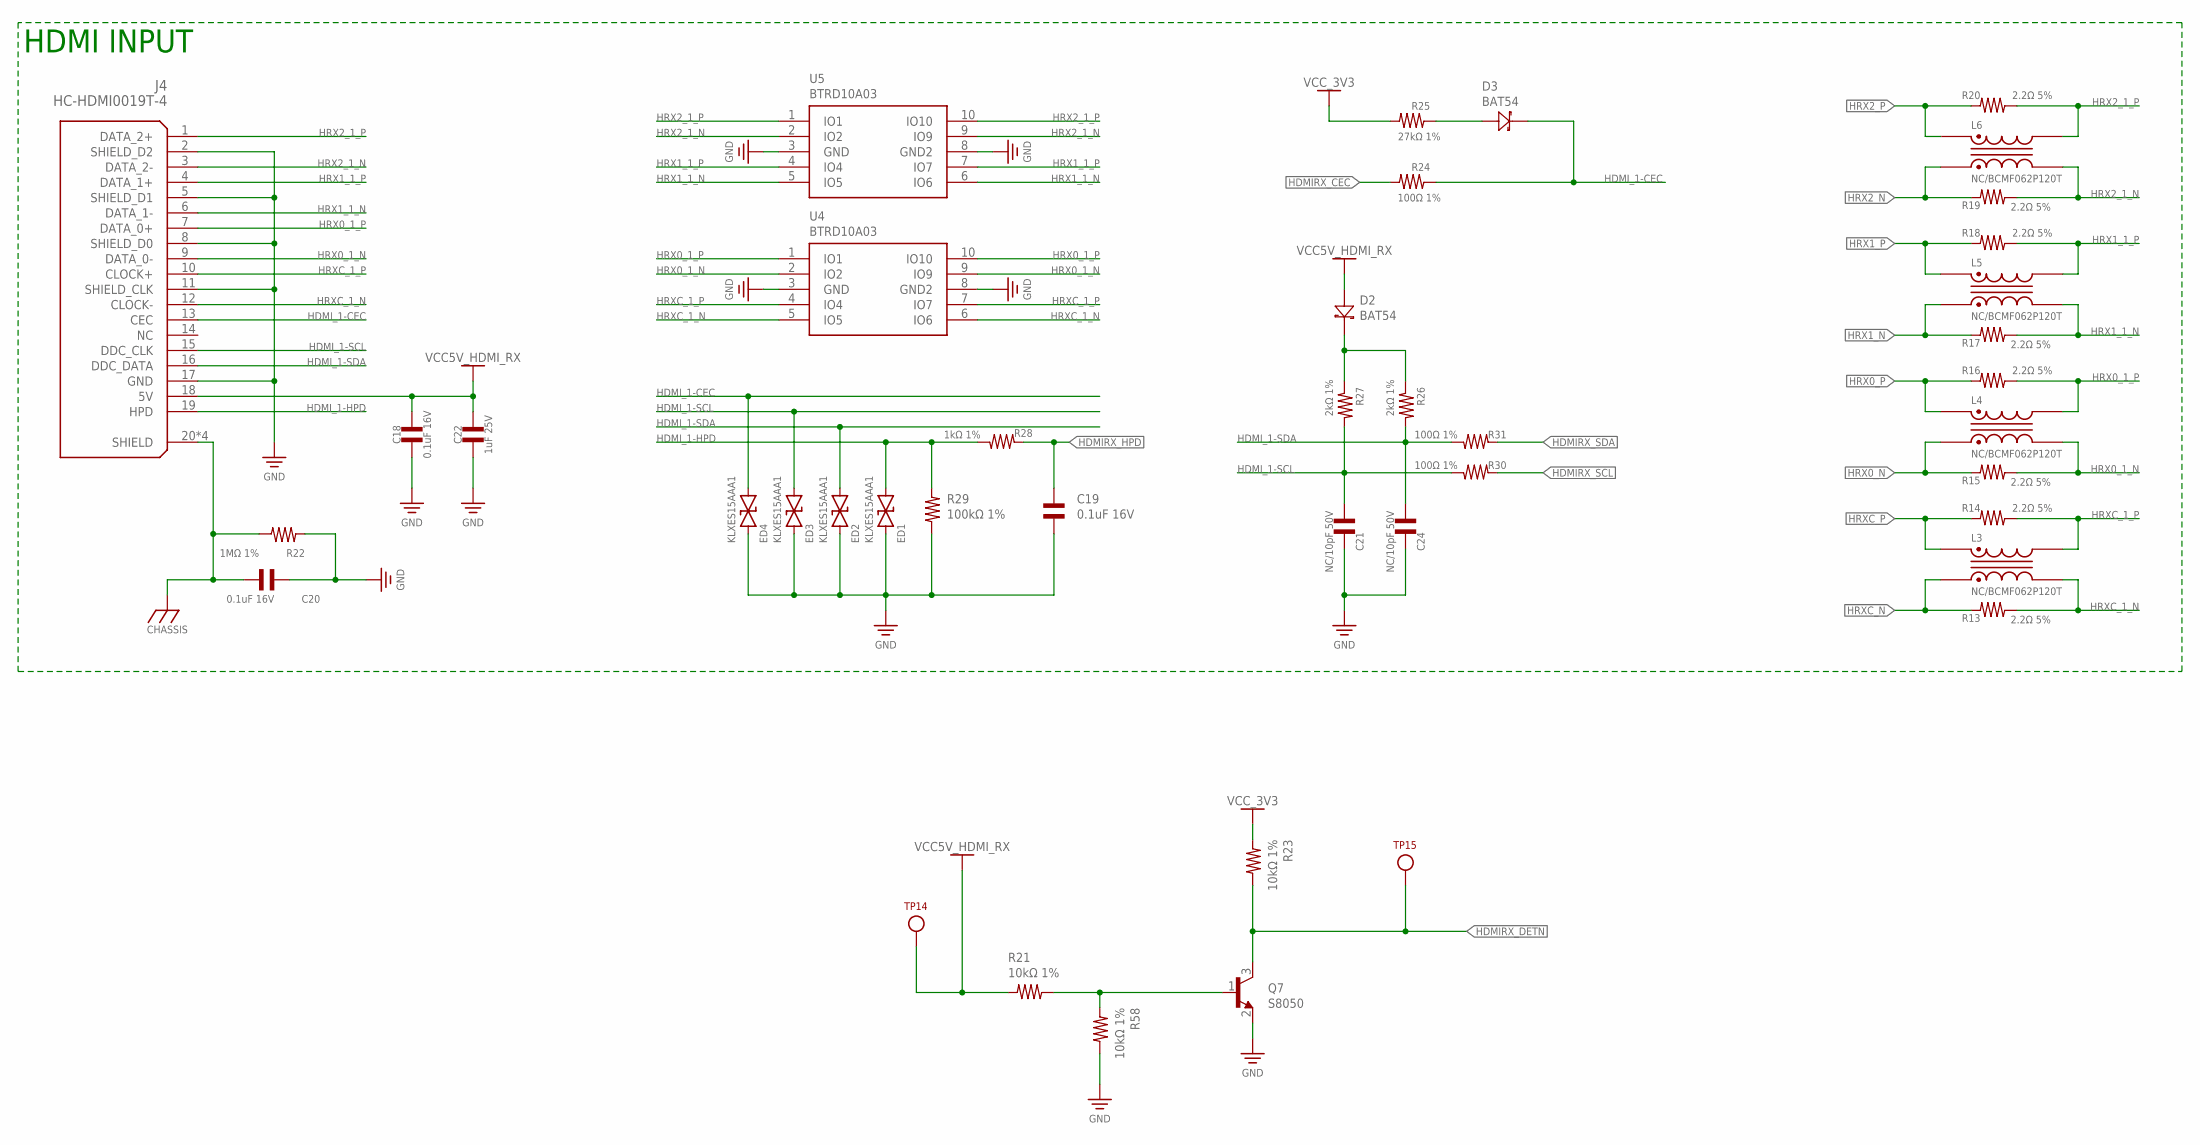
[picture p61: schematic RK628H-2x22P-RevA.sch, sheet 4, HDMI Input Connector/TVS/Filters]

Parts:
C18, C19, C20: 0.1uF 16V; CAP_0402
C21, C24: NC/10pF 50V; CAP_0201
C22: 1uF 25V; CAP_0402
D2, D3: BAT54; SOT-23-3
ED1, ED2, ED3, ED4: KLXES15AAA1; TVS_0402
J4: HC-HDMI0019T-4; CONN_HDMI_A_SMT_RA_HC-HDMI0019T-4
L3, L4, L5, L6: NC/BCMF062P120T; BCMF062P120T
Q7: S8050; SOT-23-3
R13, R14, R15, R16, R17, R18, R19, R20: 2.2Ω 5%; RES_0201
R21, R23, R58: 10kΩ 1%; RES_0402
R22: 1MΩ 1%; RES_0402
R24, R30, R31: 100Ω 1%; RES_0402
R25: 27kΩ 1%; RES_0402
R26, R27: 2kΩ 1%; RES_0402
R28: 1kΩ 1%; RES_0402
R29: 100kΩ 1%; RES_0402
TP14, TP15: TEST_POINT_1MM_0.5MM; TEST_POINT_1MM
U4, U5: BTRD10A03; DFN2510-10

Connections:
CGND: C20.2, J4.20 (SHIELD), J4.21 (SHIELD), J4.22 (SHIELD), J4.23 (SHIELD), R22.1; also elsewhere on the board
GND: C18.1, C19.1, C20.1, C21.1, C22.1, C24.1, ED1.1, ED2.1, ED3.1, ED4.1, J4.2 (SHIELD_D2), J4.5 (SHIELD_D1), J4.8 (SHIELD_D0), J4.11 (SHIELD_CLK), J4.17 (GND), Q7.2 (E), R22.2, R29.1, R58.1, U4.3 (GND), U4.8 (GND2), U5.3 (GND), U5.8 (GND2); also elsewhere on the board
HDMIRX_CEC: R24.2; also elsewhere on the board
HDMIRX_DETN: Q7.3 (C), R23.1, TP15.P$1; also elsewhere on the board
HDMIRX_HPD: C19.2, R28.2; also elsewhere on the board
HDMIRX_SCL: R30.2; also elsewhere on the board
HDMIRX_SDA: R31.2; also elsewhere on the board
HDMI_1-CEC: D3.3 (C), ED4.2, J4.13 (CEC), R24.1
HDMI_1-HPD: ED1.2, J4.19 (HPD), R28.1, R29.2
HDMI_1-SCL: C21.2, ED3.2, J4.15 (DDC_CLK), R27.2, R30.1
HDMI_1-SDA: C24.2, ED2.2, J4.16 (DDC_DATA), R26.2, R31.1
HRX0_1_N: J4.9 (DATA_0-), L4.3, R15.1, U4.2 (IO2), U4.9 (IO9)
HRX0_1_P: J4.7 (DATA_0+), L4.4, R16.1, U4.1 (IO1), U4.10 (IO10)
HRX0_N: L4.2, R15.2; also elsewhere on the board
HRX0_P: L4.1, R16.2; also elsewhere on the board
HRX1_1_N: J4.6 (DATA_1-), L5.3, R17.1, U5.5 (IO5), U5.6 (IO6)
HRX1_1_P: J4.4 (DATA_1+), L5.4, R18.1, U5.4 (IO4), U5.7 (IO7)
HRX1_N: L5.2, R17.2; also elsewhere on the board
HRX1_P: L5.1, R18.2; also elsewhere on the board
HRX2_1_N: J4.3 (DATA_2-), L6.3, R19.1, U5.2 (IO2), U5.9 (IO9)
HRX2_1_P: J4.1 (DATA_2+), L6.4, R20.1, U5.1 (IO1), U5.10 (IO10)
HRX2_N: L6.2, R19.2; also elsewhere on the board
HRX2_P: L6.1, R20.2; also elsewhere on the board
HRXC_1_N: J4.12 (CLOCK-), L3.3, R13.1, U4.5 (IO5), U4.6 (IO6)
HRXC_1_P: J4.10 (CLOCK+), L3.4, R14.1, U4.4 (IO4), U4.7 (IO7)
HRXC_N: L3.2, R13.2; also elsewhere on the board
HRXC_P: L3.1, R14.2; also elsewhere on the board
unnamed: D2.3 (C), R26.1, R27.1
unnamed: D3.1 (A), R25.1
unnamed: Q7.1 (B), R21.1, R58.2
VCC5V_HDMI_RX: C18.2, C22.2, D2.1 (A), J4.18 (5V), R21.2, TP14.P$1
VCC_3V3: R23.2, R25.2; also elsewhere on the board

Notes on the sheet:
HDMI INPUT

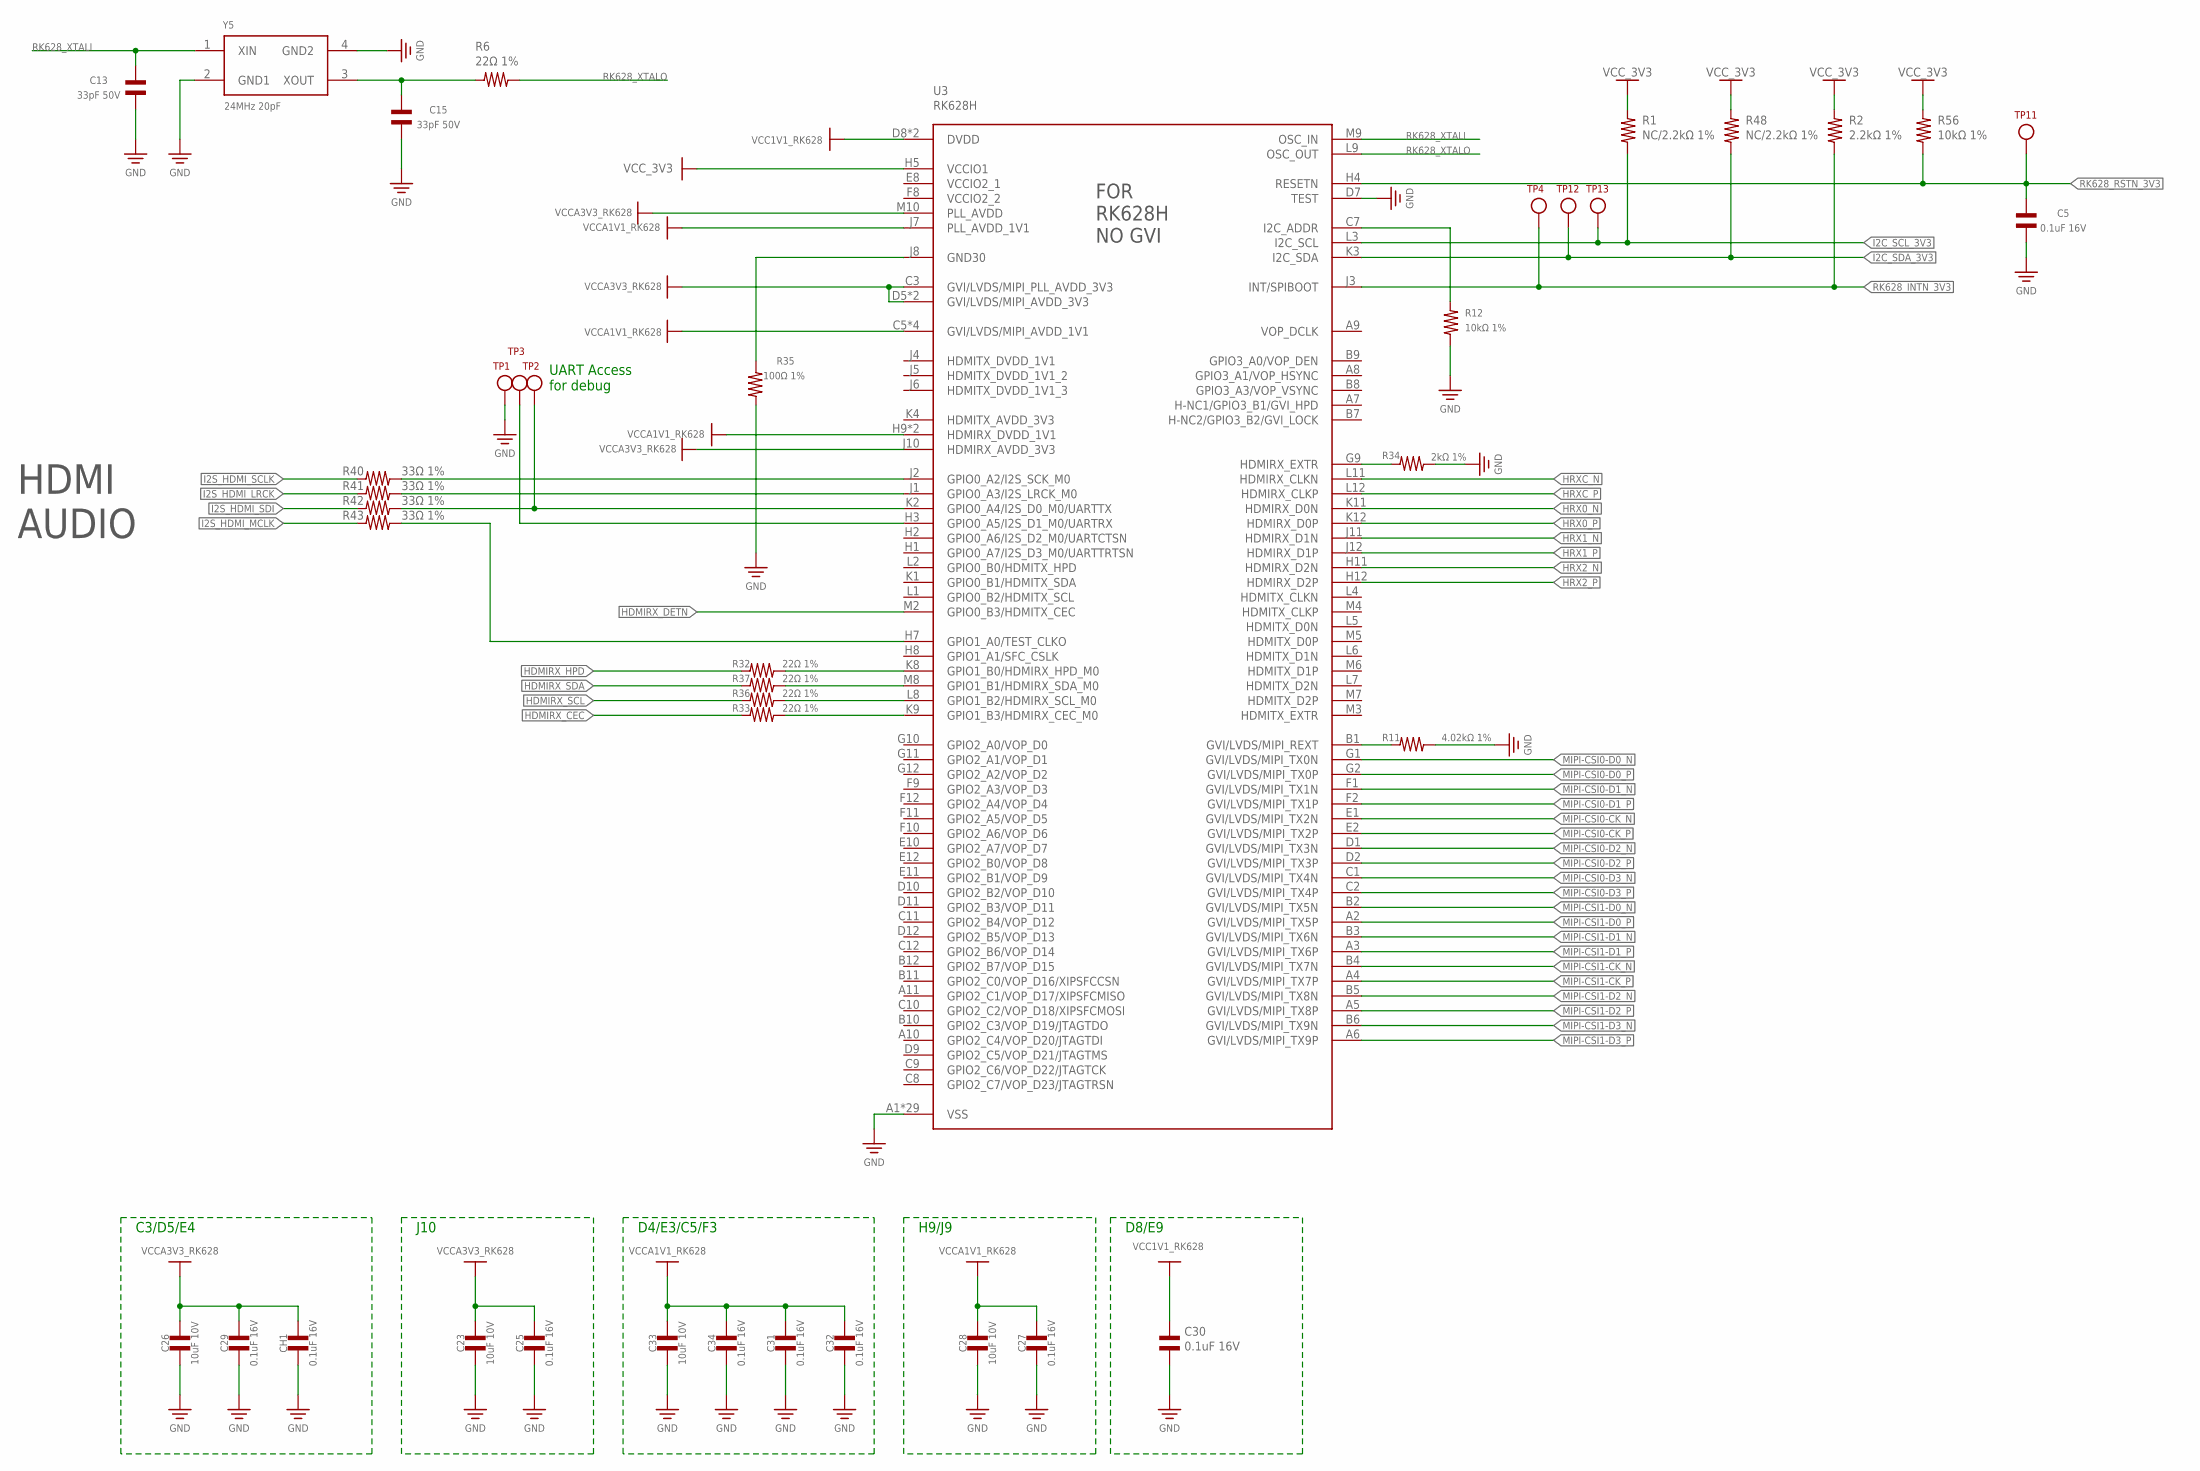
[picture p62: schematic RK628H-2x22P-RevA.sch, sheet 5, HDMI TO CSI - RK628H]

Parts:
C5, C25, C27, C29, C30, C31, C32, C34: 0.1uF 16V; CAP_0402
C13, C15: 33pF 50V; CAP_0402
C23, C26, C28, C33: 10uF 10V; CAP_0402
CH1: 0.1uF 16V; CAP_0402
R1, R48: NC/2.2kΩ 1%; RES_0402
R2: 2.2kΩ 1%; RES_0402
R6, R32, R33, R36, R37: 22Ω 1%; RES_0402
R11: 4.02kΩ 1%; RES_0402
R12, R56: 10kΩ 1%; RES_0402
R34: 2kΩ 1%; RES_0402
R35: 100Ω 1%; RES_0402
R40, R41, R42, R43: 33Ω 1%; RES_0402
TP1, TP2, TP3, TP11: TESTPOINT_1MM; TEST_POINT_1MM
TP4, TP12, TP13: TEST_POINT_1MM_0.5MM; TEST_POINT_1MM
U3: RK628H; WBBGA144_8X8MM
Y5: 24MHz 20pF; CRYSTAL_SMD2016-4P

Connections:
GND: C5.1, C13.1, C15.1, C23.1, C25.1, C26.1, C27.1, C28.1, C29.1, C30.2, C31.1, C32.1, C33.1, C34.1, CH1.1, R11.1, R12.1, R34.1, R35.2, TP1.P$1, U3.A1 (VSS), U3.A12 (VSS), U3.C4 (VSS), U3.C6 (VSS), U3.D3 (VSS), U3.D6 (VSS), U3.D7 (TEST), U3.E5 (VSS), U3.E6 (VSS), U3.E7 (VSS), U3.F4 (VSS), U3.F5 (VSS), U3.F6 (VSS), U3.F7 (VSS), U3.G3 (VSS), U3.G4 (VSS), U3.G5 (VSS), U3.G6 (VSS), U3.G7 (VSS), U3.G8 (VSS), U3.H6 (VSS), U3.H10 (VSS), U3.K5 (VSS), U3.K6 (VSS), U3.K7 (VSS), U3.K10 (VSS), U3.L10 (VSS), U3.M1 (VSS), U3.M11 (VSS), U3.M12 (VSS), Y5.2 (GND1), Y5.4 (GND2); also elsewhere on the board
HDMIRX_CEC: R33.2; also elsewhere on the board
HDMIRX_DETN: U3.M2 (GPIO0_B3/HDMITX_CEC); also elsewhere on the board
HDMIRX_HPD: R32.2; also elsewhere on the board
HDMIRX_SCL: R36.2; also elsewhere on the board
HDMIRX_SDA: R37.2; also elsewhere on the board
HDMITX_AVDD_3V3: U3.K4 (HDMITX_AVDD_3V3)
HDMITX_DVDD_1V1: U3.J4 (HDMITX_DVDD_1V1)
HDMITX_DVDD_1V1_2: U3.J5 (HDMITX_DVDD_1V1_2)
HDMITX_DVDD_1V1_3: U3.J6 (HDMITX_DVDD_1V1_3)
HRX0_N: U3.K11 (HDMIRX_D0N); also elsewhere on the board
HRX0_P: U3.K12 (HDMIRX_D0P); also elsewhere on the board
HRX1_N: U3.J11 (HDMIRX_D1N); also elsewhere on the board
HRX1_P: U3.J12 (HDMIRX_D1P); also elsewhere on the board
HRX2_N: U3.H11 (HDMIRX_D2N); also elsewhere on the board
HRX2_P: U3.H12 (HDMIRX_D2P); also elsewhere on the board
HRXC_N: U3.L11 (HDMIRX_CLKN); also elsewhere on the board
HRXC_P: U3.L12 (HDMIRX_CLKP); also elsewhere on the board
I2C_SCL_3V3: R1.1, TP13.P$1, U3.L3 (I2C_SCL); also elsewhere on the board
I2C_SDA_3V3: R48.1, TP12.P$1, U3.K3 (I2C_SDA); also elsewhere on the board
I2S_HDMI_LRCK: R41.2; also elsewhere on the board
I2S_HDMI_MCLK: R43.2; also elsewhere on the board
I2S_HDMI_SCLK: R40.2; also elsewhere on the board
I2S_HDMI_SDI: R42.2; also elsewhere on the board
MIPI-CSI0-CK_N: U3.E1 (GVI/LVDS/MIPI_TX2N); also elsewhere on the board
MIPI-CSI0-CK_P: U3.E2 (GVI/LVDS/MIPI_TX2P); also elsewhere on the board
MIPI-CSI0-D0_N: U3.G1 (GVI/LVDS/MIPI_TX0N); also elsewhere on the board
MIPI-CSI0-D0_P: U3.G2 (GVI/LVDS/MIPI_TX0P); also elsewhere on the board
MIPI-CSI0-D1_N: U3.F1 (GVI/LVDS/MIPI_TX1N); also elsewhere on the board
MIPI-CSI0-D1_P: U3.F2 (GVI/LVDS/MIPI_TX1P); also elsewhere on the board
MIPI-CSI0-D2_N: U3.D1 (GVI/LVDS/MIPI_TX3N); also elsewhere on the board
MIPI-CSI0-D2_P: U3.D2 (GVI/LVDS/MIPI_TX3P); also elsewhere on the board
MIPI-CSI0-D3_N: U3.C1 (GVI/LVDS/MIPI_TX4N); also elsewhere on the board
MIPI-CSI0-D3_P: U3.C2 (GVI/LVDS/MIPI_TX4P); also elsewhere on the board
MIPI-CSI1-CK_N: U3.B4 (GVI/LVDS/MIPI_TX7N); also elsewhere on the board
MIPI-CSI1-CK_P: U3.A4 (GVI/LVDS/MIPI_TX7P); also elsewhere on the board
MIPI-CSI1-D0_N: U3.B2 (GVI/LVDS/MIPI_TX5N); also elsewhere on the board
MIPI-CSI1-D0_P: U3.A2 (GVI/LVDS/MIPI_TX5P); also elsewhere on the board
MIPI-CSI1-D1_N: U3.B3 (GVI/LVDS/MIPI_TX6N); also elsewhere on the board
MIPI-CSI1-D1_P: U3.A3 (GVI/LVDS/MIPI_TX6P); also elsewhere on the board
MIPI-CSI1-D2_N: U3.B5 (GVI/LVDS/MIPI_TX8N); also elsewhere on the board
MIPI-CSI1-D2_P: U3.A5 (GVI/LVDS/MIPI_TX8P); also elsewhere on the board
MIPI-CSI1-D3_N: U3.B6 (GVI/LVDS/MIPI_TX9N); also elsewhere on the board
MIPI-CSI1-D3_P: U3.A6 (GVI/LVDS/MIPI_TX9P); also elsewhere on the board
unnamed: C15.2, R6.2, Y5.3 (XOUT)
unnamed: R40.1, U3.J2 (GPIO0_A2/I2S_SCK_M0)
unnamed: R41.1, U3.J1 (GPIO0_A3/I2S_LRCK_M0)
unnamed: R42.1, TP2.P$1, U3.K2 (GPIO0_A4/I2S_D0_M0/UARTTX)
unnamed: R43.1, U3.H7 (GPIO1_A0/TEST_CLKO)
unnamed: R11.2, U3.B1 (GVI/LVDS/MIPI_REXT)
unnamed: R34.2, U3.G9 (HDMIRX_EXTR)
unnamed: R32.1, U3.K8 (GPIO1_B0/HDMIRX_HPD_M0)
unnamed: R37.1, U3.M8 (GPIO1_B1/HDMIRX_SDA_M0)
unnamed: R36.1, U3.L8 (GPIO1_B2/HDMIRX_SCL_M0)
unnamed: R33.1, U3.K9 (GPIO1_B3/HDMIRX_CEC_M0)
unnamed: R35.1, U3.J8 (GND30)
unnamed: TP3.P$1, U3.H3 (GPIO0_A5/I2S_D1_M0/UARTRX)
unnamed: R12.2, U3.C7 (I2C_ADDR)
RK628_INTN_3V3: R2.1, TP4.P$1, U3.J3 (INT/SPIBOOT); also elsewhere on the board
RK628_RSTN_3V3: C5.2, R56.1, TP11.P$1, U3.H4 (RESETN); also elsewhere on the board
RK628_XTALI: C13.2, U3.M9 (OSC_IN), Y5.1 (XIN)
RK628_XTALO: R6.1, U3.L9 (OSC_OUT)
VCC1V1_RK628: C30.1, U3.D8 (DVDD), U3.E9 (DVDD); also elsewhere on the board
VCCA1V1_RK628: C27.2, C28.2, C31.2, C32.2, C33.2, C34.2, U3.C5 (GVI/LVDS/MIPI_AVDD_1V1), U3.D4 (GVI/LVDS/MIPI_AVDD_1V1), U3.E3 (GVI/LVDS/MIPI_AVDD_1V1), U3.F3 (GVI/LVDS/MIPI_AVDD_1V1), U3.H9 (HDMIRX_DVDD_1V1), U3.J7 (PLL_AVDD_1V1), U3.J9 (HDMIRX_DVDD_1V1); also elsewhere on the board
VCCA3V3_RK628: C23.2, C25.2, C26.2, C29.2, CH1.2, U3.C3 (GVI/LVDS/MIPI_PLL_AVDD_3V3), U3.D5 (GVI/LVDS/MIPI_AVDD_3V3), U3.E4 (GVI/LVDS/MIPI_AVDD_3V3), U3.J10 (HDMIRX_AVDD_3V3), U3.M10 (PLL_AVDD); also elsewhere on the board
VCCIO2_1: U3.E8 (VCCIO2_1)
VCCIO2_2: U3.F8 (VCCIO2_2)
VCC_3V3: R1.2, R2.2, R48.2, R56.2, U3.H5 (VCCIO1); also elsewhere on the board

Notes on the sheet:
J10
C3/D5/E4
D4/E3/C5/F3
H9/J9
UART Access for debug
HDMI AUDIO
D8/E9

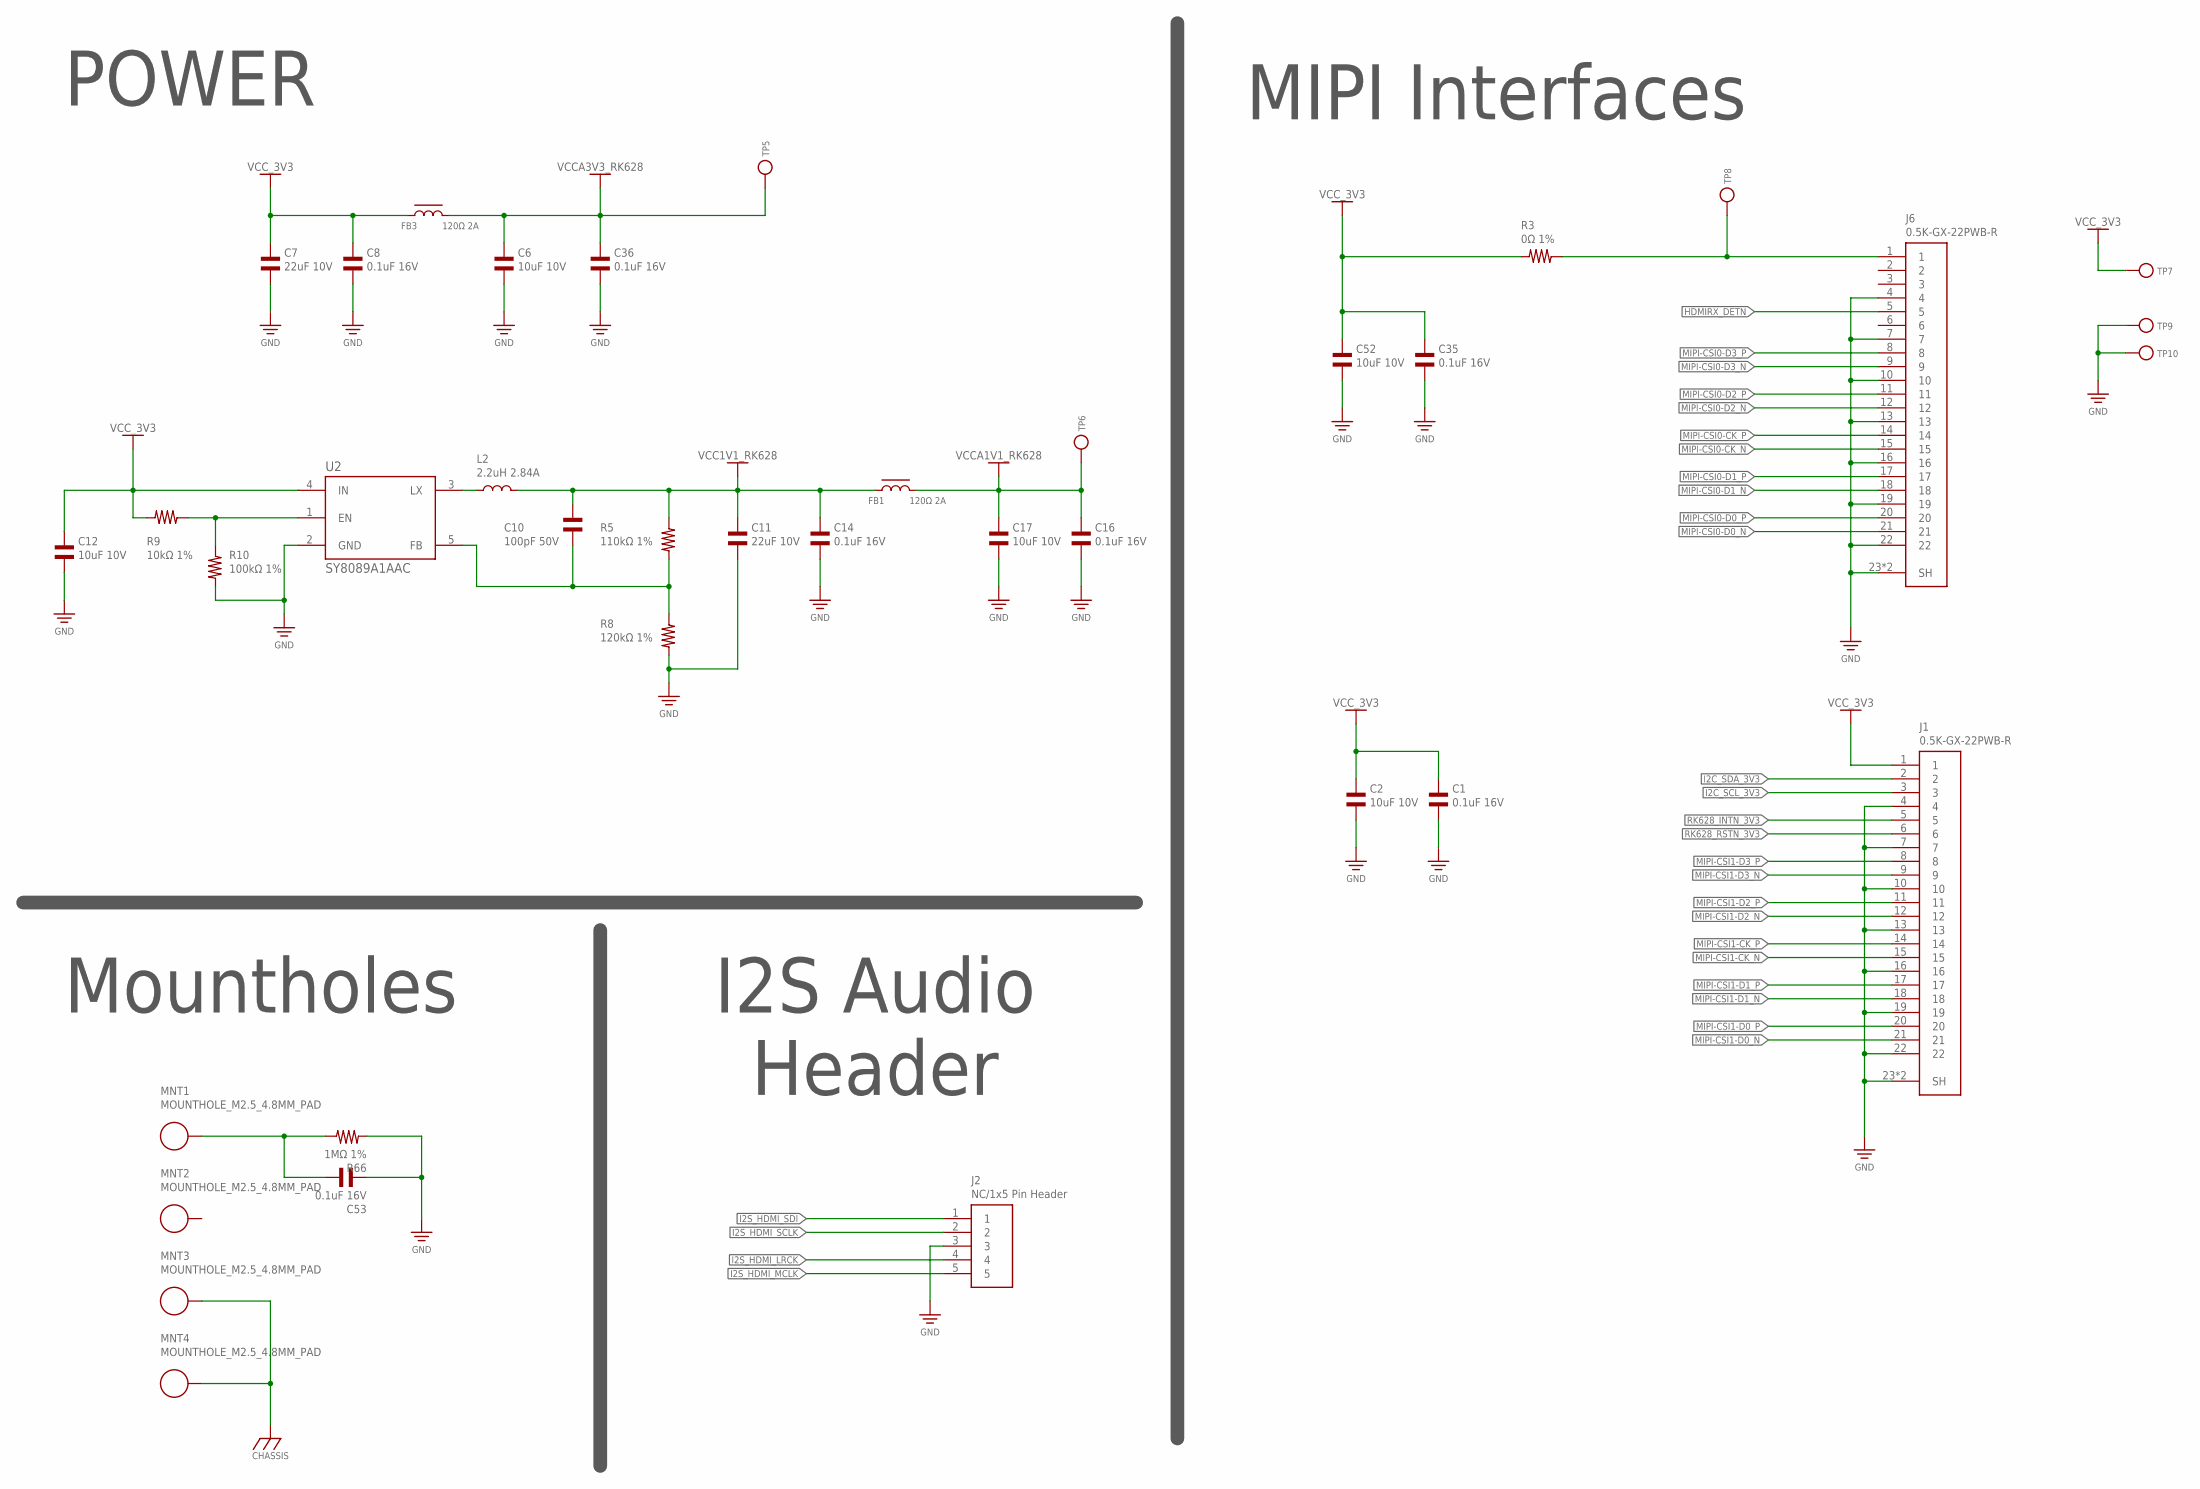
[picture p63: schematic RK628H-2x22P-RevA.sch, sheet 6, Power & Audio]

Parts:
C1, C8, C14, C16, C35, C36, C53: 0.1uF 16V; CAP_0402
C2, C6, C12, C17, C52: 10uF 10V; CAP_0402
C7, C11: 22uF 10V; CAP_0603
C10: 100pF 50V; CAP_0402
FB1, FB3: 120Ω 2A; IND_0603
J1, J6: 0.5K-GX-22PWB-R; CONN_FFC_1X22_0.5MM_SM_RA_0.5K-GX-22PWB-R
J2: NC/1x5 Pin Header; HDR_1X05_2.54MM_TH_ST
L2: 2.2uH 2.84A; IND_3MM_SQ_1.2MM_HEIGHT
MNT1, MNT2, MNT3, MNT4: MOUNTHOLE_M2.5_4.8MM_PAD
R3: 0Ω 1%; RES_0402
R5: 110kΩ 1%; RES_0402
R8: 120kΩ 1%; RES_0402
R9: 10kΩ 1%; RES_0402
R10: 100kΩ 1%; RES_0402
R66: 1MΩ 1%; RES_0402
TP5, TP6, TP7, TP8, TP9, TP10: TESTPOINT_1MM; TEST_POINT_1MM
U2: SY8089A1AAC; SOT95P285X110-5N

Connections:
CGND: MNT3.P$1, MNT4.P$1; also elsewhere on the board
GND: C1.2, C2.2, C6.1, C7.1, C8.1, C11.1, C12.1, C14.1, C16.1, C17.1, C35.2, C36.1, C52.2, C53.1, J1.4, J1.7, J1.10, J1.13, J1.16, J1.19, J1.22, J1.23 (SH), J1.24 (SH), J2.3, J6.4, J6.7, J6.10, J6.13, J6.16, J6.19, J6.22, J6.23 (SH), J6.24 (SH), R8.2, R10.2, R66.2, TP9.P$1, TP10.P$1, U2.2 (GND); also elsewhere on the board
HDMIRX_DETN: J6.5; also elsewhere on the board
I2C_SCL_3V3: J1.3; also elsewhere on the board
I2C_SDA_3V3: J1.2; also elsewhere on the board
I2S_HDMI_LRCK: J2.4; also elsewhere on the board
I2S_HDMI_MCLK: J2.5; also elsewhere on the board
I2S_HDMI_SCLK: J2.2; also elsewhere on the board
I2S_HDMI_SDI: J2.1; also elsewhere on the board
MIPI-CSI0-CK_N: J6.15; also elsewhere on the board
MIPI-CSI0-CK_P: J6.14; also elsewhere on the board
MIPI-CSI0-D0_N: J6.21; also elsewhere on the board
MIPI-CSI0-D0_P: J6.20; also elsewhere on the board
MIPI-CSI0-D1_N: J6.18; also elsewhere on the board
MIPI-CSI0-D1_P: J6.17; also elsewhere on the board
MIPI-CSI0-D2_N: J6.12; also elsewhere on the board
MIPI-CSI0-D2_P: J6.11; also elsewhere on the board
MIPI-CSI0-D3_N: J6.9; also elsewhere on the board
MIPI-CSI0-D3_P: J6.8; also elsewhere on the board
MIPI-CSI1-CK_N: J1.15; also elsewhere on the board
MIPI-CSI1-CK_P: J1.14; also elsewhere on the board
MIPI-CSI1-D0_N: J1.21; also elsewhere on the board
MIPI-CSI1-D0_P: J1.20; also elsewhere on the board
MIPI-CSI1-D1_N: J1.18; also elsewhere on the board
MIPI-CSI1-D1_P: J1.17; also elsewhere on the board
MIPI-CSI1-D2_N: J1.12; also elsewhere on the board
MIPI-CSI1-D2_P: J1.11; also elsewhere on the board
MIPI-CSI1-D3_N: J1.9; also elsewhere on the board
MIPI-CSI1-D3_P: J1.8; also elsewhere on the board
unnamed: J6.1, R3.1, TP8.P$1
unnamed: L2.1, U2.3 (LX)
unnamed: C53.2, MNT1.P$1, R66.1
unnamed: C10.1, R5.2, R8.1, U2.5 (FB)
unnamed: R9.1, R10.1, U2.1 (EN)
RK628_INTN_3V3: J1.5; also elsewhere on the board
RK628_RSTN_3V3: J1.6; also elsewhere on the board
VCC1V1_RK628: C10.2, C11.2, C14.2, FB1.1, L2.2, R5.1; also elsewhere on the board
VCCA1V1_RK628: C16.2, C17.2, FB1.2, TP6.P$1; also elsewhere on the board
VCCA3V3_RK628: C6.2, C36.2, FB3.2, TP5.P$1; also elsewhere on the board
VCC_3V3: C1.1, C2.1, C7.2, C8.2, C12.2, C35.1, C52.1, FB3.1, J1.1, R3.2, R9.2, TP7.P$1, U2.4 (IN); also elsewhere on the board

Notes on the sheet:
I2S Audio Header
POWER
MIPI Interfaces
Mountholes

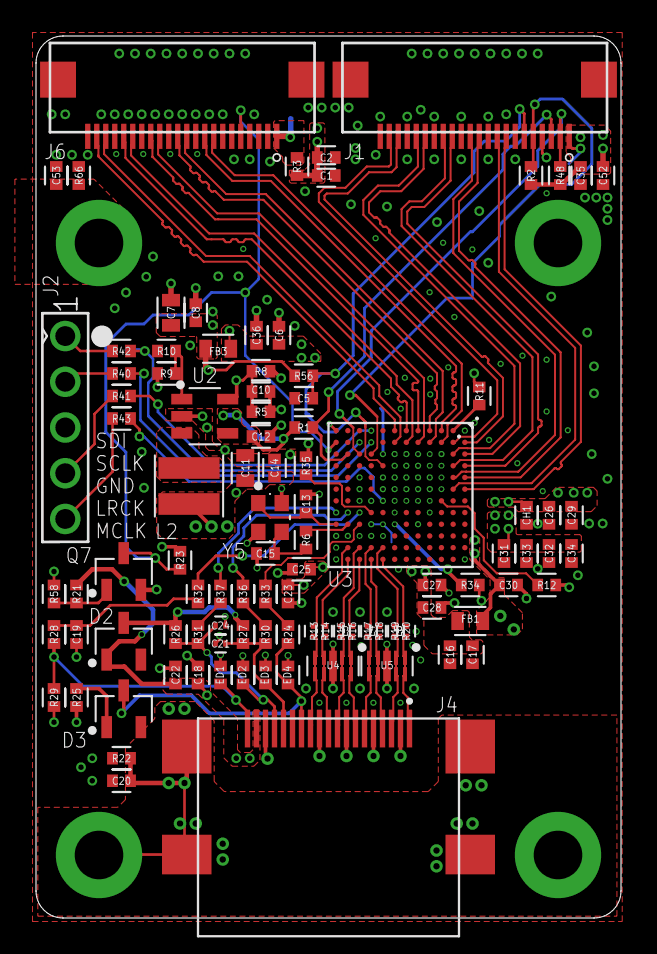
[picture p64: board RK628H-2x22P-RevA.brd from above]

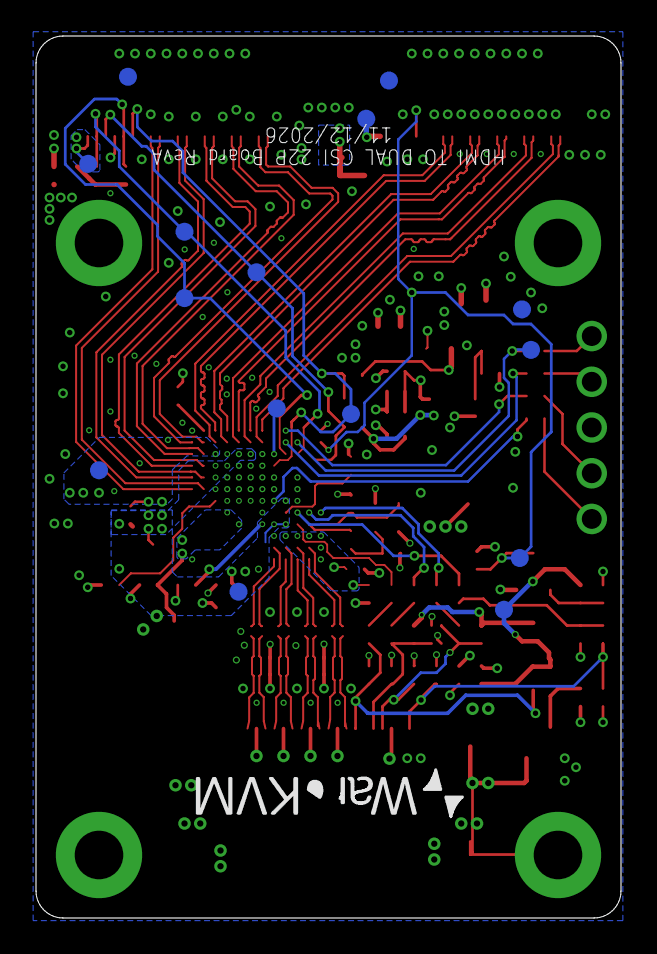
[picture p65: board RK628H-2x22P-RevA.brd from below]

Board: 4 copper layers, 32.5 x 49.0 mm, 121 parts (15 on the bottom side), 84 nets.
