WarpKVM/rk628-bridge-boards/hosts/raspberry-pi-cm4/driver/rk628_csi.h

/* SPDX-License-Identifier: GPL-2.0 */
/*
 * Copyright (c) 2020 Rockchip Electronics Co., Ltd.
 *
 * Modified by Ground Plane Studio, LLC, 2026: built as part of the
 * rk628-pi out-of-tree module for Raspberry Pi hosts. Changes are bug
 * fixes and the removal of Rockchip-platform-only dependencies.
 *
 * Author: Dingxian Wen <shawn.wen@rock-chips.com>
 */

#ifndef __RK628_CSI_H
#define __RK628_CSI_H

#include "rk628.h"

#define CSITX_BASE			0x00040000
#define CSITX_CONFIG_DONE		(CSITX_BASE + 0x0000)
#define CONFIG_DONE_IMD			BIT(4)
#define CONFIG_DONE			BIT(0)
#define CSITX_CSITX_EN			(CSITX_BASE + 0x0004)
#define VOP_YU_SWAP_MASK		BIT(14)
#define VOP_YU_SWAP(x)			UPDATE(x, 14, 14)
#define VOP_UV_SWAP_MASK		BIT(13)
#define VOP_UV_SWAP(x)			UPDATE(x, 13, 13)
#define VOP_YUV422_MODE_MASK		GENMASK(11, 10)
#define VOP_YUV422_MODE(x)		UPDATE(x, 11, 10)
#define VOP_YUV422_EN_MASK		BIT(12)
#define VOP_YUV422_EN(x)		UPDATE(x, 12, 12)
#define VOP_P2_EN_MASK			BIT(8)
#define VOP_P2_EN(x)			UPDATE(x, 8, 8)
#define LANE_NUM_MASK			GENMASK(5, 4)
#define LANE_NUM(x)			UPDATE(x, 5, 4)
#define DPHY_EN_MASK			BIT(2)
#define DPHY_EN(x)			UPDATE(x, 2, 2)
#define CSITX_EN_MASK			BIT(0)
#define CSITX_EN(x)			UPDATE(x, 0, 0)
#define CSITX_CSITX_VERSION		(CSITX_BASE + 0x0008)
#define CSITX_SYS_CTRL0_IMD		(CSITX_BASE + 0x0010)
#define CSITX_SYS_CTRL1			(CSITX_BASE + 0x0014)
#define BYPASS_SELECT_MASK		BIT(0)
#define BYPASS_SELECT(x)		UPDATE(x, 0, 0)
#define CSITX_SYS_CTRL2			(CSITX_BASE + 0x0018)
#define VOP_WHOLE_FRM_EN		BIT(5)
#define VSYNC_ENABLE			BIT(0)
#define ADV_READ_PLD_EN(x)		UPDATE(x, 8, 8)
#define ADV_READ_PLD_NUM(x)		UPDATE(x, 24, 16)
#define CSITX_SYS_CTRL3_IMD		(CSITX_BASE + 0x001c)
#define CONT_MODE_CLK_CLR_MASK		BIT(8)
#define CONT_MODE_CLK_CLR(x)		UPDATE(x, 8, 8)
#define CONT_MODE_CLK_SET_MASK		BIT(4)
#define CONT_MODE_CLK_SET(x)		UPDATE(x, 4, 4)
#define NON_CONTINUOUS_MODE_MASK		BIT(0)
#define NON_CONTINUOUS_MODE(x)		UPDATE(x, 0, 0)
#define CSITX_TIMING_HPW_PADDING_NUM	(CSITX_BASE + 0x0030)
#define CSITX_VOP_PATH_CTRL		(CSITX_BASE + 0x0040)
#define VOP_WC_USERDEFINE_MASK		GENMASK(31, 16)
#define VOP_WC_USERDEFINE(x)		UPDATE(x, 31, 16)
#define VOP_DT_USERDEFINE_MASK		GENMASK(13, 8)
#define VOP_DT_USERDEFINE(x)		UPDATE(x, 13, 8)
#define VOP_PIXEL_FORMAT_MASK		GENMASK(7, 4)
#define VOP_PIXEL_FORMAT(x)		UPDATE(x, 7, 4)
#define VOP_WC_USERDEFINE_EN_MASK	BIT(3)
#define VOP_WC_USERDEFINE_EN(x)		UPDATE(x, 3, 3)
#define VOP_DT_USERDEFINE_EN_MASK	BIT(1)
#define VOP_DT_USERDEFINE_EN(x)		UPDATE(x, 1, 1)
#define VOP_PATH_EN_MASK		BIT(0)
#define VOP_PATH_EN(x)			UPDATE(x, 0, 0)
#define CSITX_VOP_FILTER_CTRL		(CSITX_BASE + 0x0044)
#define VOP_FILTER_EN_MASK		BIT(0)
#define VOP_FILTER_EN(x)		UPDATE(x, 0, 0)
#define VOP_FILTER_MASK			GENMASK(15, 8)
#define VOP_FILTER(x)			UPDATE(x, 15, 8)
#define CSITX_VOP_PATH_PKT_CTRL		(CSITX_BASE + 0x0050)
#define CSITX_CSITX_STATUS0		(CSITX_BASE + 0x0070)
#define CSITX_CSITX_STATUS1		(CSITX_BASE + 0x0074)
#define STOPSTATE_LANE3			BIT(7)
#define STOPSTATE_LANE2			BIT(6)
#define STOPSTATE_LANE1			BIT(5)
#define STOPSTATE_LANE0			BIT(4)
#define STOPSTATE_CLK			BIT(1)
#define DPHY_PLL_LOCK			BIT(0)
#define CSITX_INTR_EN_IMD		(CSITX_BASE + 0x0080)
#define CSITX_ERR_INTR_EN_IMD		(CSITX_BASE + 0x0090)
#define CSITX_ERR_INTR_CLR_IMD		(CSITX_BASE + 0x0094)
#define CSITX_ERR_INTR_STATUS_IMD	(CSITX_BASE + 0x0098)
#define CSITX_ERR_INTR_RAW_STATUS_IMD	(CSITX_BASE + 0x009c)
#define CSITX_LPDT_DATA_IMD		(CSITX_BASE + 0x00a8)
#define CSITX_DPHY_CTRL			(CSITX_BASE + 0x00b0)
#define CSI_DPHY_EN_MASK		GENMASK(7, 3)
#define CSI_DPHY_EN(x)			UPDATE(x, 7, 3)
#define CSI_INT_EN_MASK			GENMASK(7, 6)
#define CSI_INT_EN(x)			UPDATE(x, 7, 6)
#define CSI_INT_WRITE_EN_MASK		GENMASK(23, 22)
#define CSI_INT_WRITE_EN(x)		UPDATE(x, 23, 22)
#define DPHY_ENABLECLK			BIT(3)
#define CSI_MAX_REGISTER		CSITX_DPHY_CTRL
//for rk628f csi1
#define CSITX1_BASE			0x00140000
#define CSITX1_CONFIG_DONE		(CSITX1_BASE + 0x0000)
#define CSITX1_CSITX_EN			(CSITX1_BASE + 0x0004)
#define CSITX1_CSITX_VERSION		(CSITX1_BASE + 0x0008)
#define CSITX1_SYS_CTRL0_IMD		(CSITX1_BASE + 0x0010)
#define CSITX1_SYS_CTRL1		(CSITX1_BASE + 0x0014)
#define CSITX1_SYS_CTRL2		(CSITX1_BASE + 0x0018)
#define CSITX1_SYS_CTRL3_IMD		(CSITX1_BASE + 0x001c)
#define CSITX1_TIMING_HPW_PADDING_NUM	(CSITX1_BASE + 0x0030)
#define CSITX1_VOP_PATH_CTRL		(CSITX1_BASE + 0x0040)
#define CSITX1_VOP_FILTER_CTRL		(CSITX1_BASE + 0x0044)
#define CSITX1_VOP_PATH_PKT_CTRL	(CSITX1_BASE + 0x0050)
#define CSITX1_CSITX_STATUS0		(CSITX1_BASE + 0x0070)
#define CSITX1_CSITX_STATUS1		(CSITX1_BASE + 0x0074)
#define CSITX1_INTR_EN_IMD		(CSITX1_BASE + 0x0080)
#define CSITX1_ERR_INTR_EN_IMD		(CSITX1_BASE + 0x0090)
#define CSITX1_ERR_INTR_CLR_IMD		(CSITX1_BASE + 0x0094)
#define CSITX1_ERR_INTR_STATUS_IMD	(CSITX1_BASE + 0x0098)
#define CSITX1_ERR_INTR_RAW_STATUS_IMD	(CSITX1_BASE + 0x009c)
#define CSITX1_LPDT_DATA_IMD		(CSITX1_BASE + 0x00a8)
#define CSITX1_DPHY_CTRL		(CSITX1_BASE + 0x00b0)
#define CSI1_MAX_REGISTER		CSITX1_DPHY_CTRL

#define CSI_SKIP_FRAME_NORMAL		1

enum csi_pixfmt {
	CSI_RAW8 = 0,
	CSI_RAW10,
	CSI_PIXEL10,
	CSI_PIXEL128,
	CSI_RAW12,
	CSI_PIXEL12,
};

enum csi_datatype {
	YUV422_8BIT = 0x1e,
	YUV422_10BIT = 0x1f,
};

#endif
